SunoopDogg/airo-tips/index.md

---
title: index
type: overview
tags: [meta]
created: 2026-09-04
updated: 2026-10-07
status: developing
sources: []
---

# index

이 위키의 전 페이지 목록이다. 질의는 여기서 시작한다. 형식과 규약은 저장소 루트의 스키마 문서를 따른다.

### Overview

ESS(리튬 배터리 에너지저장장치) 열폭주 조기감지 개발 프로젝트의 지식 베이스. 원문이 `raw/`로 들어오면 인제스트를 거쳐 위키가 그 위에 인물·조직·제품·현상·지표·시험조건을 정리한다. **위키에는 인제스트된 원문에서 나온 내용만 담는다.**

프로젝트는 [[이스트오토]]가 발주하고 [[에어로랩]]이 수행하는 개발 용역이다. 개발 완료 검수 기준은 [[정량적 성과지표]] 다섯 항목을 모두 달성하는 것이고, 이 다섯이 사실상 프로젝트의 목표다.

### Topics

- [[에어로랩]] — 이 프로젝트의 개발 수행사. 계약상 "을".
- [[이스트오토]] — 발주사. 계약상 "갑"이며 하드웨어와 인증 경비를 부담한다.
- [[한국산업기술시험원]] — 지표 3 국내 성능수준의 출처이자 근거 문헌의 공동 연구기관.
- [[SEN55]] — 센시리온 환경센서 노드. 모의장치의 환경 센서로 확정, 3대 구매.
- [[ESP32-S3-WROOM-1]] — 에스프레시프 MCU 모듈(N16R8). SEN55 3대를 PCA9548A 경유로 읽어 USB로 PC에 중계하는 컨트롤러.
- [[PCA9548A]] — TI의 8채널 I2C 멀티플렉서. SEN55 3대의 주소 충돌을 채널 분리로 해결.
- [[P82B715]] — TI의 I2C 버스 익스텐더. PCA9548A~SEN55 배선 10 cm 초과 문제를 풀려고 채널마다 한 쌍씩 쓴다.
- [[정량적 성과지표]] — 검수 기준이 되는 다섯 개 목표치(비중 합 90%, 나머지는 제거된 항목). 이 프로젝트의 목표.
- [[불꽃검출 알고리즘]] — SIFT·스케일 기반 불꽃/연기 검출 AI. 지표 1·2를 담당한다.
- [[배터리 화재감지 5단계]] — 정상·비배터리화재·벤팅·열폭주·ESS화재 다섯 단계 분류 알고리즘. 지표 3.
- [[ESS-BMS 연동 데이터]] — BMS에서 수집해야 하는 7종 데이터. 지표 4.
- [[열폭주]] — 이 프로젝트가 막으려는 현상. 벤팅 이후 약 2분 만에 도달한다.
- [[벤팅 가스]] — 열폭주 직전의 마지막 뚜렷한 신호. 조기감지의 축이 되는 오프가스.
- [[모의장치]] — 지표 3 검수를 시연하는 밀폐 챔버 장치. SEN55 3대 + ESP32-S3 + 별도 카메라.
- [[EnerX-0.5P]] — CATL 상용 액체냉각 컨테이너 ESS. H2·CO·열·연기 조합 판정과 BMS 데이터의 참고 사례.
- [[VOC Index]] — 적응형 기준선 위의 1–500 상대 지표. 조건마다 상태를 복원하고 임계값으로 벤팅을 판정한다.

### Sources

- [[개발용역 계약서]] — 이스트오토·에어로랩 개발 용역 계약서. 용역범위와 검수 기준의 원천.
- [[정량적 성과지표 항목표]] — 다섯 지표의 근거·벤치마크·평가 방법 상세본.
- [[ESS 화재감지 알고리즘 (2023 추계학술발표논문집)]] — 최형석 외 2023. 지표 3 다섯 단계의 근거 문헌.
- [[Sensirion SEN5x Datasheet]] — SEN5x 제품군 데이터시트 V2-D1(2022-03). SEN55 사양의 출처.
- [[ESP32-S3-WROOM-1 & WROOM-1U Datasheet]] — 에스프레시프 모듈 데이터시트 v1.4(2024-11). 컨트롤러 사양의 출처.
- [[PCA9548A Datasheet]] — TI PCA9548A 데이터시트 SCPS143G(2021-03 개정). 멀티플렉서 사양의 출처.
- [[P82B715 Datasheet]] — TI P82B715 데이터시트 SCPS145B(2016-02 개정). 버스 익스텐더 사양과 풀업 설계 절차의 출처.
- [[EnerX-0.5P Battery Container Operating Instruction and Maintenance Manual]] — CATL EnerX-0.5P O&M 매뉴얼 Rev 1.0 초안(2024-08). 상용 ESS의 FSS·BMS 동작의 출처.
