SunoopDogg/airo-tips/log.md

---
title: log
type: overview
tags: [meta]
created: 2026-09-04
updated: 2026-10-07
status: developing
sources: []
---

# log

작업 이력. 새 항목은 맨 아래에 덧붙인다. 과거 항목은 고치지 않는다. 형식: `## [YYYY-MM-DD] ingest|query|lint | 대상`

## [2026-09-04] ingest | 개발용역 계약서 · 정량적 성과지표 항목표
계약서와 정량적항목 xlsx를 함께 읽어 [[개발용역 계약서]], [[정량적 성과지표 항목표]] source 페이지를 만들고 [[이스트오토]], [[에어로랩]], [[정량적 성과지표]], [[불꽃검출 알고리즘]], [[배터리 화재감지 5단계]], [[ESS-BMS 연동 데이터]]를 생성했다. 계약서 원문이 미서명 초안(계약기간·지급일·갑 서명란 공란)임을 기록하고, 지표 비중 합계가 90%에 그치는 문제를 [[정량적 성과지표]]에 남겼다. 다섯 항목이 알고리즘 출력 단계인지 시험 조건인지 두 원문이 어긋나는 점을 [[배터리 화재감지 5단계]] Contradictions에 기록.

## [2026-09-04] ingest | ESS 화재감지 알고리즘 (2023 추계학술발표논문집)
[[정량적 성과지표]] 지표 3의 근거 문헌인 최형석 외 2023 논문을 인제스트. [[ESS 화재감지 알고리즘 (2023 추계학술발표논문집)]] source 페이지와 [[열폭주]], [[벤팅 가스]], [[모의장치]], [[한국산업기술시험원]]을 생성했다. [[배터리 화재감지 5단계]]의 Contradictions를 해소 — 다섯 단계를 정상·비배터리화재·벤팅·열폭주·ESS화재로 확정하고, 계약서의 다습·먼지·고온은 오탐 내성을 보는 시험 조건임을 논문 근거로 판정했다. 먼지 신호가 오탐 조건이면서 동시에 열폭주 시그니처라는 설계 난점, 벤팅→열폭주 2분 24초 실측, 벤팅 시점에 산소·먼지·압력·LEL이 침묵한다는 점을 같은 페이지에 기록. [[ESS-BMS 연동 데이터]]에 전압 신호의 셀 형태 의존을, [[불꽃검출 알고리즘]]에 연기 채널이 단계 판정에서 맡는 자리를, [[정량적 성과지표]]와 [[정량적 성과지표 항목표]]에 지표 3 확정 사실과 인용 판본 차이를 추가했다. [[개발용역 계약서]]와 [[에어로랩]]의 용역범위 2항에도 이 다섯이 시험 조건이라는 주석을 달았다.

## [2026-09-07] ingest | Sensirion SEN5x Datasheet
SEN5x 데이터시트를 인제스트하고 [[Sensirion SEN5x Datasheet]], [[SEN55]], [[VOC Index]]를 생성. [[모의장치]]의 센서부를 SEN55 3대 확정으로 다시 쓰고(항목표의 센서 4종이 한 모듈로 접힘), 시험 조건(가습기·열풍기)과 센서 동작 조건(권장 10–40 °C / 20–80 %RH, 결로 금지)이 만나는 지점을 Contradictions로 기록. 센서 운용 미결 항목(벤팅 검출 규칙, 조건 사이 VOC 알고리즘 상태, 팬 자동 청소, 3대 배선, 온도 보정·가속 모드)을 같은 페이지에 추가. [[벤팅 가스]]의 "무엇으로 검출하는가" 절을 VOC Index 검출로 다시 쓰고, [[배터리 화재감지 5단계]]의 구현 차이 표를 SEN55 채널 매핑으로 갱신하면서 논문 진리표의 ○/✕를 만들 규칙이 없다는 점과 차동식 열감지기↔온도값의 차이를 기록. [[정량적 성과지표]] 지표 3에 센서 확정 사실을 추가.

## [2026-09-07] ingest | 사용자 확인 · 모의장치 센서 운용 결정
사용자 구두 확인으로 미결 항목을 정리. [[모의장치]]의 미결 목록을 "정해진 것/남은 것"으로 다시 씀 — SEN55 3대를 ESP 1대에 연결, 조건마다 VOC 알고리즘 상태 복원으로 같은 출발점, 벤팅 판정은 임계값 방식(값은 미정), RH/T 가속 모드 중, 조건당 45초, 팬 청소 무관, 챔버 밀폐 시험. Contradictions에 밀폐의 영향과 도달값 실측 방침을 추가. [[SEN55]], [[VOC Index]]에 같은 결정을 반영. [[배터리 화재감지 5단계]] Contradictions의 계약 문언 미결을 해소(계약서의 5단계 = 논문의 5단계). [[정량적 성과지표]], [[개발용역 계약서]], [[정량적 성과지표 항목표]]의 비중 10%를 제거된 여섯 번째 항목의 잔재로 확정. [[index]] 요약 세 줄 갱신.

## [2026-09-07] lint | 일반지식 확장 세 곳 정리
[[한국산업기술시험원]]의 "KTL·공공 시험·인증기관", [[에어로랩]]의 "Airo Lab", [[벤팅 가스]]의 "DEC(디에틸카보네이트)". [[정량적 성과지표]] 표의 "UL"을 항목표 원문 표기 Underwriters Laboratories로, "인제스트해 확정했다"를 주제 서술로 고침. [[벤팅 가스]]·[[열폭주]] 첫 문단 정의를 논문 표현으로 교체. 논문 source 페이지의 [[UL9540A]] 링크를 평문으로 풀고 `updated` 갱신.
## [2026-09-07] ingest | ESP32-S3-WROOM-1 & WROOM-1U Datasheet · 사용자 확인 · 컨트롤러 연결 결정
ESP32-S3 모듈 데이터시트 v1.4를 인제스트하고 [[ESP32-S3-WROOM-1 & WROOM-1U Datasheet]], [[ESP32-S3-WROOM-1]]을 생성. 사용자 확인으로 컨트롤러 결정 7건을 정리 — 변형 N16R8, 3대 연결은 HW I2C 2버스 + 소프트웨어 I2C 1버스, 모듈은 챔버 안 센서 옆, PC 연결은 USB Serial/JTAG CDC-ACM, SEN55 5 V는 USB VBUS 분기, VOC 상태 저장·복원은 PC가 명령하고 ESP는 중계, 카메라는 별도 장비. [[모의장치]]의 "정해진 것"을 이 결정으로 다시 쓰고 Contradictions에 모듈 65 °C 상한과 기판 결로를 추가. [[SEN55]] I2C 단락에 3.3 V 논리 레벨 호환과 배선 결정을, [[Sensirion SEN5x Datasheet]] 인터페이스 절에 Table 8 입력 레벨을, [[VOC Index]]에 상태 복원 주체를 추가. [[index]] 세 줄 갱신.

## [2026-09-07] ingest | 2023 논문 그림 4 온도 수치 보강
논문 PDF의 그림 4를 렌더링해 온도 눈금을 읽음. [[ESS 화재감지 알고리즘 (2023 추계학술발표논문집)]] 시험 A 결과와 [[열폭주]] 신호 거동에 벤팅 약 170–180℃, 열폭주 피크 약 550℃를 추가.

## [2026-09-07] ingest | PCA9548A Datasheet · 사용자 확인 · 멀티플렉서 연결 결정
PCA9548A 데이터시트 SCPS143G를 인제스트하고 [[PCA9548A Datasheet]], [[PCA9548A]]를 생성. 기존의 "HW I2C 2버스 + 소프트웨어 I2C 1버스" 연결 방식을 대체 — ESP32-S3 I2C 1버스를 PCA9548A에 물리고 채널 0~2에 SEN55 3대를 잇는다. 사용자 확인으로 주소는 A0=A1=A2=GND(0x70), RESET 핀은 VCC 풀업만, 배치는 챔버 안 ESP32·SEN55 옆으로 정함. [[ESP32-S3-WROOM-1]]의 "SEN55 3대 연결" 절과 배선 길이 서술을 다시 쓰고, [[SEN55]] I2C 단락과 [[모의장치]]의 "정해진 것"·Contradictions·관련 페이지를 갱신. [[index]] 두 줄 추가.

## [2026-09-07] ingest | 사용자 확인 · 전장 배치 변경(챔버 외부)
ESP32-S3-WROOM-1과 PCA9548A를 챔버 상단 외부로, SEN55 3대만 챔버 내부에 두는 것으로 배치를 바꿈. [[ESP32-S3-WROOM-1]]의 동작온도·배선 길이 서술과 [[PCA9548A]]의 배치 서술을 갱신. [[모의장치]]의 "정해진 것" 배치 항목을 다시 쓰고, 컨트롤러 결로 관련 Contradictions 항목을 PCA9548A~SEN55 배선이 챔버 벽을 가로지르며 10 cm 권고와 부딪히는 항목으로 교체, "남은 것"에 배선 길이·차폐 방식을 추가.

## [2026-09-07] ingest | P82B715 Datasheet · 사용자 확인 · 배선 연장 고려사항
TI P82B715 I2C 버스 익스텐더 데이터시트를 인제스트. [[P82B715 Datasheet]], [[P82B715]] 생성. PCA9548A~SEN55 배선 10 cm 초과 문제의 후보 해법으로 P82B715(채널당 한 쌍, VCC 5 V)와 차폐 케이블을 고려 중이며 둘 다 미확정임을 [[모의장치]]의 "남은 것"과 Contradictions, [[ESP32-S3-WROOM-1]]·[[PCA9548A]]·[[SEN55]]의 배선 서술에 반영.

## [2026-09-07] lint | 위키 2-type 이행 — topic + source
entity·concept·note를 topic 하나로 합치고 wiki/topics/로 옮김. 15개 페이지의 type과 위치가 바뀌었고 본문·제목·위키링크는 그대로다. CLAUDE.md의 type↔폴더 표를 3행으로 줄이고 "경계가 애매한 것들의 판정" 절을 삭제. index.md의 Entities·Concepts·Notes 세 절을 Topics 하나로 합침. check.py의 FOLDER·SECTION, wiki-lint·wiki-ingest·wiki-query의 폴더 참조를 맞춤.

## [2026-09-07] lint | source 페이지 정리 — 원문 밖 서술 제거
source 페이지 5건에서 원문 밖의 서술을 걷어냈다. [[ESS 화재감지 알고리즘 (2023 추계학술발표논문집)]]의 "이 위키에서의 위치"·"이 위키 관점에서의 한계"·인용 지침, [[정량적 성과지표 항목표]]와 [[개발용역 계약서]]의 교차 판정과 `(사용자 확인)`, [[Sensirion SEN5x Datasheet]]·[[ESP32-S3-WROOM-1 & WROOM-1U Datasheet]]의 프로젝트 서술이 대상이다. 삭제분은 전부 topic 페이지에 이미 인용과 함께 있고, 유일한 예외였던 표6 마지막 구간의 인위적 열자극 단서는 [[열폭주]]로 옮겼다. CLAUDE.md에 "source 페이지는 그 원문만 서술한다" 절을 추가.

## [2026-09-07] lint | 소프트랩 적용 — 저장소 전체 .md
CLAUDE.md와 wiki-ingest·wiki-lint·wiki-query 스킬 문서의 하드랩을 풀어 한 문단을 한 줄로 만들었다. 위키 페이지와 index.md는 이미 규칙을 지키고 있었고, 직전 로그 항목만 하드랩이라 함께 폈다. "한 문단은 한 줄" 규칙의 적용 범위를 위키 본문에서 저장소의 모든 .md로 넓혀 CLAUDE.md에 명시.

## [2026-09-08] ingest | EnerX-0.5P Battery Container Operating Instruction and Maintenance Manual
CATL EnerX-0.5P 컨테이너 O&M 매뉴얼(Rev 1.0 초안, 2024-08)을 인제스트. [[EnerX-0.5P Battery Container Operating Instruction and Maintenance Manual]], [[EnerX-0.5P]] 생성. 상용 ESS가 H2·CO·열·연기 검출기의 조합으로 등급을 나누고 가스를 최우선 트리거로 둔다는 점을 [[배터리 화재감지 5단계]]·[[벤팅 가스]]·[[열폭주]]에, 상용 BMS의 데이터·인터페이스·고장등급을 [[ESS-BMS 연동 데이터]]에, 참고 한 줄을 [[모의장치]]에 반영. 원문 내부의 수치 불일치(셀 구성·랙당 모듈 수·IMM 수·등급 수)는 source 페이지에 기록.

## [2026-10-06] ingest | 사용자 확인 · 모의장치 챔버 구성과 P82B715 채택
사용자가 확인한 챔버 형상 결정(더미 팩, 3030 프로파일과 알루미늄 복합판, 오른쪽 경첩의 앞면 여닫이 아크릴 도어와 토글 클램프, 양 옆면에서 마주 보는 주입·배기 포트, 캐스터 4개)을 [[모의장치]]의 새 "챔버 구성" 절에 반영. SEN55 3대의 천장 120° 대칭 배치를 [[모의장치]]·[[SEN55]]에, 전장 기판이 자체 PCB라는 것을 [[모의장치]]·[[PCA9548A]]에 추가. 고려 중이던 [[P82B715]] 채택을 [[P82B715]]·[[모의장치]]·[[PCA9548A]]·[[ESP32-S3-WROOM-1]]·[[SEN55]]와 index 요약에 반영하고, 차폐 케이블 사용 여부는 미정으로 남김.

## [2026-10-06] ingest | 사용자 확인 · 모의장치 더미 팩과 챔버 세부
[[모의장치]]의 "챔버 구성" 절에 더미가 본뜨는 ESS 모듈(32 kWh, 134.4 V, 22 A, LiFePO4, 1130 × 810 × 260 mm, 눕혀 놓음)과 패널 3 mm·아크릴 도어 8 mm, 경첩 3개·토글 클램프 2개·손잡이, 포트 높이, 브레이크 캐스터, SEN55 중심 거리를 천장 크기에 맞춘다는 결정을 추가.

## [2026-10-06] ingest | 사용자 확인 · 모의장치 팩 받침과 SEN55 케이블 경로
[[모의장치]]의 "챔버 구성" 절에 더미 팩을 3030 프로파일 세로 다리 레일 받침으로 100 mm 띄운다는 것, SEN55 한 대를 앞쪽에 두는 기준 방향, SEN55 케이블이 전장함 바로 아래에서 천장을 관통한다는 결정을 추가.

## [2026-10-06] ingest | 사용자 확인 · 모의장치 내부 치수와 포트 높이
[[모의장치]]의 "챔버 구성" 절에 팩 둘레 여유(앞 80, 뒤 80, 왼쪽 100, 오른쪽 150, 위 300 mm)와 그에 따른 내부 치수 1380 × 970 × 660 mm를 추가. 포트 높이를 옆면 가운데에서 팩 윗면과 천장의 가운데(510 mm)로 바꿈.

## [2026-10-07] ingest | Sensirion SEN5x Datasheet · 외형 치수
이미 인제스트한 데이터시트의 7.1절 외형도(Figure 7)를 다시 읽어 [[Sensirion SEN5x Datasheet]]에 "외형 치수" 절을 추가하고, [[SEN55]]에 "외형" 절(52.3 × 43.3 mm, 두께 최대 22.3 mm·본체 13.2 mm, 무게 36.4 g)을 추가. 외형도는 그림이라 텍스트 추출이 되지 않아 페이지를 렌더링해 읽었다.

## [2026-10-07] ingest | 사용자 확인 · 모의장치 패널 체결, 도어 개구, SEN55 배치, 받침 레일
[[모의장치]]의 "챔버 구성" 절에 패널을 골조 바깥면에 스프링 너트와 볼트로 덧대는 것, 도어 개구 1230 × 460 mm, SEN55 반지름(천장 짧은 변의 1/4)과 천장 이격 20 mm, 받침 레일 구성(깊이 방향 2줄, 팩 끝에서 100 mm 안쪽)을 추가. [[SEN55]]에 브래킷 이격 한 문장을 추가.

## [2026-10-07] ingest | 사용자 확인 · 모의장치 골조 이음, 바닥, 도어 철물, 포트 구경, 전장부
모의장치 부품 형상에 남아 있던 결정을 받았다. [[모의장치]]의 챔버 구성에 3030 단면과 골조 이음, 바닥 패널과 보강재, 도어 겹침·밀폐재·경첩·손잡이, 토글 래치로 바꾼 잠금, 포트 구경, 캐스터 크기를 넣었다.
같은 절에 SEN55 브래킷의 부착면·자세·고정 방식, 전장함 위치, 케이블 글랜드, 전장 기판 외곽을 추가하고 [[P82B715]] 센서측 기판 위치를 연결했다.

## [2026-10-07] ingest | 사용자 확인 · 모의장치 도어 잠금 철물
도어 잠금을 당기는 토글 래치에서 누름형 토글 클램프로 되돌렸다. 래치를 도어 앞면과 같은 평면에 달면 도어를 옆으로만 당기고 밀폐재 쪽으로 누르지 못하기 때문이다. [[모의장치]]의 챔버 구성 절을 고쳤다.
