SunoopDogg/airo-tips/cad/chamber.md

# 챔버 파라미터 대장

챔버 치수 하나하나에 대해 값과 상태와 근거를 적는다. 아래 표의 변수명은 `src/params.py`의 상수명과 같게 쓴다. 상태 어휘는 셋이다.

- `fixed` — 근거와 함께 확정된 값. `src/params.py`에 상수로 들어간다.
- `dependent` — 아직 값은 없지만 무엇이 정해지면 따라 정해지는지가 분명한 값. `src/params.py`에는 다른 상수로 계산하는 식으로 들어가고, 수치를 지어내지 않는다.
- `unknown` — 근거도 종속 조건도 아직 없는 값. 결정을 기다리며 `src/params.py`에 넣지 않는다.

값을 채울 때는 근거를 함께 적는다. 근거는 위키에 이미 서술된 사실이거나 사용자가 직접 결정한 값이어야 하고, 후자는 `사용자 결정 2026-09-10`처럼 결정한 날을 적는다.

## 위키가 확정한 형상 제약

수치는 아니지만 형상을 구속하는 사실들이다. 출처는 전부 `wiki/topics/모의장치.md`다.

| 제약 | 상태 |
|---|---|
| 도어를 통해 열고 닫을 수 있다 | fixed (사용자 확인 2026-09-04) |
| 시험은 밀폐 상태로 진행한다 | fixed (사용자 확인 2026-09-07) |
| SEN55 3대를 챔버 내부에 직접 노출되도록 둔다 | fixed (사용자 확인 2026-09-07) |
| ESP32-S3-WROOM-1과 PCA9548A는 챔버 상단 외부에 둔다 | fixed (사용자 확인 2026-09-07) |
| 전원과 통신은 USB 하나로 통합한다 | fixed (사용자 확인 2026-09-07) |
| 다섯 조건을 가습기 · 청소기 · 송풍기 · DEC 분사 · 열풍기로 조성한다 | fixed (정량적 성과지표 항목표) |
| 조건 사이에 이전 조건을 빼내는 환기 절차가 필요하다 | fixed (사용자 확인 2026-09-07) |
| 카메라는 이 장치와 별개의 장비다 | fixed (사용자 확인 2026-09-04) |

두 제약이 서로 당긴다. 전장이 챔버 상단 외부이고 SEN55는 챔버 내부이므로 I2C 배선이 챔버 벽을 가로지르며, SEN5x 데이터시트의 10 cm 미만 권고를 넘기기 쉽다. 케이블 관통 위치와 센서 위치를 정할 때 이 거리가 함께 결정된다.

## 사용자가 결정한 형상

근거는 전부 사용자 결정(2026-10-06, 2026-10-07)이고, 같은 결정이 `wiki/topics/모의장치.md`의 "챔버 구성" 절에도 들어가 있다.

| 결정 | 상태 |
|---|---|
| 시료 팩은 실제 배터리가 아니라 ESS 배터리 모듈 하나의 외형만 본뜬 더미이고, 높이가 가장 작은 변이 되도록 눕혀 놓는다 | fixed |
| 외함은 알루미늄 프로파일 3030 골조 바깥면에 알루미늄 복합판 패널을 스프링 너트와 볼트로 덧댄다 (2026-10-07) | fixed |
| 받침 프레임 없이 바닥 프로파일에 캐스터 4개를 직접 단다 | fixed |
| 도어는 앞면 여닫이이고, 경첩 3개를 앞에서 보아 오른쪽 변의 위·가운데·아래에 단다 | fixed |
| 도어는 왼쪽 변 위·아래의 토글 클램프 2개로 밀폐재에 눌러 잠그고, 손잡이를 따로 왼쪽 변 가운데에 단다 | fixed |
| 캐스터 4개는 모두 브레이크가 달린 것이다 | fixed |
| 주입·배기 포트는 둘 다 팩 윗면과 천장의 가운데 높이에 낸다. 처음 정한 "옆면 높이의 가운데"를 바꾼 것이다 | fixed |
| 팩 둘레 여유는 앞 80, 뒤 80, 왼쪽(배기) 100, 오른쪽(주입) 150, 위 300 mm다 | fixed |
| SEN55의 천장 중심 거리는 천장 짧은 변의 1/4이고, 천장에서 20 mm 띄운다 (2026-10-07) | fixed |
| SEN55 세 대 중 한 대는 앞쪽(도어 쪽), 두 대는 뒤쪽 좌·우에 놓는다 | fixed |
| 더미 팩은 3030 프로파일 레일 받침 위에 올린다. 레일은 깊이 방향 2줄, 중심이 팩 좌우 끝에서 100 mm 안쪽이고, 줄마다 세로 다리 2개를 단다 (2026-10-07) | fixed |
| 도어 개구는 앞면 전체가 아니라 바닥부터 시작해 팩 좌우로 50 mm, 팩 윗면 위로 100 mm를 둔 크기다 (2026-10-07) | fixed |
| SEN55 케이블은 전장함 바로 아래에서 천장을 관통한다 | fixed |
| 도어 판 전체를 아크릴로 하고 관찰창을 따로 두지 않는다. 카메라와 그 고정부는 만들지 않는다 | fixed |
| SEN55 3대는 천장에 두고, 천장 중심에서 같은 거리에 120° 간격으로 대칭 배치한다 | fixed |
| 공용 주입 포트는 앞에서 보아 오른쪽 옆면, 배기 포트는 왼쪽 옆면에 마주 보게 둔다 | fixed |
| 전장 기판은 자체 PCB다 | fixed |
| P82B715 버스 익스텐더를 쓴다 | fixed |
| 3030 프로파일은 B형 슬롯 8 단면이다. step.parts `profile_3030_b_slot8`의 단면을 부재 길이만큼 늘인다 (2026-10-07) | fixed |
| 골조는 세로재 4개를 통짜로 두고 폭·깊이 방향 수평재를 그 사이에 넣는다. 이음은 step.parts `corner_bracket_3030_single_simple`(L자, 날개 45 × 45, 폭 30)을 수평재 끝마다 1개, 챔버 안쪽 모서리에 둔다. 처음 정한 `extrusion_3030_slot8_inside_corner_bracket_standard`는 L자가 아닌 50 × 30 × 3 평판이라 바꿨다. 레일과 다리의 이음 브래킷은 그리지 않는다 (2026-10-07) | fixed |
| 도어 개구 둘레에는 골조 부재를 따로 두지 않는다 (2026-10-07) | fixed |
| 바닥에도 패널을 대고, 레일 밑에 깊이 방향 3030 보강재 2개를 넣어 받침 다리를 그 위에 세운다. 다리는 레일 양 끝에 단다 (2026-10-07) | fixed |
| 패널은 여섯 면 모두 골조 바깥면 크기 그대로이고, 골조 볼트·도어 개구·포트·글랜드 구멍만 뚫는다. 철물을 다는 볼트 구멍은 각 철물 모델에서만 보인다 (2026-10-07) | fixed |
| 도어 판은 개구 둘레에 30 mm씩 겹친다. 밀폐재는 앞면 패널 바깥면의 개구 둘레, 겹침 폭의 가운데에 붙이는 EPDM 스펀지 사각 단면이며 모서리는 각지게 둔다. 도어는 밀폐재에 닿은 압착 전 상태로 그린다 (2026-10-07) | fixed |
| 경첩은 50 × 50 맞대기 경첩 3개다. step.parts `butt_hinge_50x50`은 날개 폭이 0.05 mm인 결함 모델이라, 펼친 전체 50 × 50(날개 하나 25 × 50)의 대표 형상을 직접 그리고 날개 두께·너클 지름은 작업 가정으로 둔다(루프 중 추천안 자동 선택 2026-10-07, 사용자 확인 대기). 위·아래 경첩 중심은 도어 판 끝에서 50 mm, 가운데 경첩은 판 높이의 중앙이다. 프레임 쪽 날개는 도어 판 앞면과 같은 평면이 되도록 앞면 패널 위의 받침 블록에 단다 (2026-10-07) | fixed |
| 잠금은 누름형 토글 클램프 2개다. 도어 왼쪽의 앞면 패널에 달고, 스핀들이 도어 판 앞면을 +y로 눌러 밀폐재를 압착한다. 위·아래 중심은 도어 판 끝에서 50 mm다. step.parts에 없어 대표 형상을 직접 모델링하고, 그 치수는 작업 가정으로 두었다가 확인받는다. 같은 평면에 단 토글 래치는 도어를 옆으로만 당겨 밀폐재를 누르지 못해 처음 정한 클램프로 되돌렸다 (2026-10-07) | fixed |
| 손잡이는 장착 구멍 간격 128 mm 당김 손잡이를 세로로 단다. step.parts `pull_handle_mount_spacing128`은 손잡이 봉이 기둥에서 2 mm 떠 있는 결함 모델이라 대표 형상을 직접 그리고 기둥·봉 치수는 작업 가정으로 둔다(루프 중 추천안 자동 선택, 사용자 확인 대기). 중심은 도어 판 왼쪽 끝에서 40 mm 안쪽, 판 높이의 중앙이다 (2026-10-07) | fixed |
| 캐스터는 바퀴 지름 100 mm, 브레이크 달린 회전 캐스터 4개다. step.parts `locking_swivel_caster_wheel_d100`은 바퀴가 장착판을 뚫고 올라오는 결함 모델이라 대표 형상을 직접 그리고 장착판·포크·높이·브레이크 치수는 작업 가정으로 둔다(루프 중 추천안 자동 선택, 사용자 확인 대기). 바닥 패널 아래 네 모서리에 달고, 장착판 바깥 모서리를 외형 모서리에 맞춘다 (2026-10-07) | fixed |
| 주입·배기 포트는 내경 50 mm 알루미늄 관을 옆면 깊이 가운데에 플랜지로 달고 끼움형 마개로 닫는다. 관 안쪽 끝은 옆면 패널 안쪽 면과 같은 면이다 (2026-10-07) | fixed |
| SEN55 브래킷은 천장 패널 안쪽 면에 M4 볼트 2개로 달고, 20 mm 이격도 이 면에서 잰다. PETG 3D 프린트다 (2026-10-07) | fixed |
| SEN55는 큰 면을 천장과 평행하게, 평평한 면을 위로 두고 커넥터가 천장 중심을 향하게 단다. 브래킷이 모듈의 긴 변 두 가장자리를 클립으로 감싸고, 커넥터 쪽과 아래는 열어 둔다 (2026-10-07) | fixed |
| P82B715 센서측 기판은 SEN55 브래킷 옆면에 M3 나사 2개로 단다. 판과 구멍만 그리고 소자는 그리지 않는다 (2026-10-07) | fixed |
| 전장함은 천장 중심에 둔다. 케이블마다 M20 케이블 글랜드를 하나씩, 천장 중심 기준 x 방향 한 줄로 낸다. 글랜드 몸체는 챔버 안쪽, 잠금 너트는 전장함 바닥 위에 두어 천장 패널과 전장함 바닥을 함께 조인다 (2026-10-07) | fixed |
| 전장 기판은 USB-C로 PC와 잇는다. ESP32 모듈은 벤더 STEP을 앞쪽 변에, USB-C는 외곽 블록으로 뒤쪽 변 가운데에 놓고 나머지 소자는 그리지 않는다 (2026-10-07) | fixed |
| 전장함은 PETG 3D 프린트 몸체와 뚜껑이다. 기판을 바닥 스탠드오프 위에 올리고, 뒤쪽 벽에 USB 구멍을, 바닥에 글랜드 구멍을 낸다 (2026-10-07) | fixed |

## 치수 대장

2026-10-07에 남아 있던 형상 결정을 모두 받아, 모델링에 필요한 치수가 전부 `fixed`이거나 `fixed` 값에서 계산되는 `dependent`다. 아래에서 `unknown`으로 남은 밀폐 등급과 케이블 외경은 형상을 바꾸지 않는다. 경첩·토글 클램프·손잡이·캐스터·글랜드는 step.parts 범용 모델이 결함이거나 없어서 대표 형상을 직접 그렸고 형상 치수는 작업 가정이다. 실제 구매품이 정해지면 그 STEP으로 바꾼다.

| 변수 | 뜻 | 상태 | 근거 · 정해지려면 |
|---|---|---|---|
| `pack_W` `pack_D` `pack_H` | 더미 팩 외형 (폭 × 깊이 × 높이) | fixed — 1130 × 810 × 260 mm | 사용자 결정 2026-10-06. 본뜨는 모듈의 사양서가 없어 사용자가 제시한 값이다 (`wiki/topics/모의장치.md`). 눕혀 놓으므로 260이 높이다. 다른 모든 치수의 출발점이다 |
| `pack_N` | 더미 팩 수량 | fixed — 1 | 사용자 결정 2026-10-06 |
| `rail_H` | 바닥에서 더미 팩 밑면까지의 받침 높이 | fixed — 100 mm | 사용자 결정 2026-10-06. 3030 프로파일 세로 다리로 맞춘다 |
| 받침 레일 | 깊이 방향 3030 레일 2줄 | dependent — 중심 x 200·1130 mm, y 80–890, z 70–100 mm | 레일 중심은 팩 좌우 끝에서 100 mm 안쪽, 길이는 `pack_D`, 윗면은 `rail_H` (사용자 결정 2026-10-07) |
| 받침 다리 | 레일마다 세로 다리 2개 | dependent — 높이 70 mm, y 80–110 · 860–890 mm, z 0–70 mm | 높이는 `rail_H` − `prof_W`. 레일 양 끝에 단다 (사용자 결정 2026-10-07) |
| 바닥 보강재 | 레일 밑 깊이 방향 3030 2개 | dependent — 중심 x 200·1130 mm, y 0–970, z −30–0 mm | 레일 중심과 같은 x, 바닥 앞뒤 수평재 사이 (사용자 결정 2026-10-07) |
| `clr_bottom` | 팩 아래 여유 | dependent | `rail_H`와 같다 |
| `clr_front` `clr_back` | 팩 앞·뒤 여유 | fixed — 80 mm, 80 mm | 사용자 결정 2026-10-06. 앞은 레일 위로 팩을 밀어 넣을 손 여유와 도어 밀폐재와의 간격, 뒤는 기류 통로 |
| `clr_left` `clr_right` | 팩 왼쪽(배기)·오른쪽(주입) 여유 | fixed — 100 mm, 150 mm | 사용자 결정 2026-10-06. 주입 쪽은 분무·열풍이 팩에 닿기 전에 퍼질 거리 |
| `clr_top` | 팩 위 여유 | fixed — 300 mm | 사용자 결정 2026-10-06. 천장 SEN55 아래 기류층. 밀폐 챔버 부피를 작게 하려고 450 mm 안 대신 골랐다 |
| `W_in` `D_in` `H_in` | 내부 유효 치수 | dependent — 1380 × 970 × 660 mm | `W_in` = `clr_left` + `pack_W` + `clr_right`, `D_in` = `clr_front` + `pack_D` + `clr_back`, `H_in` = `rail_H` + `pack_H` + `clr_top` |
| 팩 위치 | 원점 기준 팩 외곽 | dependent — x 100–1230, y 80–890, z 100–360 mm | 여유와 받침 높이에서 나온다 |
| `prof_W` | 골조 프로파일 단면 한 변 | fixed — 30 mm | 사용자 결정 2026-10-06 (3030 규격) |
| 골조 부재 | 3030 부재 배치 | dependent — 세로재 4개 720 mm (z −30–690), 폭 방향 4개 1380 mm (x 0–1380), 깊이 방향 4개 970 mm (y 0–970) | 세로재 통짜, 수평재는 그 사이 (사용자 결정 2026-10-07). 골조 바깥 외곽은 x −30–1410, y −30–1000, z −30–690 mm |
| `t_panel` | 알루미늄 복합판 패널 두께 | fixed — 3 mm | 사용자 결정 2026-10-06 |
| 패널 볼트 | 패널을 골조에 잡는 볼트와 구멍 | fixed — M6, 구멍 Ø6.5, 간격 200 mm 이하 | 패널 뒤 부재(보강재 포함)의 중심선 위에, 패널 모서리에서 30 mm 띄우고 그 사이를 고르게 나눈다 (사용자 결정 2026-10-07). 앞면 패널 아래 변은 밀폐재가 지나므로 밀폐재 밖인 양 끝(x 0, 1380)에만 낸다 (사용자 결정 2026-10-07) |
| `W_out` `D_out` `H_out` | 외형 치수 | dependent — 1446 × 1036 × 726 mm | 내부 유효 치수 + 양쪽 `prof_W` + 양쪽 `t_panel`. 앞면 도어 판과 철물, 캐스터는 제외 |
| 밀폐 등급 | 외함과 도어의 IP 등급 | unknown | DEC 분무와 열풍에 견디는 조건 |
| `door_W` `door_H` | 도어 개구 | fixed — 1230 × 460 mm, x 50–1280, z 0–460 mm | 사용자 결정 2026-10-07. 팩 좌우 50 mm, 팩 윗면(360) 위 100 mm |
| `door_overlap` | 아크릴 도어 판이 개구 둘레에 겹치는 폭 | fixed — 30 mm | 사용자 결정 2026-10-07 |
| 도어 판 | 아크릴 판 외곽 | dependent — 1290 × 520 mm, x 20–1310, z −30–490, y −51–−43 mm | 개구 + 양쪽 `door_overlap`. y는 앞면 패널 바깥면(−33)에서 `gasket_T`와 `t_door`만큼 앞 |
| `t_door` | 아크릴 도어 판 두께 | fixed — 8 mm | 사용자 결정 2026-10-06. 조건 4·5의 실제 도달 온도를 재서 아크릴로 충분한지는 확인해야 한다 |
| `gasket_W` `gasket_T` | 밀폐재 단면 (폭 × 두께) | fixed — 15 × 10 mm | 사용자 결정 2026-10-07. EPDM 스펀지 |
| 밀폐재 위치 | 사각 링의 외곽 | dependent — 바깥 x 27.5–1302.5, z −22.5–482.5, 안쪽 x 42.5–1287.5, z −7.5–467.5, y −43–−33 mm | 개구 가장자리에서 7.5–22.5 mm, 즉 겹침 폭의 가운데 |
| `t_spacer` | 경첩 받침 블록 두께 | dependent — 18 mm | `gasket_T` + `t_door`. 날개가 도어 판 앞면과 같은 평면이 된다 (사용자 결정 2026-10-07). 블록이 패널 볼트 구멍 위에 오면 블록 밑면에 M6 버튼 볼트 머리 자리 Ø11 × 깊이 4 mm를 판다 (사용자 결정 2026-10-07) |
| 경첩 모델 | 오른쪽 경첩 3개의 제품 | fixed — 50 × 50 맞대기 경첩, 대표 형상 직접 모델링(날개 하나 25 × 50) | 크기와 자리는 사용자 결정 2026-10-07. step.parts 모델 결함으로 직접 그린다(추천안 자동 선택, 사용자 확인 대기). 중심 z 440 · 230 · 20 mm (판 끝에서 50 mm, 판 높이 중앙) |
| 토글 클램프 모델 | 왼쪽 클램프 2개 | fixed — 누름형, 대표 형상 직접 모델링 | 사용자 결정 2026-10-07. 중심 z 440 · 20 mm. 형상 치수는 작업 가정이고 구매품이 정해지면 그 STEP으로 바꾼다 |
| 손잡이 모델 | 왼쪽 변 가운데의 손잡이 | fixed — 장착 구멍 간격 128 mm 당김 손잡이, 대표 형상 직접 모델링 | 간격과 자리는 사용자 결정 2026-10-07. step.parts 모델 결함으로 직접 그린다(추천안 자동 선택, 사용자 확인 대기). 세로, 중심 x 60, z 230 mm, 기둥 축 z 166 · 294 |
| 캐스터 모델 · 바퀴 지름 | 브레이크 달린 캐스터 4개 | fixed — 바퀴 지름 100 mm 브레이크 달린 회전 캐스터, 대표 형상 직접 모델링 | 지름과 자리는 사용자 결정 2026-10-07. step.parts 모델 결함으로 직접 그린다(추천안 자동 선택, 사용자 확인 대기). 바닥 패널 아랫면(z −33)에 달고 장착판 바깥 모서리를 외형 모서리에 맞춘다 |
| `port_z` | 주입·배기 포트 중심 높이 | dependent — 510 mm | `rail_H` + `pack_H` + `clr_top` / 2. 팩 윗면과 천장의 가운데 (사용자 결정 2026-10-06) |
| 포트 평면 위치 | 주입·배기 관 중심 | fixed — y 485 mm, z `port_z` | 옆면 깊이 가운데 (사용자 결정 2026-10-07). 주입은 오른쪽 패널(x 1410–1413), 배기는 왼쪽 패널(x −33–−30) |
| `inlet_dia` `exhaust_dia` | 주입 · 배기 관 내경 | fixed — 50 mm, 50 mm | 사용자 결정 2026-10-07 |
| 포트 세부 | 관·플랜지·마개 | fixed — 관 벽 3 mm(외경 56), 패널 바깥 돌출 50 mm, 플랜지 외경 100 × 두께 5 mm, M5 구멍 4개 PCD 80 mm, 마개 벽 3 · 깊이 20 mm | 사용자 결정 2026-10-07. 관 안쪽 끝은 패널 안쪽 면. M5 통과 구멍은 Ø5.5(M6 Ø6.5와 같은 0.5 mm 틈새), 마개 끝판 두께는 마개 벽과 같은 3 mm로 코디네이터가 맞췄다(사용자 확인 대기) |
| 케이블 관통 위치 | 천장 위 관통부의 평면 위치 | fixed — 천장 중심 (690, 485)을 기준으로 x 방향 한 줄 | 전장함 바로 아래 (사용자 결정 2026-10-06), 전장함을 천장 중심에 둔다 (사용자 결정 2026-10-07) |
| 글랜드 | 케이블 관통부 제품과 간격 | fixed — M20 글랜드 3개, 간격 30 mm, 대표 형상 직접 모델링 | 간격과 배치는 사용자 결정 2026-10-07. step.parts `cable_gland_body_m20`은 외경 44 × 높이 28 관 하나로 된 외곽 모델이라 간격 30에도 전장함 안에도 들어가지 않아, 토글 클램프처럼 대표 형상을 직접 그리고 형상 치수는 작업 가정으로 둔다(루프 중 추천안 자동 선택 2026-10-07, 사용자 확인 대기). 너트의 꼭짓점 간 거리는 30 mm 미만, 잠금 너트 높이는 전장함 바닥 윗면(z 695)에서 기판 밑면(z 705)까지 10 mm 미만이어야 한다. 패널·전장함 바닥 구멍은 step.parts `cable_gland_panel_hole_cutter_m20`의 안지름 Ø20 |
| `cable_dia` | 케이블 외경 | unknown | 선정된 케이블의 외경. M20 글랜드의 조임 범위 안에 들어야 한다 |
| `sen_L` `sen_W` `sen_T` | SEN55 모듈 외형 | fixed — 52.3 × 43.3 × 22.3 mm (본체 두께 13.2) | `wiki/topics/SEN55.md` (데이터시트 Figure 7). 공차 ±0.4, 폭은 +0.2/−0.6 |
| SEN55 장착 자세 · 고정 방식 | 어느 면이 아래를 보는지, 브래킷에 어떻게 고정하는지 | fixed — 수평, 평평한 면이 위, 커넥터가 천장 중심 쪽, 긴 변 클립 | 사용자 결정 2026-10-07 |
| SEN55 높이 | 모듈 윗면 | dependent — z 670 mm | 천장 패널 안쪽 면(z 690) − `sen_gap` |
| `brk_wall` | SEN55 브래킷 벽 두께 | fixed — 2.5 mm | 사용자 결정 2026-10-07. PETG 3D 프린트, 천장 패널에 M4 볼트 2개. M4 통과 구멍은 Ø4.5(M6 Ø6.5와 같은 0.5 mm 틈새로 코디네이터가 맞춤, 사용자 확인 대기) |
| `ext_W` `ext_D` | P82B715 센서측 기판 | fixed — 30 × 20 × 1.6 mm | 사용자 결정 2026-10-07. M3 구멍 2개(전장 기판과 같은 Ø3.2), 짧은 변에서 4 mm, 긴 변 중심선 위 |
| `sen_r` | 천장 중심에서 각 SEN55까지의 거리 | dependent — 242.5 mm | `D_in` / 4. 천장 짧은 변의 1/4 (사용자 결정 2026-10-07) |
| SEN55 평면 위치 | 세 대의 중심 | dependent — (690, 242.5), (479.99, 606.25), (900.01, 606.25) mm (x는 소수 둘째 자리 반올림) | 천장 중심 (690, 485)에서 `sen_r`, `sen_phi`와 120° 간격 |
| `sen_phi` | 120° 배치에서 첫 대가 놓이는 방향 | fixed — 앞쪽(−y, 도어 쪽) | 사용자 결정 2026-10-06 |
| `sen_gap` | 천장 부착면에서 모듈을 띄우는 거리 | fixed — 20 mm | 사용자 결정 2026-10-07 |
| `pcb_W` `pcb_D` `pcb_T` | 전장 기판 | fixed — 80 × 60 × 1.6 mm | 사용자 결정 2026-10-07. M3 구멍 Ø3.2 4개, 모서리에서 4 mm. USB-C 외곽 블록 9 × 7.5 × 3.3 mm |
| 전장함 세부 | 벽·여유·높이 | fixed — 벽 2, 기판 둘레 여유 5, 안쪽 높이 25, 뚜껑 2 mm. 스탠드오프 높이 10 · Ø6 (M3). USB 구멍 12 × 7 mm | 사용자 결정 2026-10-07 |
| `elec_W` `elec_D` `elec_H` | 전장함 바깥 | dependent — 94 × 74 × 29 mm, 중심 (690, 485), 천장 패널 윗면(z 693) 위 | 기판 + 양쪽 여유 + 양쪽 벽, 높이는 바닥 + 안쪽 높이 + 뚜껑 |

사슬은 위에서부터 채워졌다. 더미 팩 외형과 둘레 여유가 내부·외형 치수를 정하고, 골조·패널·도어·포트·센서·전장부의 형상이 그 위에 놓인다.
