SunoopDogg/airo-tips/raw/market-survey/2026-10-08-조사-상용-밀폐챔버.md

# 2026-10-08 조사 — 모의장치 챔버와 크기가 비슷한 상용 챔버

2026-10-08에 Claude(Claude Code)가 사용자 요청으로 웹 검색과 제조사·판매처 페이지 열람으로 모은 조사 기록이다. 제조사·판매처 페이지에 적힌 것을 옮긴 "제품별 원문 기록"과 조사자(Claude)의 판단인 "조사자 판단"을 나눠 적는다. 열람한 페이지와 데이터시트는 이 폴더에 함께 보관했다.

## 조사 질문과 기준

질문은 "모의장치 챔버와 크기가 비슷하거나 조금 큰 챔버가 실제 상용품으로 팔리는가"이다.

비교 기준은 `wiki/topics/모의장치.md`에 적힌 값이다. 챔버 내부는 폭 1380 × 깊이 970 × 높이 660 mm(약 883 L)이고, 더미 팩은 1130 × 810 × 260 mm로 높이가 260 mm가 되게 눕혀 놓는다.

- 팩이 들어간다는 것은 내부 바닥에 1130 × 810이 어느 방향으로든 놓이고 높이가 260 mm 이상이라는 뜻으로 본다. 문 통과는 문 크기가 공개된 제품만 따졌다.
- 수치는 열람한 페이지에 적힌 것만 옮겼다. 검색 엔진 요약에만 나온 수치는 쓰지 않았다.
- 전수 조사가 아니다. 가격은 대부분 공개되지 않았다. 기밀 등급과 먼지·분무 내성은 어느 페이지에도 없었다.

## 제품별 원문 기록

백틱 안의 문구는 페이지에 적힌 그대로다. 확인일은 모두 2026-10-08이고, 보관 파일은 그날 받은 그대로다.

### 원테크놀로지(Won Tech) WTH 시리즈 — 대형 항온항습 챔버 (국산)

- 출처: http://www.tech-w.co.kr/sub/sub02_01.php?mode=view&idx=51&cat_no=2&offset=
- 보관 파일: `tech-w.co.kr-WTH-대형항온항습챔버.html`
- 규격표의 `Dimensions w*d*h/mm (In)` 행: WTH-1200 `1000 * 1200 * 1000`, WTH-1540 `1100 * 1475 * 950`, WTH-1700 `1000 * 1000 * 1700`, WTH-6000 `2400 * 1400 * 1800`.
- 온습도 범위: `-20 ℃ ∼ 150 ℃ / 30% ∼ 95%RH (Option : -40 ℃ ∼ 150 ℃ / -70 ℃ ∼ 180 ℃ )`.
- 적용분야에 `이차전지(모듈/팩)`이 들어 있다.
- 페이지에 없는 것: 치수가 내부인지 외부인지, 문 크기, 관찰창, 포트, 가격.

### CSZ Z-Plus — 항온항습 챔버 (미국)

- 출처: https://www.cszindustrial.com/Products/Temperature-Humidity-Chambers/Z-Plus.aspx
- 보관 파일: `cszindustrial.com-Z-Plus.html`
- 크기: `8, 16, 32, 44, 64, 80 or 96 cu. ft. (230L, 450L, 900L, 1250L, 1810L, 2265L, 2718L)`.
- `Interior Workspace Dimensions (WxDxH)` 표:

| 모델 | 내부 (W × D × H) | 외부 (W × D × H) |
|---|---|---|
| ZP (H) -8 | 24" x 24" x 24" (61cm x 61cm x 61cm) | 36.5" x 56.5" x 76" (93cm x 143.5cm x 193cm) |
| ZP (H) -16 | 30" x 30" x 30" (76cm x 76cm x 76cm) | 42.5" x 62.5" x 82" (108cm x 159cm x 208cm) |
| ZP (H) -32 | 38" x 38" x 38" (97cm x 97cm x 97cm) | 50.5" x 70.5" x 91.5" (128cm x 179cm x 232cm) |
| ZP (H) -44 | 44"W x 38"D x 46"H (112cm x 97cm x 117cm) | 56.5"W x 80.5"D x 99.5"H (144cm x 204cm x 253cm) |
| ZP (H) -64 | 48"W x 48"D x 48"H (122cm x 122cm x 122cm) | 60.5"W x 80.5"D x 101.5"H (154cm x 204cm x 258cm) |
| ZP (H) -80 | 48"W x 60"D x 48"H (122cm x 152cm x 122cm) | 60.5"W x 92.5"D x 101.5"H (154cm x 235cm x 258cm) |
| ZP (H) -96 | 48"W x 72"D x 48"H (122cm x 183cm x 122cm) | 60.5"W x 104.5"D x 101.5"H (154cm x 265cm x 258cm) |

- 기본 사양: `Single-handed, lockable door latch`, `Two, 4" (10 cm) circular ports`, `Large, fog-free viewing window & interior light`.
- 포트 위치: `Two, 4" (10 cm) ports are centered on the left and right side of the chamber for ease of cable routing.`
- 페이지에 없는 것: 문 크기, 가격.

### Memmert HPP1060eco — 펠티어 항온항습 챔버 (독일)

- 출처: https://www.memmert.com/en/products/climate-chambers/constant-climate-chamber/hpp1060eco-2
- 보관 파일: `memmert.com-HPP1060eco.html`
- 내부: `w (A) x h (B) x d (C) : 1040 x 1200 x 850 mm (d less 32 mm for fan - Peltier)`, 용적 `1060 l`.
- 외부: `w (D) x h (E) x d (F) : 1224 x 1720 x 1005 mm (d +56mm door handle & +111mm Peltier element)`.
- 문: `fully insulated stainless steel doors with 2-point locking (compression door lock)`.
- 포트: `Entry port (silicone), 18 mm clear diameter, moisture tight, can be closed by silicone stopper, in the side panel, centre left`.
- 적재: `Max. loading of chamber 200 kg`.
- 페이지에 없는 것: 가격.

### Binder KBF 1020 — 항온항습 챔버 (독일)

- 출처: https://www.binder-world.com/fileadmin/shop/1.d/files/9/9/99705eb1_Data-Sheet-Model-KBF-1020-us.pdf (데이터시트 `As of: 27.04.2022`, 미국판)
- 보관 파일: `99705eb1_Data-Sheet-Model-KBF-1020-us.pdf`
- 내부: `Width [in] 38.34`, `Height [in] 49.3`, `Depth [in] 32.94`, `Interior volume [cu.ft.] 36`. 이 판은 인치만 적는다.
- 외부: `Width net [in] 49.3`, `Height net [in] 75.8`, `Depth net [in] 45.1`.
- 문: `Tight-sealing inner door made of safety glass (ESG)`, `Inner doors 2`, `Unit doors 2`.
- 포트: `Access port with silicone plug, 30 mm, left`.
- 범위: `Temperature range: 0 °C to +70 °C`, `Humidity range: 10 % to 80 % RH`.
- 페이지에 없는 것: 가격.

### Olfasense EK1000 — 1 m³ VOC 방출 시험 챔버 (독일)

- 출처: https://www.olfasense.com/odour-measurement-equipment/instruments/voc-test-chamber-ek1000/
- 보관 파일: `olfasense.com-VOC-test-chamber-EK1000.html`
- 내부: `Test space (width x depth x height) 745 x 1735 x 745 mm`, `Emission test space volume (usable) 1000 l (960 l)`.
- 외부: `External dimensions (max.) (width x depth x height) 1413 x 2800 x 2006 mm`.
- 기밀: `Leak tightness tested`.
- 페이지는 차량 실내 공기 질과 내장 부품의 VOC 방출을 다루는 글로 시작한다.
- 페이지에 없는 것: 문 형식, 가격.

### Sanwood SM-1000-CC-FB-HL7/CO2/WC — 배터리 방폭 온도 챔버 (중국, HTDS 배포 사양서)

- 출처: https://www.htds.fr/wp-content/uploads/2026/07/Eucar-7-Specs-of-SM-1000-CC-Battery-explosion-proof-temperature-chamber-Sanwood-20250404-HTDS.pdf
- 보관 파일: `Eucar-7-Specs-of-SM-1000-CC-Battery-explosion-proof-temperature-chamber-Sanwood-20250404-HTDS.pdf`
- 크기: `Internal chamber size 1000x1000x1000mm (W*H*D)`, `External chamber size (W1200*H2313*D2594mm)-Not include protruding parts`, `Volume 1000L`.
- 성능: `Temperature range -40℃~150℃`, `Load 100KG battery`.
- 구조: `Internal material Adopts 3.0mm thickness stainless steel (SUS304)`, 문 가장자리 `Double-layer high-tension silicone rubber seal`, 관찰창은 강화유리에 방폭 필름을 붙였다.
- 케이블 포트: `Each 3pcs cable hole on left and right side, total 6pcs (Φ150mm)`.
- 압력 방출구: `the maximum pressure which activates pressure relief port is 0.104MPa`.
- 화재 감지: `Temperature sensor for abnormal rapid temperature rising`, `Smoke detector`.
- 가스 감지: `Configure flammable gas concentration monitoring (CO, H2).`, `The H2 range is 0 to 10% with an accuracy of 1%; The CO range is 0 to 1000 PPM with an accuracy of 1 PPM.`
- 급배기: `The test chamber is equipped with 1 set of intake and exhaust device.` 유해 가스를 배기 덕트로 실험실 밖으로 내보낸다고 적는다.
- 질소: `Nitrogen connector DN25mm connector reserved at left side of chamber`.
- 위험 등급: `Refer to EUCAR level 7`.
- 페이지에 없는 것: 가격.

### Changsha Samy GS 시리즈 — 아크릴 글러브박스 (중국)

- 출처: https://kr.made-in-china.com/co_samycs/product_Acrylic-Transparent-Glove-Box-with-Chamber-Size-600-400-500mm_ysoueuiggg.html (판매처 페이지의 한국어 기계 번역판)
- 보관 파일: `made-in-china.com-Samy-Acrylic-Glove-Box.html`
- 사양 표 (열: 모델 / 챔버 크기(mm) / 챔버 두께 / 문 옆 크기(mm) / 플랜지 포트 / 전환 상자(mm) / 전환 상자 두께):

| 모델 | 챔버 크기(mm) | 챔버 두께 | 문 옆 크기(mm) | 플랜지 포트 | 전환 상자(mm) | 전환 상자 두께 |
|---|---|---|---|---|---|---|
| GS-002-B | W700 * D450 * H550 | 6mm | W300 * H350 | 165mm | 240 * 240 * 240 | 10mm |
| GS-003-B | W800 * D550 * H600 | 6mm | W300 * H400 | 165mm | 240 * 240 * 240 | 10mm |
| GS-004-B | W900 * D500 * H500 | 6mm | W300 * H300 | 165mm | 240 * 240 * 240 | 10mm |
| GS-005-B | W900 * D600 * H700 | 10mm | W400 * H400 | 200mm | 240 * 240 * 240 | 10mm |
| GS-006-B | W 1000 * D750 * H700 | 10mm | W400 * H400 | 200mm | 240 * 240 * 240 | 10mm |
| GS-008-B | W 1200 * D800 * H700 | 10mm | W400 * H400 | 200mm | 240 * 240 * 240 | 10mm |

- 가격: 이 페이지의 대표 제품(모델 번호 `GS-006-B glove box`)이 `US$2,055.00`, `1 상품 (MOQ)`. GS-008-B의 가격은 없다.
- 특징: 장갑 포트는 이중 O-링으로 고정하고, 입·출구 볼 밸브는 304 스테인리스라고 적는다.

### 고려기연 KK-011AD — 2인용 글로브박스 (국산)

- 출처: https://www.glovebox.co.kr/2021/kr/glovebox/glovebox_04.html
- 보관 파일: `glovebox.co.kr-KK-011AD-2인용.html`
- 사양: `Basic Composition Size 1,200(L) x 900(H) x 1200(D) mm`, `Stand Size 1,200(L) x 936(H) x 1200(D) mm`, `Material SUS304`, `Windows Poly-Carbonate PC or Safety Glass`, `Service Port KF(NW40): 2ea`, `Leak Test 0.05 vol%/hr According to ISO 10648-2`, `Antechamber Size 390 x 600 mm`, `Mini-Antechamber Size 150 x 290mm`.
- 용도: `글로브박스내 산소 및 수분 함유량 1 ppm 미만 유지`.
- 페이지에 없는 것: 내부 치수, 가격.

### 한양아크릴 사각형 아크릴 챔버(밀폐형 테스트 박스) (국산)

- 출처: https://hyac9580.com/bbs/board.php?bo_table=product&wr_id=6
- 보관 파일: `hyac9580.com-사각형-아크릴-챔버.html`
- 설명: `밀폐형 아크릴 챔버로, 내부 공기 순환을 위한 팬과 다양한 포트를 장착해 기체 주입, 배출 및 환경 제어가 가능합니다`.
- 제작 사양: `소재: 고투명 아크릴`, `구조: 밀폐형 박스 + 공기 순환 팬 + 연결 포트`, `가공: CNC 절삭, 실링 처리`, `활용처: 실험실 연구, 반도체/화학 테스트, 환경 제어 테스트`.
- 사이트 메뉴에 `주문제작문의`가 있다.
- 페이지에 없는 것: 치수, 판 두께, 문 형식, 가격.

### 열지 못한 것

- Terra Universal Extra-Large Plastic Glovebox Isolators (https://www.terrauniversal.com/extra-large-plastic-gloveboxes.html): HTTP 403으로 열리지 않아 수치를 기록하지 않았다.

## 조사자 판단 (Claude)

이 절은 위 기록을 바탕으로 조사자가 계산하고 판단한 것이다. 제조사가 말한 것이 아니다.

### 팩 수용과 용적

mm 값은 페이지의 mm 표기를 쓰고, 인치만 적힌 Binder는 25.4로 환산했다. 용적 비는 모의장치 내부 약 883 L(1380 × 970 × 660 mm)에 대한 비다.

| 제품 | 내부 W × D × H (mm) | 용적 | 비 | 눕힌 팩 |
|---|---|---|---|---|
| 원테크놀로지 WTH-1200 | 1000 × 1200 × 1000 | 1200 L | 1.36 | 들어감 (1130 변을 깊이 방향에 둠) |
| 원테크놀로지 WTH-1540 | 1100 × 1475 × 950 | 1541 L | 1.74 | 들어감 (1130 변을 깊이 방향에 둠) |
| 원테크놀로지 WTH-1700 | 1000 × 1000 × 1700 | 1700 L | 1.92 | 안 들어감 (세우면 들어감) |
| 원테크놀로지 WTH-6000 | 2400 × 1400 × 1800 | 6048 L | 6.85 | 들어감 |
| CSZ ZP-44 | 1120 × 970 × 1170 | 1250 L | 1.41 | 안 들어감, 폭이 10 mm 모자람 (세우면 들어감) |
| CSZ ZP-64 | 1220 × 1220 × 1220 | 1810 L | 2.05 | 들어감 |
| CSZ ZP-80 | 1220 × 1520 × 1220 | 2265 L | 2.56 | 들어감 |
| CSZ ZP-96 | 1220 × 1830 × 1220 | 2718 L | 3.08 | 들어감 |
| Memmert HPP1060eco | 1040 × 850 × 1200 (팬을 빼면 깊이 818) | 1060 L | 1.20 | 안 들어감 (세우면 들어감) |
| Binder KBF 1020 | 974 × 837 × 1252 | 약 1019 L | 1.15 | 안 들어감 (세우면 들어감) |
| Olfasense EK1000 | 745 × 1735 × 745 | 1000 L | 1.13 | 안 들어감, 폭 745 < 810 |
| Sanwood SM-1000 | 1000 × 1000 × 1000 | 1000 L | 1.13 | 안 들어감 |
| Samy GS-008-B | 1200 × 800 × 700 | 672 L | 0.76 | 안 들어감, 깊이가 10 mm 모자람 |
| 고려기연 KK-011AD | 내부 미기재 | — | — | 판단 못 함 |

- 원테크놀로지 표의 치수는 내부 치수로 봤다. 세 치수를 곱한 값이 모델 번호의 리터 값과 맞기 때문이다(1000 × 1200 × 1000 = 1200 L, 1100 × 1475 × 950 ≈ 1541 L, 1000 × 1000 × 1700 = 1700 L). 제조사에 확인한 것은 아니다.
- "세우면 들어감"은 팩의 1130 변을 수직으로 세운 경우다. 모의장치는 팩을 눕혀 놓으므로 이 경우는 수용으로 치지 않았다.
- Samy GS-008-B는 문 옆 크기가 400 × 400이고, 고려기연 KK-011AD는 전실이 390 × 600이다. 어느 쪽으로도 팩을 들일 수 없다고 봤다.

### 정리

- 눕힌 팩이 들어가면서 용적이 모의장치의 약 2배 이하인 기성품은 원테크놀로지 WTH-1200·WTH-1540과 CSZ ZP-64 셋이고, 모두 항온항습 챔버다.
- 1000 L 안팎의 흔한 1 m 정육면체급 제품(Sanwood SM-1000, Olfasense EK1000, Memmert, Binder, CSZ ZP-44)은 모두 팩의 1130 변을 바닥에 눕힐 수 없다.
- 항온항습 챔버는 스스로 온습도를 만들고, 강철 문에 관찰창이나 유리 내부 문을 단다. 모의장치는 바깥 장비(가습기·청소기·송풍기·DEC 분사·열풍기)가 포트로 밀폐 상자에 조건을 불어 넣는다(`wiki/topics/모의장치.md`). 항온항습 챔버가 기밀인지, 먼지와 DEC 분무를 견디는지는 어느 페이지에도 없어 제조사에 물어야 한다.
- 배터리 방폭 챔버(Sanwood)는 실제 배터리의 폭발·화재를 전제로 압력 방출구, CO·H2 감지, 급배기, 질소 주입구를 갖춘다. 가스 감지와 급배기는 모의장치가 하려는 일과 겹치지만, 더미 팩 시험에는 방폭 구조가 남는 사양이고 1 m 정육면체라 팩도 들어가지 않는다.
- 표준 아크릴 밀폐 박스는 가장 큰 Samy GS-008-B(1200 × 800 × 700)도 팩이 들어가지 않고 문이 작다. 한양아크릴처럼 밀폐형 아크릴 챔버를 주문제작하는 곳은 있으나 크기와 가격을 공개하지 않는다.
- 모의장치 크기(약 883 L, 폭 1380)는 기성 규격 사이에 있다. 흔한 1 m 정육면체는 팩보다 좁고, 팩이 들어가는 기성품은 가장 작은 것도 용적이 1.36배(WTH-1200)인 항온항습 챔버다.

## 보관 파일 sha256

| 파일 | sha256 |
|---|---|
| `tech-w.co.kr-WTH-대형항온항습챔버.html` | `923426d8e9d91191a11836d1b4db4c9ae94fb2a02b91650272165ca587437eed` |
| `cszindustrial.com-Z-Plus.html` | `c7e73878c03b92533ed386f9f88b4459bd00f88c546a4b1e5cbeaeede57e4d7b` |
| `memmert.com-HPP1060eco.html` | `203d79c4bbef0f2e926a80cd1eceeb50973f62ae79deee7e4330935fe56b3694` |
| `99705eb1_Data-Sheet-Model-KBF-1020-us.pdf` | `0416badf40a42455c5da222e4e13165eaa4529ca059f559bb0e804e6b85fc257` |
| `olfasense.com-VOC-test-chamber-EK1000.html` | `885bfbbbb9ec7726e9af7f72d968821aea58f28f40f366d865f47ca45ee741bb` |
| `Eucar-7-Specs-of-SM-1000-CC-Battery-explosion-proof-temperature-chamber-Sanwood-20250404-HTDS.pdf` | `4d55b44d616b188b3633473e7a82e973ba58b91ecd1dff0250ceab9d00d76f88` |
| `made-in-china.com-Samy-Acrylic-Glove-Box.html` | `201793bbd6619ebbaea422d5f0c4dfb9273ec40127a87bdb7abf1c0f0c3e35f2` |
| `glovebox.co.kr-KK-011AD-2인용.html` | `c6b6d3bec506c80afafb0e334921d4979e7b989f5f156575262d4037bbbd929b` |
| `hyac9580.com-사각형-아크릴-챔버.html` | `ac2d5ab37597647a68e51fe72653836898bd73dd11c781aa047242912f8154f0` |
