SunoopDogg/airo-tips/wiki/topics/모의장치.md

---
title: 모의장치
type: topic
tags: [시험장치, 검수, 센서]
created: 2026-09-04
updated: 2026-10-07
status: developing
sources: ["[[EnerX-0.5P Battery Container Operating Instruction and Maintenance Manual]]", "[[정량적 성과지표 항목표]]", "[[ESS 화재감지 알고리즘 (2023 추계학술발표논문집)]]", "[[Sensirion SEN5x Datasheet]]", "[[ESP32-S3-WROOM-1 & WROOM-1U Datasheet]]", "[[PCA9548A Datasheet]]", "[[P82B715 Datasheet]]"]
---

[[정량적 성과지표]] 지표 3을 공인인증기관 앞에서 시연하기 위해 만드는 시험용 ESS 운용환경 모사 장치. 실제 배터리를 열폭주시키지 않고 다섯 가지 환경을 인위적으로 만들어 알고리즘의 반응을 보는 것이 목적이다.

## 항목표가 요구하는 구성

시험용 ESS 운용환경 모의장치에 **온도·습도·먼지·오프가스 센서**를 설치하고 화재 위험 진단 알고리즘을 적용한 뒤, 다섯 조건을 차례로 만들어 평가한다 ([[정량적 성과지표 항목표]]).

| # | 조건 | 만드는 방법 |
|---|---|---|
| 1 | 다습환경 | 가습기 분무 |
| 2 | 먼지환경 | 청소기 먼지 배출구 |
| 3 | 정상상태 | 송풍기 바람 |
| 4 | 벤팅 모의 | DEC 전해질 시료 분사 |
| 5 | 고온환경 | 열풍기 바람 |

불꽃·연기는 이 센서 4종이 아니라 [[불꽃검출 알고리즘]]의 영상 AI가 추론·검출한다 (사용자 확인 2026-09-04). 즉 모의장치는 **센서부 + 카메라**로 구성되며, 논문이 쓴 공기흡입형 연기감지기·차동식 열감지기 자리를 영상 AI가 대신한다.

## 센서부 — SEN55 3대

환경 센서는 [[SEN55]]로 확정했고 3대를 이미 구매했다 (사용자 확인 2026-09-07). 항목표가 네 종류로 나열한 센서 4종이 **한 모듈로 접힌다** — SEN55가 먼지(PM1.0/2.5/4.0/10)·상대습도·온도를 직접 출력하고, 오프가스는 VOC Index로 검출한다 (사용자 확인 2026-09-07). SEN55에만 있는 NOx Index도 함께 나오지만 ([[Sensirion SEN5x Datasheet]]), 이 채널의 역할은 아직 정해지지 않았다.

3대는 챔버 내부에 직접 노출되도록 놓인다 (사용자 확인 2026-09-07). 즉 가습기 분무와 열풍기 바람이 센서에 그대로 닿는다. 아래 Contradictions 참조. 자리는 천장이고, 천장 중심에서 같은 거리에 120° 간격으로 대칭 배치한다 (사용자 확인 2026-10-06). 아래 "챔버 구성" 참조.

네 채널이 같은 모듈·같은 팬·같은 기류를 공유한다는 점이 단일화의 대가다. 팬 자동 청소가 도는 동안 네 채널이 함께 멈추고, 소자가 손상되면 네 채널이 함께 사라진다 ([[Sensirion SEN5x Datasheet]]).

## 센서 운용 — 정해진 것과 남은 것

정해진 것 (사용자 확인 2026-09-07):

- **컨트롤러는 [[ESP32-S3-WROOM-1]] N16R8 1대, 멀티플렉서는 [[PCA9548A]] 1개.** SEN55는 I2C 주소가 0x69로 고정이고 명령 목록에 주소 변경 명령이 없으므로 ([[Sensirion SEN5x Datasheet]]) 3대를 한 버스에 그대로 붙일 수 없다. 모듈의 I2C 1버스를 PCA9548A에 물리고, 그 채널 0~2에 SEN55를 한 대씩 잇는다. PCA9548A 주소는 A0=A1=A2=GND로 0x70 고정이고 RESET 핀은 VCC로 풀업만 한다.
- **센서만 챔버 내부, 나머지 전장은 챔버 상단 외부.** SEN55 3대는 챔버 내부에 두고, [[ESP32-S3-WROOM-1]]과 [[PCA9548A]]는 챔버 상단 외부에 둔다 (사용자 확인 2026-09-07). 둘을 싣는 전장 기판은 자체 PCB로 만든다 (사용자 확인 2026-10-06). 아래 Contradictions 참조.
- **배선 연장에는 [[P82B715]]를 쓴다.** PCA9548A~SEN55 배선이 챔버 벽을 넘는 문제의 해법으로 고려하던 버스 익스텐더를 채택했다 (사용자 확인 2026-10-06). 아래 Contradictions 참조.
- **전원은 USB 하나.** SEN55 3대의 5 V는 USB VBUS에서 분기하고, 측정값은 모듈의 USB Serial/JTAG(CDC-ACM)로 PC에 보낸다.
- **PC가 명령하고 모듈은 중계한다.** VOC 알고리즘 상태 저장·복원, 조건별 출발점 맞추기, 벤팅 임계값 판정은 PC 몫이고 모듈은 I2C 브리지다.
- **카메라는 별도 장비.** 이 모듈과 무관하게 [[불꽃검출 알고리즘]]의 영상이 PC로 들어간다.
- **조건마다 같은 출발점에서 시작한다.** VOC 알고리즘 상태를 저장해 두고 조건마다 복원해, 다섯 조건 모두 같은 기준선에서 출발시킨다. 기준선이 같아야 정해 둔 임계값을 조건에 상관없이 그대로 쓸 수 있기 때문이다. [[VOC Index]] 참조.
- **벤팅 판정은 임계값 방식이다.** 임계값 자체는 아직 정하지 않았고 나중에 설정한다.
- **RH/T 가속 모드는 중(2)이다.** 데이터시트의 두 권고(고정 설치 → 저, 온도 변화 큼 → 중·고)가 이 장치에서 갈리는 것을 중으로 정리했다.
- **조건당 유지시간은 45초.** VOC 채널의 90% 응답 <30초, 온도 채널의 63% 응답 <60초를 감안한 값이며 ([[Sensirion SEN5x Datasheet]]), 시험을 해 보고 바꿀 예정이다.
- **팬 자동 청소는 지장이 없다.** 기본 주기가 168시간이고 전원을 끄면 카운터가 0으로 돌아가므로 ([[Sensirion SEN5x Datasheet]]), 168시간을 넘기지 않는 시연에서는 청소가 끼어들지 않는다.
- **챔버는 밀폐 상태로 시험한다.** 아래 "챔버 개방/밀폐" 참조.

남은 것:

- **벤팅 임계값.** VOC Index 몇 이상을 벤팅으로 볼지. 이 값이 지표 3의 3·4·5단계 판정을 지탱한다.
- **온도 보정 재튜닝.** 모듈을 장치에 내장하면 열적 결합이 달라져 온도 보정(0x60B2)을 다시 잡아야 할 수 있다 ([[Sensirion SEN5x Datasheet]]). 설치 후 기준 온도계와 비교해 정한다.
- **조건 사이 환기 시간.** 45초 유지 뒤 이전 조건이 빠지는 데 걸리는 시간은 아직 없다.
- **NOx Index의 역할.**
- **다습·고온 조건의 실제 도달값.** 아래 Contradictions 참조.
- **PCA9548A~SEN55 배선의 길이와 차폐 케이블 사용 여부.** [[P82B715]]는 쓰기로 했지만 (사용자 확인 2026-10-06), 차폐 케이블을 함께 쓸지와 실제 배선 길이는 정해지지 않았다.

## 챔버 구성

챔버의 형상에 관한 결정이다 (사용자 확인 2026-10-06).

- **시료는 ESS 배터리 모듈 하나를 본뜬 더미다.** 실제 배터리 대신 외형만 본뜬 더미를 넣는다. 본뜨는 모듈은 32 kWh, 134.4 V, 22 A의 LiFePO4(LFP) 모듈이고, 외형은 1130 × 810 × 260 mm다. 모델명과 사양서는 없고, 외형 치수는 사용자가 기억으로 제시한 값을 그대로 쓰기로 했다. 챔버 안에는 높이가 260 mm가 되도록 눕혀 놓는다. 바닥에 바로 놓지 않고, 3030 프로파일을 세로 다리로 잘라 만든 레일 받침 위에 올려 바닥에서 100 mm 띄운다 (사용자 확인 2026-10-06). 레일은 깊이 방향으로 2줄이고 줄마다 다리 2개를 달며, 레일 중심은 팩 좌우 끝에서 100 mm 안쪽이다. 다리는 레일 양 끝에 달고, 레일 밑 바닥에 깊이 방향 3030 보강재 2개를 넣어 그 위에 세운다 (사용자 확인 2026-10-07).
- **외함은 알루미늄 프로파일 골조 바깥면에 패널을 덧댄다.** 프로파일은 3030 규격이고 패널은 3 mm 알루미늄 복합판이며, 스프링 너트와 볼트로 체결한다 (사용자 확인 2026-10-07). 내부 치수는 골조 안쪽 면 기준이다. 프로파일은 B형 슬롯 8 단면이고, 세로재를 통짜로 두고 수평재를 그 사이에 넣어 안쪽 코너 브래킷으로 잇는다. 패널은 바닥을 포함한 여섯 면에 모두 대고, M6 볼트를 200 mm 이하 간격으로 쓴다 (사용자 확인 2026-10-07).
- **도어는 앞면 여닫이다.** 경첩 3개를 앞에서 보아 오른쪽 변에 위·가운데·아래로 달고, 왼쪽 변 위·아래의 누름형 토글 클램프 2개로 도어 판 앞면을 밀폐재 쪽으로 눌러 잠근다. 손잡이는 따로 왼쪽 변 가운데에 단다. 도어 개구는 앞면 전체가 아니라 1230 × 460 mm로, 바닥에서 시작해 팩 좌우로 50 mm씩, 팩 윗면 위로 100 mm를 둔다 (사용자 확인 2026-10-07). 도어 판 전체를 8 mm 아크릴로 하므로 관찰창을 따로 두지 않는다. 개구 둘레에는 골조 부재를 따로 두지 않는다. 도어 판은 개구 둘레에 30 mm씩 겹쳐 1290 × 520 mm이고, 앞면 패널의 개구 둘레에 붙인 EPDM 스펀지 밀폐재(폭 15 × 두께 10 mm)를 누른다. 경첩은 50 × 50 mm 맞대기 경첩, 손잡이는 구멍 간격 128 mm 당김 손잡이다 (사용자 확인 2026-10-07).
- **주입과 배기는 양 옆면에서 마주 본다.** 다섯 조건의 자극을 넣는 공용 주입 포트는 앞에서 보아 오른쪽 옆면, 환기용 배기 포트는 왼쪽 옆면에 두고, 둘 다 팩 윗면과 천장의 가운데 높이에 낸다. 기류가 팩 옆면에 부딪히지 않고 팩 위와 천장 센서 아래를 지나게 하려는 것이다. 두 포트 모두 내경 50 mm 알루미늄 관을 옆면 깊이 가운데에 플랜지로 달고, 마개로 닫는다 (사용자 확인 2026-10-07).
- **받침 프레임 없이 캐스터 4개를 단다.** 바닥 프로파일에 직접 붙이고, 넷 다 브레이크가 달린 것을 쓴다. 바퀴 지름은 100 mm이고, 바닥 패널을 사이에 두고 네 모서리에 단다 (사용자 확인 2026-10-07).
- **SEN55의 천장 중심 거리는 천장 크기에 맞춰 정한다.** 120° 대칭 배치(위 "센서부" 참조)의 반지름이 챔버 내부 치수를 따라간다. 세 대 중 한 대는 앞쪽(도어 쪽)에, 나머지 두 대는 뒤쪽 좌·우에 놓인다. 반지름은 천장 짧은 변의 1/4이고, 천장에서 20 mm 띄운 브래킷에 단다 (사용자 확인 2026-10-07). 브래킷은 천장 패널 안쪽 면에 볼트로 달고 이 면에서 20 mm를 잰다. 모듈은 큰 면을 천장과 평행하게, 평평한 면을 위로 두고 커넥터가 천장 중심을 향하게 단다. 모듈의 긴 변 두 가장자리를 감싸는 클립으로 고정하고, [[P82B715]] 센서측 기판(30 × 20 mm)도 브래킷에 함께 단다 (사용자 확인 2026-10-07).
- **SEN55 케이블은 천장으로 나간다.** 전장함 바로 아래에서 천장을 관통한다. 전장함은 천장 중심에 두고, 케이블마다 M20 케이블 글랜드를 하나씩 쓴다. 전장 기판은 80 × 60 mm 자체 PCB이고 USB-C로 PC와 잇는다. 전장함은 3D 프린트 상자다 (사용자 확인 2026-10-07).

**팩 둘레 여유와 내부 치수.** 팩 둘레에 앞 80, 뒤 80, 왼쪽(배기) 100, 오른쪽(주입) 150, 위 300 mm를 둔다. 주입 쪽을 넓힌 것은 분무와 열풍이 팩에 닿기 전에 퍼질 거리를 두려는 것이고, 전체를 작게 잡은 것은 밀폐 챔버의 부피가 클수록 조건 조성과 환기가 느려지기 때문이다. 받침 100 mm를 더하면 내부는 폭 1380 × 깊이 970 × 높이 660 mm이고, 포트 중심은 바닥에서 510 mm다.

## 논문의 시험장치와 비교

[[ESS 화재감지 알고리즘 (2023 추계학술발표논문집)]]은 화재발생장치부(배터리 가열장치 + 비배터리 화재용 케이블)와 감지장치부(오프가스 검출센서, 공기흡입형 연기감지기, 차동식 열감지기)를 PLC로 묶고, 화재발생장치부 상단에 감지장치부를 설치했다.

상용 컨테이너 [[EnerX-0.5P]]는 배터리실에 H2·CO·열·연기 검출기를 두고 조합으로 판정하며 ([[EnerX-0.5P Battery Container Operating Instruction and Maintenance Manual]]), 이 장치가 모사하려는 실제 운용환경의 참고가 된다.

두 장치의 성격이 다르다. 논문 장치는 **실제로 배터리를 가열해 벤팅과 열폭주를 일으키는** 장치이고, 이 프로젝트의 모의장치는 **환경만 모사하는** 장치다. 논문의 데이터는 이 위키의 참조 실측값으로는 쓸 수 있어도, 검수 시연 방식으로는 그대로 옮겨지지 않는다.

## 챔버 개방/밀폐 — 압력·LEL 채널이 여기 걸려 있다

논문 시험에서 **압력과 LEL은 열폭주 이후까지 값 변화가 없었고**, 논문은 그 이유를 시험용 챔버가 **개방형 구조**이기 때문으로 추측한다 ([[ESS 화재감지 알고리즘 (2023 추계학술발표논문집)]]).

이 프로젝트의 시험 챔버는 도어를 통해 열고 닫을 수 있고 (사용자 확인 2026-09-04), **시험은 밀폐 상태에서 진행한다** (사용자 확인 2026-09-07). 밀폐 상태에서는 압력·LEL이 논문과 달리 유의미한 신호가 될 가능성이 있다. 가습기·청소기·송풍기·열풍기로 만드는 다섯 조건이 밀폐 공간에 쌓이므로 농도와 온습도가 개방형보다 빨리 오르고, 조건 사이에 이전 조건을 빼내는 환기 절차가 따로 필요하다.

## Contradictions

**시험 조건과 센서 동작 조건이 같은 공간에서 만난다.** [[정량적 성과지표 항목표]]는 가습기 분무로 다습환경을, 열풍기 바람으로 고온환경을 조성하라고 한다. [[Sensirion SEN5x Datasheet]]는 SEN55의 동작 조건을 권장 10–40 °C / 20–80 %RH, 절대 최대·최소 −10–50 °C / 0–90 %RH(비결로)로 정하고, 가스 사양은 권장 조건에서 동작·보관했을 때만 보증되며 **어떤 경우에도 결로 조건에 노출되어서는 안 된다**고 못 박는다. 권장 범위를 벗어나면 정확도가 일시적으로 떨어지고, 절대 범위를 벗어나면 가스 감도가 영구히 드리프트하거나 소자가 영구 손상된다.

센서 3대는 챔버 내부에 직접 노출되고, 시험은 밀폐 상태로 진행한다 (사용자 확인 2026-09-07). 밀폐 공간에서는 분무와 열풍이 빠져나가지 않아 습도·온도가 더 빨리 오른다.

**두 조건이 실제로 어느 온도·습도에 도달하는지는 두 원문 어디에도 없다.** 따라서 지금 판정할 수 있는 것은 충돌이 일어났다는 사실이 아니라, 다습·고온 조건의 도달값을 재기 전에는 검수 시험이 센서를 권장 범위 밖으로 — 최악의 경우 결로나 절대 범위 밖으로 — 몰지 알 수 없다는 것이다. 가습기 분무가 닿는 표면의 결로는 특히 데이터시트가 예외 없이 금지한 조건이다.

같은 이유로, 시험 중 SEN55가 권장 범위를 벗어났다면 **그때 나온 가스 채널 값은 데이터시트가 보증하지 않는 값**이다. 지표 3 시연 데이터의 유효성이 여기 걸린다.

이 제약은 시험 설계에 감안하기로 했다 (사용자 확인 2026-09-07). 다습·고온 조건을 조성한 뒤 챔버 안 온습도를 실측하는 것이 첫 순서이고, 권장 범위를 넘으면 가습기·열풍기 세기나 센서 위치를 조정한다.

**전장이 챔버 밖으로 나가면서 SEN55의 배선 길이 권고와 부딪힌다.** SEN55만 챔버 내부에 두고 [[ESP32-S3-WROOM-1]]과 [[PCA9548A]]는 챔버 상단 외부에 두기로 했다 (사용자 확인 2026-09-07). [[Sensirion SEN5x Datasheet]]는 전자기 간섭과 크로스토크를 피하려면 I2C 배선을 10 cm 미만으로 하거나 차폐 케이블을 쓰라고 하는데, PCA9548A~SEN55 배선이 챔버 벽을 가로질러야 하므로 10 cm를 넘기기 쉽다. 이를 풀기 위해 두 가지를 고려했다 (사용자 확인 2026-09-07). 하나는 [[P82B715]] 버스 익스텐더로, 케이블 양 끝에 한 개씩 쌍으로 두어 싱크 전류를 10배 증폭하고 버스 정전용량 한계를 400 pF에서 3000 pF로 늘리는 IC다 ([[P82B715 Datasheet]]). PCA9548A 채널마다 한 쌍(총 6개), VCC 5 V를 USB VBUS에서 분기하는 구성을 상정한다 (사용자 확인 2026-09-07). 다른 하나는 차폐 케이블이다. 이 중 P82B715를 쓰기로 했고 (사용자 확인 2026-10-06), 차폐 케이블을 함께 쓸지와 실제 배선 길이는 아직 정해지지 않았다.

## 관련 페이지

[[배터리 화재감지 5단계]]가 이 장치에서 평가되고, 벤팅 모의는 [[벤팅 가스]], 재현 대상 현상은 [[열폭주]]에서 다룬다. 센서 자체는 [[SEN55]], 오프가스 검출 채널의 성격은 [[VOC Index]], 센서를 읽는 컨트롤러는 [[ESP32-S3-WROOM-1]], I2C 주소 충돌을 푸는 멀티플렉서는 [[PCA9548A]], 배선을 늘리는 버스 익스텐더는 [[P82B715]]에서 다룬다.
