SunoopDogg/airo-tips/wiki/topics/SEN55.md

---
title: SEN55
type: topic
tags: [sensor-spec, 환경센서, 모의장치]
created: 2026-09-07
updated: 2026-10-07
status: developing
sources: ["[[Sensirion SEN5x Datasheet]]", "[[ESP32-S3-WROOM-1 & WROOM-1U Datasheet]]", "[[PCA9548A Datasheet]]", "[[P82B715 Datasheet]]"]
---

센시리온(Sensirion) SEN5x 제품군 중 출력 신호가 가장 많은 모델. 먼지·상대습도·온도·VOC Index·NOx Index를 한 패키지에서 측정하는 환경센서 노드다. [[모의장치]]의 환경 센서로 확정되었고 3대를 이미 구매했다 (사용자 확인 2026-09-07).

## 항목표의 센서 4종이 한 모듈로 접힌다

[[정량적 성과지표 항목표]]는 모의장치에 **온도·습도·먼지·오프가스** 센서를 설치하라고 요구한다. SEN55 하나가 온도·습도·먼지를 직접 출력하고, 오프가스는 VOC Index로 검출한다 (사용자 확인 2026-09-07). 즉 항목표가 네 종류로 나열한 센서부가 단일 모듈 + 단일 드라이버로 구성된다.

주의할 것은 네 채널이 **같은 소자·같은 기류·같은 팬**을 공유한다는 점이다. 팬 자동 청소가 도는 동안에는 네 채널이 전부 함께 멈추고, 소자가 손상되면 네 채널이 함께 사라진다 ([[Sensirion SEN5x Datasheet]]).

## 출력

정품명 SEN55-SDN-T, 품번 3.000.593. Read Measured Values(0x03C4) 한 번에 여덟 개 값이 나온다 — PM1.0 · PM2.5 · PM4.0 · PM10 질량농도, 보정 상대습도, 보정 주위온도, VOC Index, NOx Index ([[Sensirion SEN5x Datasheet]]). 새 값은 매초 갱신된다.

NOx Index는 SEN5x 제품군 중 SEN55에만 있는 신호다 (같은 문헌). 이 프로젝트에서 NOx Index에 어떤 역할을 줄지는 아직 정해지지 않았다.

## 외형

SEN5x 제품군은 외형이 모두 같다. 외형은 길이 52.3 ± 0.4 mm, 폭 43.3 +0.2/−0.6 mm이고, 두께는 팬이 있는 쪽이 최대 22.3 ± 0.4 mm, 본체가 13.2 ± 0.4 mm다. 무게는 36.4 g ± 10%다. 커넥터는 두께 쪽 측면에 있고, 장착은 별도 문서인 "SEN5x Mechanical Assembly and Design-in Guidelines"를 따르라고 한다 ([[Sensirion SEN5x Datasheet]]). [[모의장치]]에서는 천장에서 20 mm 띄운 브래킷에 단다 (사용자 확인 2026-10-07).

## 이 프로젝트에서 걸리는 지점

**VOC Index는 절대 농도가 아니다.** 1–500 범위의 상대 지표이고 알고리즘이 최근 이력으로 기준선을 스스로 학습한다 ([[Sensirion SEN5x Datasheet]]). [[벤팅 가스]] 검출 규칙이 여기에 걸린다. 자세한 것은 [[VOC Index]].

**측정 시작마다 VOC 알고리즘 상태가 리셋된다.** 잠깐 멈췄다 다시 시작해도 초기값으로 돌아가고, 출력이 다시 안정되기까지 오래 걸린다. Read/Write VOC Algorithm State(0x6181)로 상태를 백업·복원해야 초기 학습 단계를 건너뛴다 (같은 문헌). 켠 뒤 이벤트를 신뢰성 있게 검출하기까지 <60초, 가스 사양표를 만족하기까지 VOC는 <1시간, NOx는 <6시간이 걸린다 (같은 문헌).

**팬 자동 청소 중에는 측정값이 갱신되지 않는다.** 기본 주기 168시간, 1회 10초다. 간격 설정은 휘발성이라 기기 리셋 시 기본값으로 돌아가고, 전원을 끄면 카운터가 0으로 돌아간다 (같은 문헌). 시연이 168시간을 넘기지 않으므로 지장이 없다 (사용자 확인 2026-09-07).

**온도 보정을 다시 맞춰야 한다.** 출력 온도·습도는 모듈 자체발열을 보정한 값인데, 다른 기기에 내장하면 열적 결합이 달라져 보정을 다시 잡아야 할 수 있다 (같은 문헌). RH/T 가속 모드는 중(2)으로 정했다 (사용자 확인 2026-09-07).

**동작 범위가 시험 조건과 만난다.** 권장 10–40 °C / 20–80 %RH, 절대 −10–50 °C / 0–90 %RH, 결로 노출 금지다 (같은 문헌). 3대는 챔버 내부에 직접 노출되도록 놓인다 (사용자 확인 2026-09-07). 자리는 챔버 천장이고, 천장 중심에서 같은 거리에 120° 간격으로 둔다 (사용자 확인 2026-10-06). [[모의장치]]의 Contradictions 참조.

**I2C 주소가 0x69로 고정되어 있다.** 명령 목록(Table 12)에 주소를 바꾸는 명령이 없다 ([[Sensirion SEN5x Datasheet]]). 3대는 [[ESP32-S3-WROOM-1]] N16R8 1대의 I2C 1버스에서 뻗은 [[PCA9548A]] 멀티플렉서 채널 0~2에 한 대씩 연결한다 (사용자 확인 2026-09-07). SDA/SCL은 LVTTL 3.3 V 호환(VIH 최소 2.31 V)이고 ([[Sensirion SEN5x Datasheet]]) 모듈 IO가 3.3 V 도메인이므로 레벨 시프터는 없다. 5 V 전원은 USB VBUS에서 분기한다 (사용자 확인 2026-09-07). 배선 10 cm 미만 또는 차폐 케이블 권고 ([[Sensirion SEN5x Datasheet]])는 센서만 챔버 안에 두는 배치와 부딪히며, [[P82B715]] 버스 익스텐더와 차폐 케이블을 고려했고 (사용자 확인 2026-09-07), P82B715를 쓰기로 했다 (사용자 확인 2026-10-06).

**소자간 편차가 있다.** VOC Index는 <±15 points 또는 <±15 % m.v.(큰 쪽), NOx Index는 <±50 points 또는 <±50 %(큰 쪽)다 (같은 문헌). 3대의 값을 그대로 비교하려면 이 폭을 감안해야 한다.

## 상정된 용도

데이터시트의 부제는 "Environmental Sensor Node for HVAC and Air Quality Applications"이고, 가스 사양표의 모든 농도는 시험가스인 에탄올 기준으로 명시되어 있으며, 기준 조건인 zero air는 "실내 공기질 응용에서 청정 공기로 간주되는" 것으로 정의된다 ([[Sensirion SEN5x Datasheet]]). 즉 제조사가 상정한 용도는 실내공기질·HVAC이지 배터리 오프가스 검출이 아니다. 데이터시트에는 배터리·전해질· [[열폭주]] 관련 서술이 없다.
