SunoopDogg/airo-tips/wiki/sources/Sensirion SEN5x Datasheet.md

---
title: Sensirion SEN5x Datasheet
type: source
tags: [sensor-spec, 데이터시트, 환경센서]
created: 2026-09-07
updated: 2026-10-07
status: stable
sources: []
source_path: raw/sensor-spec/Sensirion_SEN5x_Datasheet_V2-D1_2203.pdf
ingested: 2026-09-07
---

센시리온(Sensirion)의 환경센서 노드 SEN5x 제품군 데이터시트. 판본은 Version 2 – D1, 2022년 3월, 30쪽이다. 부제는 "Environmental Sensor Node for HVAC and Air Quality Applications"로, 상정된 용도는 HVAC와 실내공기질이다.

## 제품군

SEN5x는 치수·하드웨어·펌웨어 인터페이스가 동일하고 출력 신호 수만 다른 세 모델로 구성된다.

| 모델 | 출력 신호 | 품번 |
|---|---|---|
| SEN50-SDN-T | Particulate Matter | 3.000.667 |
| SEN54-SDN-T | PM, Relative Humidity, Temperature, VOC Index | 3.000.535 |
| SEN55-SDN-T | PM, Relative Humidity, Temperature, VOC Index, NOx Index | 3.000.593 |

RH·T와 VOC 센서는 SEN54와 [[SEN55]]에만 들어 있고, NOx 신호는 SEN55에만 있다. 사양과 명령은 해당 출력이 그 제품에 포함된 경우에만 적용된다.

## 판독 — 8개 데이터 신호

Read Measured Values(0x03C4)가 한 번에 돌려주는 값은 여덟 개다.

| 값 | 자료형 | 스케일 |
|---|---|---|
| PM1.0 / PM2.5 / PM4.0 / PM10 질량농도 [µg/m³] | big-endian uint16 | ÷10 |
| 보정 상대습도 [%RH] | big-endian int16 | ÷100 |
| 보정 주위온도 [°C] | big-endian int16 | ÷200 |
| VOC Index | big-endian int16 | ÷10 |
| NOx Index | big-endian int16 | ÷10 |

2바이트마다 CRC-8(다항식 0x31, 초기값 0xFF) 체크섬이 붙는다. 알 수 없는 값은 0xFFFF로 돌아온다. Measurement 모드에서 새 측정값은 **매초** 갱신되고, 샘플링 간격은 1 ± 0.03초다.

## 가스 채널 — VOC Index와 NOx Index

출력은 **1–500 범위의 Index 포인트**이며, 데이터시트의 가스 사양표(Table 5)는 모든 농도를 시험가스인 에탄올 기준으로 명시한다. 이 지표의 성격은 [[VOC Index]]에서 다룬다.

| 항목 | VOC Index | NOx Index |
|---|---|---|
| 소자간 편차 | <±15 points 또는 <±15 % m.v. (큰 쪽) | <±50 points 또는 <±50 % (큰 쪽) |
| 반복도 | <±5 points 또는 <±5 % | <±10 points 또는 <±10 % |
| 켠 뒤 이벤트를 신뢰성 있게 검출하기까지 | <60초 | <60초 |
| 켠 뒤 위 사양을 만족하기까지 | <1시간 | <6시간 |

응답시간은 두 채널 공통으로, **에탄올 농도를 5 ppm에서 10 ppm으로 바꿀 때 1초 샘플링 기준** 63% 도달 <10초, 90% 도달 <30초다.

## 먼지 채널

질량농도 규정 범위는 0–1'000 µg/m³이고, 입자 크기 구간은 PM1.0이 0.3–1.0 µm, PM2.5가 0.3–2.5 µm, PM4가 0.3–4.0 µm, PM10이 0.3–10.0 µm다. PM4와 PM10 출력값은 측정된 전체 입자의 분포 프로파일로부터 **계산된** 값이다. PM2.5 질량농도는 TSI DustTrak DRX 8533 Ambient Mode에 맞춰 교정되어 있고, PM2.5 검증 에어로졸은 3% KCl 분무액이다. 레이저는 파장 660 nm, DIN EN 60825-1 Class 1이다.

기동 후 안정된 측정을 얻기까지의 전형적 시간은 입자 수농도에 따라 다르다 — 200–3000 #/cm³에서 8초, 100–200 #/cm³에서 16초, 50–100 #/cm³에서 30초.

## 온도·습도 채널

출력은 자체발열이 보정된 온도와 상대습도다.

| 항목 | 값 |
|---|---|
| 온도 정확도 (15–30 °C, 50 %RH) | 전형 0.45 °C / 최대 ±0.7 °C |
| 습도 정확도 (25 °C, 30–70 %RH) | 전형 4.5 %RH / 최대 ±6 %RH |
| 온도 응답시간 (63%, 15→25 °C 계단) | <60초 |
| 습도 응답시간 (63%, 75→25 %RH 계단) | <20초 |

모듈을 다른 기기에 내장하면 열적 결합과 다른 부품의 자체발열이 달라지므로 **온도 보정을 다시 맞춰야 할 수 있다**. Read/Write Temperature Compensation Parameters(0x60B2)가 오프셋·기울기·시정수를 받고, 보정식은 `T_Ambient_Compensated = T_Ambient + (slope*T_Ambient) + offset`이다.

주위온도 변화에 대한 응답을 2~3배 가속하는 STAR(Sensirion Temperature Acceleration Routine) 엔진이 들어 있고, RH/T 가속 거동은 Read/Write RH/T Acceleration Mode(0x60F7)로 세 모드 중에서 고른다 — 0 저가속, 1 고가속, 2 중가속. 큰 온도 변화를 겪는 공기질 모니터에는 중·고가속이, 온도 변화가 크지 않은 고정 설치 기기에는 저가속이 권장된다.

## 동작·보관 조건 (SEN54/SEN55)

| 조건 | 항목 | 권장 | 절대 최대/최소 |
|---|---|---|---|
| 동작 | 온도 | 10 ~ 40 °C | −10 ~ 50 °C |
| 동작 | 상대습도 | 20 ~ 80 %RH | 0 ~ 90 %RH (비결로) |
| 보관 | 온도 | 10 ~ 30 °C | −40 ~ 70 °C |
| 보관 | 상대습도 | 20 ~ 60 %RH | 0 ~ 80 %RH (비결로) |

**가스 사양은 권장 조건에서 동작·보관했을 때만 보증된다.** 권장 범위를 벗어나면 성능이 일시적으로 떨어지고(가역적 RH 드리프트, RH·T·가스·PM 정확도 저하), 절대 최대/최소를 벗어나면 성능이 영구히 떨어지거나(가스 감도 드리프트) 소자가 영구 손상될 수 있다. 그리고 **어떤 경우에도 결로 조건에 노출되어서는 안 된다.**

## 팬 자동 청소

Measurement 모드에서 주기적으로 팬을 10초간 최대 속도로 돌려 팬 내부에 쌓인 먼지를 불어낸다.

- **청소가 도는 동안 측정값이 갱신되지 않는다.**
- 기본 주기는 604'800초(168시간 = 1주), 오차 3%. Set Automatic Cleaning Interval(0x8004)로 바꾸고, 0으로 두면 자동 청소가 꺼진다.
- **이 설정은 휘발성이라 기기 리셋 시 기본값으로 돌아간다.** 전원을 끄면 시간 카운터도 0으로 리셋되므로, 주기적으로 껐다 켜는 운용에서는 적어도 주 1회 청소를 수동으로 돌려 줘야 한다.
- Start Fan Cleaning(0x5607)으로 수동 실행할 수 있으며, Measurement 모드에서만 먹는다.

## 동작 모드

- **Idle** — 전원 인가·리셋 후의 상태. 팬과 레이저가 꺼져 있고 명령만 받는다.
- **Measurement** — 전체 동작. 매초 새 값.
- **RHT/Gas-Only Measurement** — 팬과 레이저를 꺼 소비전력을 낮춘 모드. 습도·온도·VOC·NOx만 나오고 **PM 출력은 0xFFFF**다. Measurement 모드와의 직접 전환은 펌웨어 v2 이상에서만 된다.

## 인터페이스

I2C 주소는 **0x69**, 최대 속도는 standard mode 100 kbit/s, 클럭 스트레칭은 쓰지 않는다. SDA/SCL 핀은 "LVTTL 3.3V compatible"로 표기되어 있고, 전기 사양표(Table 8)의 입력 레벨은 VIH 2.31~5.5 V, VIL 0~0.99 V, 출력 VOL은 싱크 6 mA 미만에서 최대 0.4 V다. I/O 핀 절대 최대 정격은 −0.3~5.5 V, 핀당 전류 ±16 mA다. 인터페이스 선택 핀 SEL을 **전원 인가 이전 또는 동시에 GND로 당겨야** I2C로 잡힌다. SCL·SDA는 오픈드레인이라 외부 풀업(예: 10 kΩ)이 필요하고, 전자기 간섭과 크로스토크를 피하려면 배선을 10 cm 미만으로 짧게 하거나 차폐 케이블을 쓰라고 되어 있다. 명령 목록(Table 12)에 **I2C 주소를 바꾸는 명령은 없다.**

커넥터는 센서 쪽이 ACES 51451-0060N-001, 케이블 쪽이 ACES 51452-006H0H0-001(JST GHR-06V-S 호환)이며 6핀 중 1 VDD, 2 GND, 3 SDA, 4 SCL, 5 SEL, 6 NC다. GND 핀과 금속 차폐 사이에 내부 전기적 연결이 있으므로 차폐를 전기적으로 띄워 두어야 한다. 이 연결을 통해 흐르는 전류는 제품을 손상시키고 과열로 인한 안전 위험이 된다.

## 상태 레지스터

32비트 Device Status Register(0xD206)가 내부 상태를 담는다. 의미 있는 비트는 여섯이다 — bit 21 SPEED(팬 속도 범위 이탈), bit 19 FAN(팬 청소 진행 중), bit 7 GAS SENSOR(VOC·NOx 가스센서 오류), bit 6 RHT(RHT 내부통신 오류), bit 5 LASER(레이저 전류 이상), bit 4 FAN(팬 고장, 0 RPM). LASER와 FAN 비트는 조건이 정상으로 돌아와도 **자동으로 지워지지 않는다**. 나머지 비트는 예약이므로 0이든 1이든 무시해야 한다.

## 튜닝과 알고리즘 상태

VOC와 NOx 알고리즘은 각각 6개 파라미터로 튜닝하며 **Idle 모드에서만** 먹는다. 파라미터가 하나라도 지정 범위를 벗어나면 명령 전체가 무효가 된다.

| 파라미터 | VOC 기본값 | NOx 기본값 |
|---|---|---|
| Index Offset (평상 조건을 나타내는 인덱스, 1..250) | 100 | 1 |
| Learning Time Offset Hours (1..1000) | 12시간 | 12시간 |
| Learning Time Gain Hours (1..1000) | 12시간 | 12시간 고정 (NOx에는 영향 없음) |
| Gating Max Duration Minutes (0..3000, 0이면 비활성) | 180분 | 720분 |
| Std Initial (10..5000) | 50 | 50 고정 (NOx에는 영향 없음) |
| Gain Factor (1..1000) | 230 | 230 |

Read/Write VOC Algorithm State(0x6181)는 VOC 알고리즘 상태를 백업·복원해 짧은 중단 뒤 초기 학습 단계를 건너뛰게 해 준다. **기본 동작에서는 측정을 시작할 때마다 알고리즘 상태가 초기값으로 리셋되고**, 잠깐만 멈췄던 경우에도 그렇다. 그래서 VOC Index 출력이 다시 안정되기까지 오래 걸리며, 이를 피하려면 측정 모드에 들어가기 전에 기억해 둔 상태를 복원해야 한다.

Warm Start Parameter(0x60C6)는 온도 보정 알고리즘이 기본적으로 냉시동을 가정하는 것을 보완한다. 이미 예열된 기기에서 측정을 시작할 때 초기 온도 정확도를 올려 주며, 다음 Start Measurement 때 적용되므로 그 전에 써 두어야 한다. **모든 명령은 휘발성이다.**

## 전기·기구 사양

공급전압 4.5 / 5.0 / 5.5 V(최소·전형·최대), 전원 인가 후 I2C 통신 시작까지 최대 50 ms. 평균 소비전류는 SEN55 기준 Idle 최초 10초 3.8 mA, 이후 2.6 mA, RHT/Gas-only 6.8 mA, Measurement 최초 60초 70 mA, 이후 63 mA다. 피크 전류는 측정 모드에서 100 mA(펄스폭 16 µs). 무게는 36.4 g ± 10%, 수명은 24시간 연속 동작 기준 MTTF 10년 초과, 소음은 0.2 m에서 24 dB(A)이며 연간 +0.5 dB(A)씩 드리프트한다.

ESD 내성은 IEC 61000-4-2 기준 접촉 ±4 kV, 기중 ±8 kV다.

## 외형 치수

7.1절 Figure 7이 제품군 공통 외형도를 mm 단위로 준다. 공차가 붙은 주요 치수는 길이 52.3 ± 0.4, 폭 43.3 +0.2/−0.6, 두께는 팬이 있는 쪽 최대 22.3 ± 0.4, 본체 13.2 ± 0.4다. 괄호로 표시된 참고 치수로는 팬 개구 지름 19, 팬 쪽 블록 폭 27.24, 커넥터 쪽 높이 16.7·13.2 등이 있다. 커넥터는 두께 쪽 측면에 있다.

외형도 본문은 그림이라 텍스트로 추출되지 않는다. 장착에 관해서는 별도 문서인 "SEN5x Mechanical Assembly and Design-in Guidelines"를 따르라고 한다 (2.5절).
