SunoopDogg/airo-tips/wiki/topics/P82B715.md

---
title: P82B715
type: topic
tags: [sensor-spec, 버스익스텐더, 모의장치]
created: 2026-09-07
updated: 2026-10-06
status: developing
sources: ["[[P82B715 Datasheet]]", "[[Sensirion SEN5x Datasheet]]"]
---

Texas Instruments의 I2C 버스 익스텐더 IC. 모의장치에서 챔버 밖 멀티플렉서와 챔버 안 환경센서 사이의 I2C 배선을 늘리는 데 쓴다.

## 이 프로젝트에서 쓰는 이유

[[Sensirion SEN5x Datasheet]]는 전자기 간섭과 크로스토크를 피하려면 [[SEN55]]의 I2C 배선을 10 cm 미만으로 하거나 차폐 케이블을 쓰라고 한다. 그런데 [[모의장치]]는 SEN55 3대만 챔버 내부에 두고 [[PCA9548A]]와 [[ESP32-S3-WROOM-1]]은 챔버 상단 외부에 두기로 했으므로 (사용자 확인 2026-09-07), PCA9548A~SEN55 배선이 챔버 벽을 가로질러 10 cm를 넘기기 쉽다. 이 문제를 풀기 위해 P82B715 삽입과 차폐 케이블 사용을 고려했고 (사용자 확인 2026-09-07), **P82B715를 쓰기로 했다** (사용자 확인 2026-10-06). 차폐 케이블을 함께 쓸지는 정해지지 않았다.

P82B715가 하는 일은 Sx/Sy(I2C 쪽)에서 Lx/Ly(버퍼드 버스 쪽)로 싱크 전류를 10배 증폭해, 버스 정전용량 한계를 400 pF에서 3000 pF로 늘리고 "10배 낮은 임피던스의 배선"으로 노이즈 내성을 높이는 것이다 ([[P82B715 Datasheet]]). 전압 이득은 1이라 3.3 V 로직 레벨이 그대로 지나가고, 오픈드레인·멀티마스터 특성도 보존된다 (같은 문헌).

## 상정한 구성

**PCA9548A 채널마다 한 쌍.** 데이터시트의 기본 사용법이 긴 케이블 양 끝에 한 개씩 두고 Lx–Lx, Ly–Ly로 잇는 것이므로 ([[P82B715 Datasheet]]), PCA9548A 채널 0~2 출력에 각 1개, 챔버 안 SEN55 3대 옆에 각 1개로 총 6개를 상정한다 (사용자 확인 2026-09-07). 이 구성은 "전장은 챔버 외부" 결정을 그대로 두되, 센서 쪽 P82B715 3개는 챔버 내부에 들어간다.

**VCC는 5 V, USB VBUS 분기.** 데이터시트가 온도 전 범위 성능을 4.5 V 이상에서만 보증하고 3.3 V에서는 디레이팅을 적용하므로 ([[P82B715 Datasheet]]), SEN55와 같은 5 V 라인을 상정한다 (사용자 확인 2026-09-07). 논리 레벨은 VCC와 무관하므로 ESP32-S3·SEN55의 3.3 V 신호는 그대로 통과한다 (같은 문헌).

## 이 구성에서 걸리는 지점

- **풀업을 다시 계산해야 한다.** 구간마다 따로 풀업을 두고 `R = 1 µs / C`로 맞추는 것이 데이터시트의 절차다 ([[P82B715 Datasheet]]). 케이블 50~100 pF/m 가정을 쓰면 챔버 벽을 넘는 짧은 케이블은 3000 pF 설계 예(330 Ω)보다 훨씬 작은 정전용량이라, Lx 쪽 풀업은 예시값이 아니라 실제 길이로 정해야 한다. Sx 쪽에는 SEN55 데이터시트의 예시 10 kΩ 풀업이 이미 있다 ([[Sensirion SEN5x Datasheet]]).
- **USB 전류 예산이 늘어난다.** 대기 전류가 개당 14 mA(5 V)이므로 ([[P82B715 Datasheet]]) 6개면 최대 약 84 mA가 SEN55 3대(평균 약 190 mA)와 모듈 소비에 더해진다. 다만 데이터시트의 기능 모드 절은 idle 버스에서 "거의 또는 전혀 전류가 흐르지 않는다"고도 하므로 실제 소비는 재 봐야 한다.
- **챔버 안 3개는 시험 조건에 노출된다.** 동작온도는 −40~85 °C이고 습도 사양은 없다 ([[P82B715 Datasheet]]). 다습 조건의 결로가 SEN55와 함께 이 IC에도 닿는다.
- **속도에는 여유가 있다.** 버퍼 지연 최대 250 ns는 ([[P82B715 Datasheet]]) SEN55의 100 kbit/s 표준 모드 ([[Sensirion SEN5x Datasheet]]) 비트 주기 10 µs에 비해 작다.
- **차폐 케이블과의 관계.** P82B715는 정전용량과 노이즈 내성을 다루고, 차폐 케이블은 외부 간섭을 다룬다. P82B715는 쓰기로 했지만 (사용자 확인 2026-10-06) 차폐 케이블을 함께 쓸지는 정해지지 않았다. 차폐를 쓸 경우 SEN55 커넥터의 금속 차폐는 GND 핀과 내부적으로 연결되어 있으므로 전기적으로 띄워 두어야 한다 ([[Sensirion SEN5x Datasheet]]).
