SunoopDogg/airo-tips/wiki/topics/PCA9548A.md

---
title: PCA9548A
type: topic
tags: [sensor-spec, 멀티플렉서, 모의장치]
created: 2026-09-07
updated: 2026-10-06
status: developing
sources: ["[[PCA9548A Datasheet]]", "[[P82B715 Datasheet]]"]
---

Texas Instruments의 8채널 I2C 멀티플렉서 IC. [[모의장치]]에서 [[ESP32-S3-WROOM-1]]의 I2C 1버스를 [[SEN55]] 3대로 나누는 데 쓴다.

## 이 프로젝트에서의 역할

SEN55는 I2C 주소가 0x69로 고정이라 ([[Sensirion SEN5x Datasheet]]) 3대를 한 버스에 그대로 붙일 수 없다. PCA9548A는 업스트림 SCL/SDA 한 쌍을 여덟 개의 다운스트림 채널로 나누고, 8비트 제어 레지스터로 채널을 선택하는 방식으로 이 주소 충돌을 해결한다 ([[PCA9548A Datasheet]]). ESP32-S3의 I2C 1버스를 PCA9548A에 물리고, 채널 0~2에 SEN55를 한 대씩 연결하기로 했다 (사용자 확인 2026-09-07).

## 연결 결정

**주소는 0x70 고정.** A0=A1=A2=GND로 접지한다 (사용자 확인 2026-09-07). PCA9548A 자신의 슬레이브 주소는 A0~A2 하드웨어 핀으로 0x70~0x77 중 정하는데 ([[PCA9548A Datasheet]]), 이 구성에서는 SEN55가 채널로 분리되므로 멀티플렉서 자체 주소는 하나만 있으면 된다.

**RESET 핀은 쓰지 않는다.** VCC로 풀업 저항만 연결한다 (사용자 확인 2026-09-07). PCA9548A 데이터시트는 미사용 시 이렇게 배선하라고 명시한다 ([[PCA9548A Datasheet]]).

**배치는 챔버 상단 외부, [[ESP32-S3-WROOM-1]]과 함께.** 챔버 내부에는 SEN55만 두고 나머지 전장은 챔버 상단 외부에 둔다 (사용자 확인 2026-09-07). 둘을 싣는 기판은 자체 PCB다 (사용자 확인 2026-10-06). SEN55의 I2C 배선 10 cm 미만 권고([[Sensirion SEN5x Datasheet]])가 PCA9548A~SEN55 구간에 걸리는 문제는 [[모의장치]]의 Contradictions 참조. 해법으로 채널 0~2 출력마다 [[P82B715]] 버스 익스텐더 한 쌍을 두는 구성을 상정했고 (사용자 확인 2026-09-07), P82B715를 쓰기로 했다 (사용자 확인 2026-10-06). 이 경우 각 채널의 다운스트림 풀업은 P82B715 설계 절차에 따라 구간별로 다시 정한다 ([[P82B715 Datasheet]]).

전원전압 2.3~5.5 V, 클럭 0~400 kHz를 지원하므로 ([[PCA9548A Datasheet]]) ESP32-S3와 SEN55가 공유하는 3.3 V 도메인·100 kbit/s 이하 속도에 그대로 들어간다.
