SunoopDogg/airo-tips/wiki/topics/EnerX-0.5P.md

---
title: EnerX-0.5P
type: topic
tags: [상용ESS, 제품, 화재감지, bms]
created: 2026-09-08
updated: 2026-09-08
status: developing
sources: ["[[EnerX-0.5P Battery Container Operating Instruction and Maintenance Manual]]"]
---

CATL의 액체냉각 컨테이너형 상용 ESS 제품. 이 프로젝트가 만드는 것이 아니라, 실제 상용 ESS가 화재를 어떻게 검출·판정·대응하는지 보기 위한 참고 사례다.

## 무엇인가

20ft 컨테이너에 LFP 셀 3328개(8랙 × 4모듈 × 104S, 530 Ah/3.2 V)를 담은 5644 kWh, 1040~1500 VDC 시스템으로, 배터리·BMS·소화시스템(FSS)·열관리시스템(TMS)·보조배전으로 구성된다 ([[EnerX-0.5P Battery Container Operating Instruction and Maintenance Manual]]). 컨테이너 규격으로 NFPA855·UL9540A·UL9540 등을 충족한다고 밝힌다 (같은 문헌). 위키가 근거로 삼은 매뉴얼은 2024-08-01자 Rev 1.0 초안이며 셀 구성·랙당 모듈 수 같은 수치가 절마다 어긋나는 곳이 있다 (같은 문헌).

## 화재를 어떻게 감지하는가

배터리실에 **H2 검출기 1, CO 검출기 1, 열감지기 2, 연기감지기 2**, 전기실에 연기감지기 1을 두고, 모든 검출 신호를 화재수신기(ARC-100)가 받아 처리한다 ([[EnerX-0.5P Battery Container Operating Instruction and Maintenance Manual]]). 즉 상용 ESS의 검출 채널은 **가스·열·연기 셋**이고, 이는 [[배터리 화재감지 5단계]]의 근거 논문이 쓴 오프가스·열·연기 세 축과 같다.

판정은 단일 센서가 아니라 조합으로 등급을 나눈다 (같은 문헌).

| 판정 | 조건 | 결과 |
|---|---|---|
| 배기환기 기동 | H2 **또는** CO 검출기 경보 | 루버 + 방폭팬 가동, 자동 정지 없음 |
| Fire system fault level 1 | 센서 **하나라도** 경보 | EMS가 PCS 전원 차단 |
| Fire system fault level 2 | 배터리실 열 1 **+** 연기 1, 또는 열 2 | EMS가 PCS 전원 차단 |

**가스가 가장 이른 트리거다.** 가스 검출기 경보만으로 환기가 시작되고 PCS가 끊기며, 열+연기 AND 조합이 그 다음 등급을 연다. [[벤팅 가스]]를 조기감지의 축으로 삼는 이 프로젝트의 전제와 같은 구조이고, 논문 알고리즘이 오프가스 ○ 단독을 3단계(벤팅), 오프가스+연기를 4단계로 두는 것과 순서가 맞는다. 다만 상용 제품이 검출하는 가스 종은 H2와 CO로 명시되어 있고, 이 프로젝트는 [[SEN55]]의 [[VOC Index]]로 오프가스를 잡는다 — 검출 대상 물질이 다르다.

유지보수 점검에도 "연기+가스 동시 트리거", "온도+연기 동시 트리거" 시 경보 동작 확인이 들어 있어, 조합 판정이 설계상 검증 대상임을 보여 준다 (같은 문헌).

## 감지 뒤 무엇을 하는가

FSS 제어 전략은 4단계다 ([[EnerX-0.5P Battery Container Operating Instruction and Maintenance Manual]]): ① 경보 → ② 배기환기로 폭연 방지(NFPA 69) → ③ 에어로졸 방출로 초기 화재 진압(옵션) → ④ 살수로 확산 억제(옵션). 이는 [[열폭주]] 페이지가 논문에서 끌어온 단계별 대응 — 벤팅 단계에서 전력 차단, 열폭주 단계에서 냉각·소화, ESS 화재 단계에서 가연성 가스 폭발 방지 — 를 상용 제품이 어떻게 구현하는지 보여 준다. 특히 2단계 배기환기가 가스 경보에 곧바로 묶여 있다는 점이, 벤팅 가스 농축에 의한 폭발을 열폭주보다 먼저 막으려는 설계다.

## BMS가 내는 데이터

BMS는 MBMU–SBMU–CSC 3계층으로 셀 전압·모듈 온도(모듈당 11점)·전류·총전압을 감시하고, SOC·SOH·SOP를 정밀도 5 %로 산출해 EMS에 올린다. 외부 통신은 ETH 모듈의 Modbus TCP/IP와 CAN(ACAN 250 k, 그 외 500 k)·RS485다 (같은 문헌). 상세는 [[ESS-BMS 연동 데이터]]에서 이 프로젝트의 7종과 대조한다.

고장은 CAT 1~7로 나뉘어 CAT 4부터 고장 랙을, CAT 6부터 전 랙을 차단하며, 건접점은 CAT 6부터 열린다 (같은 문헌). 셀 과온·저온, 셀 온도차·전압차 같은 열폭주 관련 이상은 시스템 상태 워드의 비트로 EMS가 읽을 수 있다 (같은 문헌).

## 이 프로젝트와의 관계

[[모의장치]]는 실제 컨테이너가 아니라 밀폐 챔버에 환경만 모사하는 장치이므로, 이 제품은 비교 대상이지 재현 대상이 아니다. 상용 제품이 가스·열·연기 3채널의 조합으로 판정하고 가스를 최우선 트리거로 둔다는 사실은 [[정량적 성과지표]] 지표 3 알고리즘의 설계 방향이 상용 관행과 일치한다는 참고가 된다.
