SunoopDogg/airo-tips/wiki/topics/ESS-BMS 연동 데이터.md

---
title: ESS-BMS 연동 데이터
type: topic
tags: [bms, 데이터수집, kpi]
created: 2026-09-04
updated: 2026-09-08
status: developing
sources: ["[[EnerX-0.5P Battery Container Operating Instruction and Maintenance Manual]]", "[[개발용역 계약서]]", "[[정량적 성과지표 항목표]]", "[[ESS 화재감지 알고리즘 (2023 추계학술발표논문집)]]"]
---

ESS의 BMS에서 끌어와야 하는 데이터 항목들. 계약과 검수 모두 "7종"이라는 개수로 걸려 있다.

## 일곱 종

계약서 용역범위 3항과 항목표가 같은 목록을 든다 ([[개발용역 계약서]], [[정량적 성과지표 항목표]]).

| 데이터 | 성격 |
|---|---|
| SOC | 배터리 상태 |
| SOH | 배터리 상태 |
| 전압 | SOC·SOH 산출 입력 |
| 전류 | SOC·SOH 산출 입력 |
| 충·방전 시간 | SOC·SOH 산출 입력 |
| 온도 | 안전 |
| 순간 방전전류 | 안전 |

항목표의 근거란은 이 구성을 "SOC, SOH 외 이를 산출할 수 있는 데이터(전압, 전류, 충/방전 시간)와 배터리 안전을 위한 데이터(온도, 순간 방전전류)"로 설명한다 ([[정량적 성과지표 항목표]]). 즉 7종은 임의의 묶음이 아니라 상태 2 + 산출 입력 3 + 안전 2의 구조다. 이 항목에는 "내부적 요인"이라는 구분이 붙어 있어, "외부적 영향"으로 분류된 [[배터리 화재감지 5단계]]와 짝을 이룬다.

## 목표치가 기존 수준보다 낮다

목표는 7개, 비중 20%다. 그런데 항목표가 제시한 세계 최고 수준은 10개 이상(미국 / Tesla), 국내 수준은 8개 이상(대한민국 / LG)이다 ([[정량적 성과지표 항목표]]).

[[정량적 성과지표]] 다섯 항목 중 **유일하게 목표가 기존 국내 수준에 못 미치는 지표**다. 불꽃 관련 두 지표가 세계 최고를 넘겨 잡은 것과 대조된다. 항목표에는 이 격차에 대한 설명이 없다.

## 평가 방법

공인인증기관이 각 항목별 데이터 신호 7개를 반복 발생시켜 전송 로그를 기록하고, 일곱 데이터가 정상 수신되는지 확인한다 ([[정량적 성과지표 항목표]]). 즉 검수는 데이터의 정확도가 아니라 **수신 여부**만 본다.

반복 횟수는 원문 셀에 "10회"로 적혀 있고 같은 행 오른쪽에 "--> 20회"라는 수정 메모가 따로 달려 있다. 항목표만으로는 어느 쪽이 확정본인지 알 수 없다.

## 전압 신호는 셀 형태에 의존한다

일곱 종 중 전압은 [[열폭주]]의 직접 이상징후이기도 하다. 다만 그 거동이 셀 형태에 따라 다르다. 원통형과 각형은 열폭주가 진행되며 전압이 강하하지만, **파우치형은 규칙적인 전압 변동이 없다** ([[ESS 화재감지 알고리즘 (2023 추계학술발표논문집)]]).

**따라서 전압 채널의 유효성은 대상 셀의 형태에 달려 있다.** 파우치형이라면 이 채널은 열폭주 감지에 쓸 수 없다.

논문 실측(원통형 셀)에서는 벤팅 이전에 전압이 순간 감소했는데, 이는 원통형 배터리 내부 보호회로가 고열로 동작한 것으로 논문이 추측하는 현상이라 각형에 그대로 옮겨지지 않는다. 벤팅 시기의 2차 감소는 확인되었다 (같은 문헌).

BMS 폴링 주기가 이 전압 변화를 잡아낼 만큼 촘촘한지는 아직 어느 원문에도 없다.

## 전송 속도와의 관계

수집한 데이터를 관제 시스템으로 실어 나르는 지연시간은 별도 지표(0.3초 이하)로 관리된다. [[정량적 성과지표]]의 지표 5 항목을 참조.

## 상용 BMS가 실제로 내는 것

CATL [[EnerX-0.5P]]의 BMS는 셀 전압·모듈 온도(모듈당 11점)·배터리 전류·총전압을 감시하고, SOC·SOH·SOP를 정밀도 5 %로 산출해 운전 상태와 함께 EMS에 올리며, 데이터 기록과 고장 기록도 EMS에 제공한다 ([[EnerX-0.5P Battery Container Operating Instruction and Maintenance Manual]]). SOE도 저장 신호로 다룬다 (같은 문헌).

| 이 프로젝트 7종 | EnerX-0.5P BMS |
|---|---|
| SOC, SOH | 산출·업로드 (정밀도 5 %). SOP·SOE 추가 |
| 전압 | 셀 전압, 총전압 |
| 전류 | 배터리 전류 |
| 충·방전 시간 | 명시 없음 |
| 온도 | 모듈 온도 11점, MBMU 환경온도 2점(±3 ℃) |
| 순간 방전전류 | 명시 없음. 최대 방전전류 2714 A/1분 사양과 방전 과전류 경고 비트가 있음 |

외부 인터페이스는 ETH 모듈의 Modbus TCP/IP(고정 IP 또는 DHCP), ACAN(250 k)·RS485다 (같은 문헌). 상태는 레지스터의 시스템 상태 워드로 읽고, 셀 과·저전압, 과·저온, 온도차·전압차, 충·방전 과전류 같은 경고가 비트로 나온다 (같은 문헌). 고장은 CAT 1~7 등급으로 EMS에 보고되고 CAT 6부터 건접점이 열린다 (같은 문헌). 폴링 주기는 이 매뉴얼에도 없다.

## 아직 정해지지 않은 것

BMS 통신 프로토콜, 폴링 주기, 대상 배터리 모델이 계약서와 항목표 어디에도 없다. 개발물의 상세 규격은 별도 협의 문서에서 정하기로 되어 있다 ([[개발용역 계약서]]).
