SunoopDogg/airo-tips/wiki/topics/정량적 성과지표.md

---
title: 정량적 성과지표
type: topic
tags: [kpi, 검수기준, 프로젝트목표]
created: 2026-09-04
updated: 2026-09-07
status: developing
sources: ["[[정량적 성과지표 항목표]]", "[[개발용역 계약서]]", "[[ESS 화재감지 알고리즘 (2023 추계학술발표논문집)]]", "[[Sensirion SEN5x Datasheet]]"]
---

이 프로젝트의 개발 완료 검수 기준이자 사실상의 프로젝트 목표다. 다섯 개 항목을 **모두** 달성해야 검수가 끝난다.

계약서 별첨이 이 다섯 지표를 검수 기준으로 못 박았고 ([[개발용역 계약서]]), 목표 설정 근거와 평가 방법까지 담은 상세본이 [[정량적 성과지표 항목표]]다. [[에어로랩]]이 달성 주체이고, 평가는 다섯 항목 전부 **공인인증기관**이 수행한다 ([[정량적 성과지표 항목표]]).

## 다섯 지표

| # | 평가항목 | 단위 | 비중 | 목표치 | 세계 최고 | 국내 |
|---|---|---|---|---|---|---|
| 1 | 불꽃 구분 소요시간 (인식속도) | SEC | 10% | 0.8 이하 | 1sec (미국 / Torch Sensors) | 2sec (한화테크윈) |
| 2 | 불꽃 구분 정확도 (인식성능) | % | 20% | 99% 이상 | 98% (미국 / Torch Sensors) | 95% (한화테크윈) |
| 3 | 배터리 화재감지 단계 분류 | 단계 | 20% | 5단계 | 5단계 (미국 / Underwriters Laboratories) | 5단계 (한국산업기술시험원) |
| 4 | ESS-BMS 연동 기반 데이터 종류 | 개 | 20% | 7개 | 10개 이상 (미국 / Tesla) | 8개 이상 (LG) |
| 5 | ESS 이상 징후 데이터 전송 지속시간 | SEC | 20% | 0.3 이하 | 0.20 sec (미국 / Tesla) | 0.65 sec (한국전력공사) |

출처는 [[정량적 성과지표 항목표]]이며, 항목·단위·비중·목표치는 [[개발용역 계약서]] 별첨과 일치한다.

1·2번은 [[불꽃검출 알고리즘]], 3번은 [[배터리 화재감지 5단계]], 4번은 [[ESS-BMS 연동 데이터]]에서 자세히 다룬다. 5번은 아래 참조.

지표 3의 "5단계"가 어느 다섯인지는 근거 문헌 [[ESS 화재감지 알고리즘 (2023 추계학술발표논문집)]]이 정의한다 — 정상 · 비배터리 화재 · 벤팅 · 열폭주 · ESS 화재이며, 계약서에 적힌 다습·먼지·고온은 단계가 아니라 오탐 내성을 보는 시험 조건이다. [[배터리 화재감지 5단계]] 참조.

지표 3을 시연하는 [[모의장치]]의 환경 센서는 [[SEN55]]로 확정했다 (사용자 확인 2026-09-07). 항목표가 요구하는 센서 4종(온도·습도·먼지·오프가스)이 이 한 모듈로 접히고, 오프가스는 [[VOC Index]]로 검출한다 (같은 확인).

## 지표 5 — 이상징후 데이터 전송 지속시간

ESS 이상 징후(온도 상승, 과전류, 과전압, 충·방전 이상 등) 발생 시 센서와 BMS에서 수집한 전압·전류· 온도·SOC·SOH 등 주요 상태 데이터와 촬영 이미지를 실시간 전송하는 것이 목적이다 ([[정량적 성과지표 항목표]]). 계약서 용역범위의 "실시간 이상징후 데이터 전송 시스템 개발(0.3초 이하)"이 이 지표에 대응한다 ([[개발용역 계약서]]).

평가는 열폭주 모의·과전류 발생·고온 환경 세 가지 이상 상황을 각각 10회 인위적으로 발생시키고, BMS 센서가 이상 신호를 검출한 시점부터 관제 시스템이 데이터를 수신한 시점까지의 지연시간을 반복 측정해 평균을 내는 방식이다 ([[정량적 성과지표 항목표]]). 열폭주 모의 조건은 [[열폭주]]와 [[모의장치]] 쪽 문제로 이어진다.

목표 0.3초는 국내 수준(한전 0.65초)보다 빠르고 세계 최고(Tesla 0.20초)에는 못 미치는 중간값이다.

## 벤치마크에서 읽히는 것

- 불꽃 인식속도(0.8초)와 정확도(99%)는 **세계 최고 수준으로 제시된 값(1초 / 98%)을 넘겨 잡은** 목표다. 항목표는 "시스템 개발 예산의 크기와 요구사항에 따라 기능의 편차가 발생하여 일률적인 성능지표를 적용하기 어렵다"는 단서를 두 항목 모두에 달아 두었다 ([[정량적 성과지표 항목표]]).
- 반대로 BMS 데이터 종류 7개는 **국내 수준으로 제시된 8개 이상보다 낮다**. 유일하게 기존 수준에 못 미치는 목표다. 자세한 것은 [[ESS-BMS 연동 데이터]].
- 화재감지 5단계는 국내외 모두 5단계로, 목표가 기존 수준과 동일하다. 국내 수준의 출처인 [[한국산업기술시험원]]은 근거 문헌의 공동 연구기관이기도 하다 ([[ESS 화재감지 알고리즘 (2023 추계학술발표논문집)]]).

## 비중 합계 90% — 나머지 10%는 제거된 항목

계약서 별첨에 적힌 다섯 항목의 비중은 10 + 20 + 20 + 20 + 20 = **90%**다 ([[개발용역 계약서]]). [[정량적 성과지표 항목표]]에는 6행에 순번 6과 비중 0.1만 남아 있고 평가항목·단위·목표치·평가방법이 모두 비어 있다.

이 10%는 여섯 번째 항목의 잔재다. 그 항목은 이 프로젝트의 과업이 아니어서 제거되었고, 비중 자리만 남았다 (사용자 확인 2026-09-07). 따라서 검수 기준은 다섯 항목 90%로 완결이며 미배정 비중은 없다.

## 항목표에만 있고 계약서 별첨에는 없는 것

목표 설정 근거, 세계·국내 성능수준 벤치마크, 항목별 평가 방법과 평가 환경, 그리고 3·4번 항목에 붙은 "외부적 영향" / "내부적 요인" 구분은 [[정량적 성과지표 항목표]]에만 있다. 계약서 별첨은 항목·단위·비중·목표치 네 열로 축약된 판본이다.
