SunoopDogg/airo-tips/wiki/sources/P82B715 Datasheet.md

---
title: P82B715 Datasheet
type: source
tags: [sensor-spec, 버스익스텐더]
created: 2026-09-07
updated: 2026-09-07
status: developing
sources: []
source_path: raw/sensor-spec/p82b715.pdf
ingested: 2026-09-07
---

Texas Instruments의 P82B715 I2C 버스 익스텐더 데이터시트(SCPS145B, 2007년 12월 초판, 2016년 2월 개정 B). I2C의 SDA·SCL을 전류 증폭으로 버퍼링해 긴 케이블과 큰 버스 정전용량을 감당하게 하는 IC의 사양과 설계 절차를 담는다.

## 무엇인가

본문 14쪽에 패키지 옵션 부록(2025-11-10자)과 포장 자료(2026-08-10자), SOIC 패키지 도면이 붙어 있다. 개정 B는 개정 A(2008년 2월)에 ESD 표, 기능 설명, 응용·구현, 전원·레이아웃 절을 추가한 판이다. 응용 절(9장)은 TI 부품 사양의 일부가 아니며 정확성을 보증하지 않는다는 주석이 달려 있다.

주문 가능 품번은 SOIC-8(P82B715DR 계열, 활성)과 PDIP-8(P82B715P 계열, 활성)이며, P82B715D는 단종(Obsolete)이다. 동작온도는 모두 −40~85 °C.

## 동작 원리

I2C 표준의 400 pF 버스 정전용량 한계가 통신 거리를 몇 미터로 묶는다. P82B715는 I2C 쪽 핀(Sx/Sy)에서 버퍼드 버스 쪽 핀(Lx/Ly)으로 **단방향 아날로그 전류 증폭**을 한다 — Sx로 흘러나오는 싱크 전류의 10배를 Lx로 싱크한다. 반대 방향(Lx→Sx)은 내부 30 Ω 저항을 지나는 수동 경로라 지연이 거의 없다. 전압 이득은 1이고, 논리 레벨은 VCC와 무관하게 연결된 장치가 낸 레벨 그대로 지나가되 VCC + 0.7 V에서 클램프된다. 이 구조가 멀티마스터·오픈드레인 특성을 그대로 보존한다.

이렇게 버퍼드 버스 쪽의 정전용량 한계를 3000 pF(약 3 nF)로 늘리고, "10배 낮은 임피던스의 배선"으로 노이즈 내성을 높이며, 저가 트위스티드 페어로 50 m 이상 I2C를 보낸다는 것이 특징란의 주장이다. 응용 예로 HDMI DDC, 장거리 I2C, 산업용 통신을 든다.

**기본 사용법은 긴 케이블 양 끝에 한 개씩 쌍으로 두는 것이다.** 한쪽 P82B715의 Lx를 다른 쪽의 Lx에, Ly를 Ly에 연결한다. 여러 개를 Lx/Ly 포트로 스타·멀티드롭으로 묶는 것도 총 정전용량이 약 3000 pF 이하(어느 Sx/Sy 기준으로도 400 pF 이하)이면 제한 없이 허용된다. 버퍼드 버스 양 끝의 전원전압은 같아야 하고, 크게 다르면 노이즈 마진을 잃는다.

## 핀

8핀. 1 NC, 2 Lx(버퍼드 데이터, LDA), 3 Sx(SDA — 풀업으로 I2C 마스터 VCC에), 4 GND, 5 NC, 6 Sy(SCL — 풀업으로 I2C 마스터 VCC에), 7 Ly(버퍼드 클럭, LCL), 8 VCC. Sx와 Sy는 회로가 동일해 SDA/SCL 어느 쪽으로도 쓸 수 있다.

## 전기 사양

| 항목 | 값 |
|---|---|
| VCC 절대최대 | −0.3~12 V |
| VCC 권장 | 4.5~12 V |
| VCC 절대 최소 | 3 V (성능 저하 동반) |
| 동작 자유공기 온도 | −40~85 °C |
| Sx/Sy·Lx/Ly 버스 전압 | 0~VCC |
| 연속 출력전류 (핀당) | 60 mA |
| 대기 전류 ICC (Sx=Sy=VCC, 5 V) | 14 mA (12 V: 15 mA) |
| ICC, 양쪽 입력 로우·버퍼 출력 30 mA 싱크 | 22 mA |
| Lx/Ly 정적 싱크 | 30 mA (VLx = 0.4 V) |
| Lx/Ly 누설 | 200 µA |
| 입출력 임피던스 (버퍼 활성) | 8~13 Ω (typ 10) |
| 버퍼 지연 (Sx 입력→Lx VCC/2 통과) | 최대 250 ns |
| Lx→Sx 지연 | 0 ns (수동 경로) |

VCC가 4.5 V 미만이면 정적 싱크 성능은 유지되지만 VCC/2를 지날 때의 동적 싱크 전류가 줄어 하강 시간이 늘어난다. **온도 전 범위 성능 보증은 4.5 V부터**이고 그 아래는 디레이팅이 적용된다. 아주 낮은 로직 전압을 쓰는 경우에도 VCC는 최소 3.3 V, 가급적 더 높게 두라고 한다.

기능 모드 절은 버스가 idle·high일 때 "거의 또는 전혀 전류가 흐르지 않고 Lx/Ly 버퍼가 켜지지 않는다"고 하는데, 전기 사양표의 대기 전류는 Sx=Sy=VCC 조건에서 14 mA다. 두 서술이 같은 문서 안에 있다.

ESD: HBM ±2500 V, CDM ±1000 V, MM ±400 V. 래치업 100 mA 이상(JESD 78 Class II).

## 풀업 설계 절차 (9.2.2)

풀업은 버스 **구간마다 따로** 두는 것이 최선이다(버퍼드 버스에 하나만 두는 구성도 가능하나 성능이 떨어진다). 100 kHz 시스템에서 각 노드의 시간상수(저항 × 정전용량)를 1 µs 이하로 맞추면 상승시간 요구가 충족된다:

`R = 1 µs / (C_device + C_wiring)`

정전용량을 못 재면 장치당 10 pF + 트레이스 10 pF, 케이블은 **미터당 50~100 pF**로 가정한다. 설계 예(Table 1): VCC 3.3 V, Lx 정전용량 3000 pF, Sx 풀업 4.7 kΩ, Lx 풀업 330 Ω. 그림 6 예: 로컬 I2C 50 pF → 20 kΩ, 버퍼드 버스 3000 pF → 330 Ω, 원격 I2C 30 pF → 33 kΩ.

버퍼드 버스 풀업이 단독일 때의 등가 정전용량은 버퍼드 버스 정전용량 + 연결된 모든 I2C 노드 정전용량 합의 10배이며, 4 nF를 넘지 않아야 한다.

전류 한계: Lx 핀이 구동하는 모든 풀업의 병렬 합성 Rp에 대해 `(VCC(max) − 0.4) / Rp < 30 mA`. 5 V ± 10% 시스템의 최소 풀업은 170 Ω. Sx 쪽 장치가 실제로 싱크해야 하는 전류는 Lx 전류의 1/10이므로, 로컬 풀업에 다른 구간 풀업의 10배 값을 병렬한 것이 유효 부하가 된다.

## 레이아웃·전원

VCC에 1 µF(전원 글리치 대비)과 0.1 µF(고주파 리플) 디커플링. 접지핀은 넓은 폴리곤과 다수 비아로 그라운드 플레인에 저임피던스로 잇는다. TCA9517 같은 전압 오프셋형 버스 버퍼와도 호환된다(오프셋 전압을 그대로 복제·전달).

## 인용할 만한 문구

"Drives 10× Lower-Impedance Bus Wiring for Improved Noise Immunity" — 노이즈 내성 개선 주장의 근거.

"This is achieved by using one P82B715 device at each end of a long cable." — 쌍으로 쓰는 기본 구성.

"Note that full performance over temperature is ensured only from 4.5 V. Specification deratings apply when its supply voltage is reduced below 4.5 V." — 3.3 V 구동 시의 제약.

"cables range from 50 pF to 100 pF per meter" — 케이블 정전용량 추정치.
