SunoopDogg/airo-tips/wiki/topics/배터리 화재감지 5단계.md

---
title: 배터리 화재감지 5단계
type: topic
tags: [알고리즘, 화재감지, kpi]
created: 2026-09-04
updated: 2026-09-08
status: developing
sources: ["[[EnerX-0.5P Battery Container Operating Instruction and Maintenance Manual]]", "[[ESS 화재감지 알고리즘 (2023 추계학술발표논문집)]]", "[[개발용역 계약서]]", "[[정량적 성과지표 항목표]]", "[[Sensirion SEN5x Datasheet]]"]
---

배터리 화재를 하나의 사건이 아니라 진행 단계로 나누어 감지하는 알고리즘. 단계별로 예방·진압·차단 대응을 달리 하기 위한 구분이며, [[정량적 성과지표]] 지표 3(비중 20%)이 이것의 단계 수를 5로 못 박고 있다.

## 다섯 단계 — 확정

근거 문헌 [[ESS 화재감지 알고리즘 (2023 추계학술발표논문집)]]이 정의한 화재 발생 메커니즘 다섯 단계를 이 프로젝트 알고리즘의 출력 단계로 삼는다 (사용자 확인 2026-09-04).

| 단계 | 이름 | 상태 |
|---|---|---|
| 1 | 정상 | 배터리를 포함한 ESS 구성장치가 고장 없이 동작 |
| 2 | 비배터리 화재 발생 | 배터리 개입 없는 화재. 과부하로 인한 케이블·부스바 화재, 장치 결함·과열 |
| 3 | 배터리 벤팅 발생 | 단배터리가 지속 스트레스로 벤팅. [[벤팅 가스]] 배출 |
| 4 | 배터리 열폭주 발생 | 벤팅 이후 [[열폭주]] 발생. 인접 배터리로 열적 스트레스 전파 |
| 5 | ESS 화재 발생 | 단배터리 화재가 모듈·랙 단위로 확산 |

각 단계의 대응이 다르다. 2단계는 조기 진압하지 않으면 배터리에 열적 스트레스를 가하고, 3단계는 시스템 긴급정지나 메인 전력 차단을 해야 하며, 4단계는 냉각·소화를 시도해야 하고, 5단계는 일반적인 소화 방식이 듣지 않으므로 가연성 가스 농축에 의한 폭발을 막는 것이 최우선이 된다 ([[ESS 화재감지 알고리즘 (2023 추계학술발표논문집)]]).

**감지 가치는 3단계에 몰려 있다.** 3→4 전이가 논문 실측으로 2분 24초이므로(같은 문헌), 3단계를 놓치면 대응 시간이 사실상 남지 않는다.

## 계약서의 다섯은 단계가 아니라 시험 조건이다

계약서 용역범위 2항은 "다습환경 → 먼지환경 → 정상상태 → 벤팅(오프가스) → 고온환경"을 나열한다 ([[개발용역 계약서]]). 이 다섯은 **알고리즘의 출력 단계가 아니라 검수 시험에서 인위적으로 만들어 주는 입력 조건**이다. [[정량적 성과지표 항목표]]가 이를 "① 가습기 분무를 통한 다습환경 구성 … ⑤ 열풍기 바람을 통한 고온환경 구성의 5단계 조건에서 알고리즘의 반응을 평가함"으로 서술한다.

즉 두 개의 서로 다른 다섯이 있다.

| | 출력 단계 (알고리즘이 판정) | 입력 조건 (시험자가 조성) |
|---|---|---|
| 출처 | [[ESS 화재감지 알고리즘 (2023 추계학술발표논문집)]] | [[정량적 성과지표 항목표]] 평가환경 |
| 내용 | 정상 · 비배터리 화재 · 벤팅 · 열폭주 · ESS 화재 | 다습 · 먼지 · 정상 · 벤팅(DEC 분사) · 고온 |
| 겹치는 것 | 정상, 벤팅 | 정상, 벤팅 |

**다습·먼지·고온은 근거 문헌에 화재 단계로 존재하지 않는다.** 이 셋은 오탐(false positive)을 유발하는 환경 조건이고, 검수가 요구하는 것은 알고리즘이 이 조건들을 화재로 오인하지 않고 1단계 정상으로 판정하는 것이다. 다시 말해 지표 3의 시험은 **5단계 분류 능력과 오탐 내성을 한 번에 보는 시험**이다.

## 논문의 판정 논리

논문 알고리즘은 임계값 튜닝이 아니라 센서 알람 조합의 불린 진리표다 ([[ESS 화재감지 알고리즘 (2023 추계학술발표논문집)]]).

| 단계 | 오프가스 | 연기 | 열 |
|---|---|---|---|
| 1 정상 | ✕ | ✕ | ✕ |
| 2 비배터리 화재 | ✕ | ○ | ✕ |
| 3 배터리 벤팅 | ○ | ✕ | ✕ |
| 4 배터리 열폭주 | ○ | ○ | ✕ |
| 5 ESS 화재 | ○ | ○ | ○ |

논문은 이 셋을 오프가스 검출센서, 공기흡입형 연기감지기, 차동식 열감지기(급격한 온도 *상승률*에 반응, 정온식과 다름)로 구현하고 PLC에 물려 1.0~5.0 Vdc로 단계를 출력했다.

## 이 프로젝트의 구현 차이

| 채널 | 논문 | 이 프로젝트 |
|---|---|---|
| 오프가스 | 오프가스 검출센서 | [[SEN55]]의 **[[VOC Index]]** |
| 연기 · 불꽃 | 공기흡입형 연기감지기 | **영상 AI 추론·검출** ([[불꽃검출 알고리즘]]) |
| 열 | 차동식 열감지기 | SEN55의 보정 온도 출력 |
| — | 없음 | SEN55의 상대습도와 PM1.0/2.5/4.0/10 (오탐 조건 판별용) |

연기·불꽃은 센서가 아니라 카메라와 영상 AI가 맡고 (사용자 확인 2026-09-04), 나머지 네 채널은 [[SEN55]] 한 모듈에서 나온다 (사용자 확인 2026-09-07). 항목표가 요구하는 센서 4종은 온도·습도·먼지·오프가스다 ([[정량적 성과지표 항목표]]). 습도·먼지 채널이 논문에는 없는데, 이는 논문이 다루지 않은 오탐 조건(다습·먼지환경)을 판별해야 하기 때문이다.

**진리표의 오프가스 칸에 넣을 규칙이 아직 없다.** 논문의 오프가스 칸은 ○/✕, 즉 트리거형 알람을 전제한다. [[VOC Index]]는 알고리즘이 최근 12시간 이력에서 학습한 기준선 위의 1–500 상대 숫자이고, 높은 값이 지속되면 게이팅이 최대 180분간 추정기를 얼린다 ([[Sensirion SEN5x Datasheet]]). 연속값을 ○/✕로 바꾸는 규칙이 3·4·5단계 판정 전부를 지탱하므로, 이 알고리즘 설계에서 가장 먼저 정해져야 하는 항목이다. [[모의장치]] 참조.

온도 칸도 그대로 옮겨지지 않는다. 논문이 쓴 차동식 열감지기는 온도 *상승률*에 반응하는 알람 소자이고, SEN55가 내는 것은 매초 갱신되는 보정 온도값이다 ([[Sensirion SEN5x Datasheet]]). 상승률 판정은 알고리즘 쪽에서 만들어야 한다.

## 상용 ESS의 판정 논리와 비교

CATL의 상용 컨테이너 [[EnerX-0.5P]]도 배터리실에 가스(H2·CO)·열·연기 세 종의 검출기를 두고 조합으로 등급을 나눈다 ([[EnerX-0.5P Battery Container Operating Instruction and Maintenance Manual]]). 가스 검출기 경보만으로 배기환기가 기동하고 PCS가 차단되며, "열 1 + 연기 1" 또는 "열 2"의 AND 조합이 다음 등급(Fire system fault level 2)을 연다 (같은 문헌). 논문 진리표에서 오프가스 ○ 단독이 3단계이고 연기·열이 더해질수록 단계가 오르는 구조와 같은 방향이다. 다만 상용 제품의 출력은 화재 단계가 아니라 건접점 등급이고, 제어 전략도 경보→환기→에어로졸→살수의 4단계여서 논문의 다섯 단계와 일대일로 대응하지는 않는다 (같은 문헌).

## 설계상의 어려운 지점 — 먼지가 양날이다

논문 실측에서 먼지 센서는 **벤팅 시에는 유의미한 변화가 없고 열폭주 시 포화 상태까지 상승**했다 ([[ESS 화재감지 알고리즘 (2023 추계학술발표논문집)]]). 벤팅·열폭주 시 먼지와 유사한 입자 크기의 부산물이 발생하기 때문이다 (같은 문헌).

그런데 검수 시험은 청소기 먼지 배출구로 인위적 먼지환경을 만들고 알고리즘이 그것을 화재가 아닌 것으로 판정하길 요구한다 ([[정량적 성과지표 항목표]]). 같은 먼지 상승 신호가 한쪽에서는 정상으로, 다른 쪽에서는 4단계 열폭주로 읽혀야 한다. **먼지 단독으로는 판정이 불가능하고 오프가스 채널과 함께 봐야 갈린다** — 오프가스 없는 먼지 상승은 먼지환경, 오프가스와 함께 오는 먼지 포화는 열폭주다. 지표 3 알고리즘 설계의 실제 난점이 여기다.

같은 구조가 고온환경(열풍기)과 4·5단계 사이에도 있고, 다습환경은 오프가스·VOC 센서의 습도 간섭 문제로 이어진다.

## 벤팅 단계에서 쓸 수 있는 채널은 셋뿐

논문 실측상 벤팅 시점에 변화를 보인 것은 온도(순간 하락 후 재상승), 전압(2차 감소), 오프가스/VOC 뿐이었고 **산소·먼지·압력·LEL은 전부 침묵했다** ([[ESS 화재감지 알고리즘 (2023 추계학술발표논문집)]]). 3단계를 간접 징후로 잡겠다는 설계는 근거가 없다. 다만 압력·LEL의 무변화는 논문 챔버가 개방형인 탓일 수 있어, 밀폐 가능한 [[모의장치]]에서는 다시 확인할 여지가 있다.

## 목표치와 평가

목표는 5단계, 비중 20%. 세계 최고 5단계(미국 / Underwriters Laboratories), 국내 5단계(대한민국 / [[한국산업기술시험원]])로, 다섯 지표 중 목표가 기존 수준과 같은 유일한 항목이다 ([[정량적 성과지표 항목표]]). 항목표는 이 지표를 "외부적 영향"으로 분류해 [[ESS-BMS 연동 데이터]]("내부적 요인")와 짝지운다.

평가는 공인인증기관이 [[모의장치]]에서 위 다섯 조건을 조성해 알고리즘의 반응을 보는 방식이다 (같은 문헌).

## Contradictions

**어느 다섯인지는 판정되었다.** 계약서의 다섯(다습·먼지·정상·벤팅·고온)이 알고리즘의 출력 단계인지 시험 조건인지가 [[개발용역 계약서]]와 [[정량적 성과지표 항목표]] 사이에서 어긋나 있었다. 근거 문헌인 [[ESS 화재감지 알고리즘 (2023 추계학술발표논문집)]]을 읽어 판정한다.

- 논문의 다섯 단계는 정상 · 비배터리 화재 · 벤팅 · 열폭주 · ESS 화재이며, **다습·먼지·고온은 어느 단계로도 등장하지 않는다.** 따라서 계약서의 목록은 출력 단계일 수 없다.
- 항목표의 "조건에서 알고리즘의 반응을 평가함"이라는 문장이 맞았다. 계약서 용역범위 2항은 항목표의 평가환경 목록을 한 줄로 축약하면서 조건과 출력의 구분을 지운 표기다.

**계약 문언과의 어긋남은 해소되었다.** [[개발용역 계약서]] 용역범위 2항은 다섯 환경을 "배터리 화재감지 5단계 알고리즘"으로 적지만, 계약서의 "5단계"는 논문의 다섯 단계(정상·비배터리 화재·벤팅· 열폭주·ESS 화재)를 뜻하는 것으로 인정되었다 (사용자 확인 2026-09-07). 다습·먼지·고온은 출력 단계가 아니라 시험 조건이라는 위 판정이 계약 해석으로도 확정이다.

**서지 판본:** [[정량적 성과지표 항목표]]가 인용하는 근거 문헌은 한국산학기술학회 논문지 25(2), 538-547(2024) 6인 저자본이고, 위키가 근거로 삼은 것은 2023년 추계학술발표논문집 5인 저자본이다. 같은 연구의 발표본·게재본 관계이며 지표 3의 근거로 삼는 데 이견은 없다 (사용자 확인 2026-09-04).
