SunoopDogg/airo-tips/wiki/topics/벤팅 가스.md

---
title: 벤팅 가스
type: topic
tags: [현상, 오프가스, 조기감지]
created: 2026-09-04
updated: 2026-09-08
status: developing
sources: ["[[EnerX-0.5P Battery Container Operating Instruction and Maintenance Manual]]", "[[ESS 화재감지 알고리즘 (2023 추계학술발표논문집)]]", "[[정량적 성과지표 항목표]]", "[[Sensirion SEN5x Datasheet]]"]
---

단배터리가 열적·전기적·물리적 요인으로 지속 스트레스를 받아 벤팅이 발생하는 현상, 그리고 그때 배출되는 가스. 영문·업계 표기로는 오프가스(off-gas)이며 이 위키는 두 말을 같은 것으로 쓴다.

## 왜 이 프로젝트의 중심인가

[[열폭주]] 이전에 나타나는 마지막 뚜렷한 신호다. 논문은 오프가스를 "리튬이온배터리의 가장 명확하고 직접적인 이상징후"로 규정하고, 열폭주 발생 이전 벤팅 단계에서 발생한다는 점을 그 근거로 든다 ([[ESS 화재감지 알고리즘 (2023 추계학술발표논문집)]]).

[[배터리 화재감지 5단계]]에서 3단계(배터리 벤팅)를 여는 유일한 트리거이며, 논문 알고리즘에서 오프가스 검출기는 3·4·5단계 모두에 관여하는 축이다. 오프가스가 잡히지 않으면 나머지 조합 논리가 전부 무너진다.

## 벤팅 시점에 무엇이 보이는가

논문 실측에서 벤팅 시점에 변화를 보인 신호는 셋뿐이다 ([[ESS 화재감지 알고리즘 (2023 추계학술발표논문집)]]).

- **온도** — 지속 상승하던 온도가 28분 09초경 순간 소폭 하락 후 재상승. 가스 배출로 인한 현상이다.
- **오프가스 / VOC** — 오프가스 검출센서 트리거, VOC 센서 값 변화.
- **전압** — 벤팅 시기에 2차 감소.

반대로 **산소·먼지·압력·LEL 네 간접 센서는 벤팅 시점에 특별한 값 변화가 없었다** (같은 문헌). 간접 징후로 벤팅을 잡겠다는 설계는 이 실측에 근거가 없다.

## 벤팅 이후 열폭주까지

논문의 화재단계 시험에서 벤팅 알람부터 열폭주 알람까지 **2분 24초**였다 ([[ESS 화재감지 알고리즘 (2023 추계학술발표논문집)]]). 이 시간이 시스템 긴급정지나 메인 전력 차단 같은 대응에 쓸 수 있는 전부다. 벤팅 이후에도 오프가스와 같은 가연성 가스가 열폭주까지 계속 배출된다 (같은 문헌).

## 상용 ESS는 무엇을 검출하는가

CATL [[EnerX-0.5P]]는 배터리실에 **H2 검출기와 CO 검출기**를 각 1대 두고, 둘 중 하나의 경보만으로 화재수신기가 방폭팬과 루버를 켜 배터리실의 가연성 가스를 배출한다 ([[EnerX-0.5P Battery Container Operating Instruction and Maintenance Manual]]). 즉 상용 제품도 가스를 가장 이른 트리거로 삼고, 그 대응은 소화가 아니라 폭연 방지 환기다 (같은 문헌). 이 프로젝트가 [[VOC Index]]로 검출하려는 오프가스와 상용 제품이 검출하는 H2·CO는 물질이 다르므로, 상용 사례는 "가스 우선" 설계의 근거이지 검출 물질의 근거는 아니다.

## 어떻게 모의하는가

[[정량적 성과지표]] 지표 3 평가에서는 실제 벤팅을 일으키지 않고 **DEC 전해질 시료를 분사**해 벤팅을 모의한다 ([[정량적 성과지표 항목표]]). 즉 검수 시험이 요구하는 것은 실제 벤팅 가스가 아니라 전해질 증기에 대한 알고리즘의 반응이다. 실제 벤팅 가스 조성과 DEC 증기의 차이는 두 원문 어디에도 다뤄져 있지 않다. [[모의장치]] 참조.

## 무엇으로 검출하는가

논문은 전용 오프가스 검출센서를 썼고, 별도의 VOC 센서 값 변화도 함께 관측했다 ([[ESS 화재감지 알고리즘 (2023 추계학술발표논문집)]]).

이 프로젝트는 [[모의장치]]에서 [[SEN55]]의 **VOC Index 채널로 오프가스를 검출한다** (사용자 확인 2026-09-07). 항목표가 요구하는 별도의 오프가스 센서를 두지 않고, 온도·습도·먼지와 같은 모듈에서 나오는 지표 하나가 그 자리를 맡는다.

여기에 아직 규칙이 없다. 논문의 판정 논리는 오프가스 알람의 ○/✕를 요구하는데 ([[배터리 화재감지 5단계]]), [[VOC Index]]는 알람이 아니라 알고리즘이 최근 12시간 이력에서 학습한 기준선 위의 1–500 상대 숫자다 ([[Sensirion SEN5x Datasheet]]). 무엇을 벤팅 검출로 볼지 — 절대 임계값인지 기준선 대비 상승률인지 — 가 정해져야 3단계 판정이 성립한다.

시간 여유도 넉넉하지 않다. 벤팅에서 [[열폭주]]까지가 2분 24초인데, VOC 채널의 응답시간은 에탄올 5→10 ppm을 1초 샘플링으로 볼 때 63% 도달 <10초, 90% 도달 <30초다 ([[Sensirion SEN5x Datasheet]]). 데이터시트의 응답시간은 에탄올 기준이고, 전해질 증기나 실제 벤팅 가스에 대한 감도와 응답은 데이터시트에 없다.
