SunoopDogg/airo-tips/wiki/topics/열폭주.md

---
title: 열폭주
type: topic
tags: [현상, 배터리안전, 화재]
created: 2026-09-04
updated: 2026-09-08
status: developing
sources: ["[[EnerX-0.5P Battery Container Operating Instruction and Maintenance Manual]]", "[[ESS 화재감지 알고리즘 (2023 추계학술발표논문집)]]"]
---

리튬이온배터리가 벤팅 이후 온도가 급격히 치솟으며 화재로 이어지고, 인접 배터리로 열적 스트레스를 전파하는 현상. 이 프로젝트 전체가 이것을 **열폭주 이전에** 잡아내는 일이다.

## 왜 조기감지여야 하는가

일반 화재는 적절한 소화장비로 가연물이 전소하기 전에 진압할 수 있지만, 리튬이온배터리 화재는 열폭주로 급속히 확산되고 인접 배터리로 전이되어 여러 대의 ESS에서 연쇄적으로 발생할 수 있다 ([[ESS 화재감지 알고리즘 (2023 추계학술발표논문집)]]). 모듈급으로 번지면 일반적인 소화 방식으로는 진압되지 않고, 그 시점에는 가연성 가스가 농축되어 폭발하지 않도록 대응하는 것 외에 할 수 있는 일이 없다 (같은 문헌).

따라서 감지 가치는 **[[벤팅 가스]] 단계**에 몰려 있다. 벤팅은 열폭주 직전 단계이고, 오프가스는 "가장 명확하고 직접적인 이상징후"로 평가된다 (같은 문헌).

## 확보 가능한 시간

논문의 화재단계 모의시험에서 벤팅 알람(13:54)부터 열폭주 알람(16:18)까지 **2분 24초**였다 ([[ESS 화재감지 알고리즘 (2023 추계학술발표논문집)]]). 같은 논문의 다른 시험(원통형 셀 외부가열)에서는 28분 09초 벤팅 → 약 30분 열폭주로 **약 2분**이었다. 두 시험 모두 벤팅과 열폭주 사이가 2분 안팎이다.

표6의 마지막 구간(16:18 → 18:38, 2분 20초)은 차동식 열감지기에 인위적 열자극을 준 결과이므로 (같은 문헌), 모듈·랙으로 번지는 4→5단계 전이시간으로 인용할 수 없다.

이 2분이 [[배터리 화재감지 5단계]]가 3단계(벤팅)와 4단계(열폭주)를 나누는 실질적 이유이고, [[정량적 성과지표]] 지표 5의 전송 지연 0.3초가 그 안에서 의미를 갖는 이유다.

## 열폭주 시 각 신호의 거동

논문의 실측 ([[ESS 화재감지 알고리즘 (2023 추계학술발표논문집)]], 원통형 셀 / SOC 100% / 분당 5~7℃ 외부가열):

| 신호 | 벤팅 시 | 열폭주 시 |
|---|---|---|
| 온도 | 순간 소폭 하락 후 재상승 | 급격히 치솟음 |
| 전압 | 2차 감소 (벤팅 이전에 보호회로 동작으로 1차 감소) | 강하 (원통형·각형). 파우치형은 규칙적 변동 없음 |
| 오프가스 / VOC | 센서 트리거, VOC 값 변화 | VOC 값 크게 치솟음 |
| 산소 | 변화 없음 | 소폭 하락 후 천천히 회복 (주변 산소 소모) |
| 먼지 | 변화 없음 | 포화 상태까지 상승 |
| 압력 · LEL | 변화 없음 | 변화 없음 (개방형 챔버 탓으로 추측) |

온도 절댓값은 논문 본문이 아니라 그림 4 눈금에서 읽은 것이다: 벤팅 약 170–180℃, 열폭주 피크 약 550℃, 이후 54분경 약 60℃까지 하강 ([[ESS 화재감지 알고리즘 (2023 추계학술발표논문집)]]). 셀 표면 온도인지 내부 온도인지는 논문이 밝히지 않는다.

**벤팅을 잡아내는 채널은 온도·전압·오프가스 셋뿐**이고, 간접 징후 넷은 벤팅 시점에 전부 침묵했다. 조기감지가 오프가스에 걸려 있다는 결론이 여기서 나온다.

## 상용 ESS의 대응 절차

CATL [[EnerX-0.5P]]의 소화시스템은 경보 → 배기환기(폭연 방지) → 에어로졸(초기 화재 진압, 옵션) → 살수(확산 억제, 옵션)의 4단계로 대응하고, 가스(H2·CO) 경보 시 환기와 PCS 차단이, 열+연기 조합 경보 시 다시 PCS 차단이 걸린다 ([[EnerX-0.5P Battery Container Operating Instruction and Maintenance Manual]]). 논문이 말한 벤팅 단계의 전력 차단, 열폭주 단계의 냉각·소화, ESS 화재 단계의 폭발 방지가 상용 제품에서는 이런 순서로 구현된다. BMS 쪽에서는 셀 과온·온도차 같은 이상을 CAT 1~7 등급으로 나눠 CAT 4부터 고장 랙을, CAT 6부터 전 랙을 차단한다 (같은 문헌).

## 이 프로젝트와의 차이

논문 시료는 **원통형 셀**이다 ([[ESS 화재감지 알고리즘 (2023 추계학술발표논문집)]]). 열폭주 시 전압 강하는 원통형·각형이 공유하고 파우치형에는 없으며, 벤팅 이전의 1차 전압 감소는 원통형 셀 내부 보호회로에서 온 것으로 논문이 추측하는 관측이다. **다른 셀 형태로 옮길 때 어디까지 이전되는지는 대상 셀의 형태가 정해져야 판단할 수 있다.**

시험 조건과 재현 방법은 [[모의장치]] 쪽 문제다.
