SunoopDogg/airo-tips/wiki/sources/ESS 화재감지 알고리즘 (2023 추계학술발표논문집).md

---
title: ESS 화재감지 알고리즘 (2023 추계학술발표논문집)
type: source
tags: [paper, 화재감지, 오프가스, kpi]
created: 2026-09-04
updated: 2026-09-07
status: stable
sources: []
source_path: raw/papers/2023-최형석-ESS 화재감지 알고리즘 (지표3 근거문헌, 한국산학기술학회 추계학술발표논문집).pdf
ingested: 2026-09-04
---

최형석 외, 「리튬이온배터리의 화재발생메커니즘을 고려한 ESS 화재감지 알고리즘에 관한 연구」, 2023년 한국산학기술학회 추계학술발표논문집 pp. 67-70. 리튬이온배터리 ESS의 화재를 다섯 단계로 나누어 판정하는 알고리즘을 제안하고, 모의 화재시험장치로 검증한 4쪽 논문이다.

## 원문이 무엇인가

저자는 최형석·황소연·김남현·김현재·노대석, 소속은 한국기술교육대학교·(주)티팩토리· [[한국산업기술시험원]]이다. 산업통상자원부·한국에너지기술평가원(KETEP) 지원 과제 (No.20214910100010, No.20215910100030). 같은 연구가 「한국산학기술학회 논문지 25(2), 538-547, 2024」에 저자 6인(김지명 추가)으로도 실려 있고, 이 페이지가 다루는 것은 그 게재본이 아니라 2023년 추계 학술발표 판본이다.

## 화재 발생 메커니즘 (2장)

리튬이온배터리 ESS의 화재를 다섯 단계로 구분한다.

1. **정상 동작** — 배터리를 포함한 ESS 구성장치가 고장 없이 동작.
2. **비(非)배터리 화재 발생** — 배터리 개입 없이 발생하는 화재. 과부하로 인한 케이블·부스바 화재, 장치 결함이나 과열 등. 이 단계에서 진압하지 못하면 배터리에 열적 스트레스를 가한다.
3. **단(單)배터리 벤팅** — 단배터리가 열적·전기적·물리적 요인으로 지속 스트레스를 받아 벤팅이 발생. 시스템 긴급정지(emergency stop)나 메인 전력 차단 같은 대응을 하지 않으면 다음 단계로 넘어간다. [[벤팅 가스]] 참조.
4. **단배터리 열폭주** — 벤팅 이후 [[열폭주]]가 발생. 인접 배터리로 열적 스트레스를 전파해 연쇄 열폭주를 일으키므로 조기 감지 후 냉각·소화를 시도해야 한다.
5. **ESS 화재 발생** — 단배터리 화재가 인접 배터리에 열충격을 주어 모듈·랙 단위로 확산. 모듈급이 되면 일반적인 소화 방식으로는 진압할 수 없고, 가연성 가스가 농축되어 폭발하지 않도록 대응하는 것이 가장 중요해진다.

## 화재 이상징후 (3.1)

열폭주 이전의 이상징후를 직접·간접으로 나눈다.

**직접 징후 (표1)**

| 항목 | 특성 |
|---|---|
| 온도 | 벤팅 및 열폭주 발생 시 내부 온도가 상승 |
| 전압 | 원통형·각형은 열폭주가 진행되며 전압이 강하. **파우치형은 규칙적인 전압 변동이 없음** |
| 오프가스 | **가장 명확하고 직접적인 이상징후.** 열폭주 이전 벤팅 단계에서 발생 |

**간접 징후 (표2)**

| 항목 | 특성 |
|---|---|
| 산소 | 열폭주 시 산소를 차단해도 내부 발생 산소로 화재가 지속됨 |
| 압력 | 벤팅·열폭주 시 배터리와 주변의 압력 변화. 중요한 간접 요인으로 평가 |
| 먼지 | 벤팅·열폭주 시 먼지와 유사한 입자 크기의 부산물이 발생할 수 있음 |
| 가연성 가스 | 벤팅 이후 오프가스와 같은 가연성 가스가 열폭주까지 배출됨 |

## 단계별 감지 방안과 알고리즘 (3.2-3.3)

센서 3종의 알람 조합만으로 단계를 판정하는 불린 진리표다. 임계값 튜닝이 아니라 조합 논리라는 점이 이 알고리즘의 성격을 결정한다.

| 단계 | ESS 상태 | 동작하는 센서 |
|---|---|---|
| 1 | 정상 | 없음 |
| 2 | 비배터리 화재 발생 | 연기감지 |
| 3 | 배터리 벤팅 발생 | 오프가스 검출 |
| 4 | 배터리 열폭주 발생 | 오프가스 검출 + 연기감지 |
| 5 | ESS 화재 발생 | 오프가스 검출 + 연기감지 + 열감지 |

절차는 Step 1~7로 기술된다. 설치 공간의 적절한 위치에 오프가스 검출기·연기감지기·열감지기를 설치하고 (Step 1), PLC에 연결해 센서 동작 상태를 실시간 감시한 뒤(Step 2), 위 표의 조합으로 단계를 판정한다 (Step 3~7).

## 화재감지장치 구현 (4장)

- **화재발생장치부**: 리튬이온배터리 가열장치 + 비배터리 화재용 케이블.
- **감지장치부**: 오프가스 검출센서, 공기흡입형 연기감지기, **차동식** 열감지기. 화재발생장치부 상단에 설치한다. 차동식은 급격한 온도 *상승률*에 알람이 발생하는 방식으로, 특정 온도에서 알람이 나는 정온식과 다르다고 논문이 명시한다.
- **PLC**: 센서 알람 여부를 실시간 파악하고 현재 화재 단계를 아날로그 전압으로 출력·저장.

단계별 출력 전압은 1.0 / 2.0 / 3.0 / 4.0 / 5.0 Vdc다 (표5).

## 시험 조건과 결과 (5장)

논문은 **두 개의 시험**을 수행한다.

### 시험 A — 이상징후 특성분석 (5.1, 5.2)

UL9540A 시험방법을 참고한 조건 (표4):

| 항목 | 조건 |
|---|---|
| 시료 | **국내 원통형** 리튬이온배터리 셀 |
| 충전율 | SOC 100% |
| 스트레스 요인 | 배터리 표면 외부 가열 |
| 온도 파라미터 | 분당 5~7℃ 상승 |

결과: 온도가 지속 상승하다 **28분 09초경 순간적으로 소폭 하락 후 재상승** — 벤팅 발생 현상이다. 이때 오프가스 검출센서 트리거와 VOC 센서 값 변화로 오프가스를 검출했다. 이후 **약 30분경** 온도가 급격히 치솟으며 열폭주가 발생했고, VOC 센서 값도 크게 치솟았다.

온도 절댓값은 본문에 없고 그림 4(온도·전압·오프가스 시계열, 온도축 0–600℃)에서만 읽을 수 있다. 눈금으로 읽은 값이라 ±10℃ 안팎의 오차가 있다: 시작 약 25℃ → 벤팅 시점(28분 09초) 약 170–180℃ → 열폭주 피크 약 550℃(30분 43초 부근, 두 봉우리) → 이후 완만히 식어 54분경 약 60℃. 오프가스 검출기(LT-Sensor)는 벤팅 직후 트리거되어 시험 끝까지 유지되고, VOC 값은 열폭주 피크 직후 최대가 된다.

전압은 벤팅 이전에 순간 감소했는데, 원통형 배터리 내부 보호회로가 고열로 동작한 것으로 논문은 추측한다. 벤팅 시기에 2차 감소가 있어 벤팅 시점에도 전압 변화를 확인할 수 있었다.

간접 징후:

- **산소** — 열폭주 시 소폭 하락 후 천천히 회복. 열폭주 중 주변 공기의 산소를 소모.
- **먼지** — **벤팅 시에는 유의미한 값 변화가 없었고, 열폭주 시 포화 상태까지 상승.**
- **압력·LEL** — **열폭주 이후까지 값 변화가 일어나지 않았다.** 논문은 시험용 챔버가 **개방형 구조**인 탓으로 추측한다.
- 산소·먼지·압력·LEL 네 센서 모두 **벤팅 시에는 특별한 값 변화가 없었다.**

### 시험 B — 화재발생단계 특성분석 (5.3, 표6)

배터리가 개입하지 않은 화재와 단배터리·ESS 화재를 가정한 모의 시험. PLC에 알고리즘을 적용하고 아날로그 전압으로 단계를 출력했다.

| 시간 (mm:ss) | 전압 | 단계 | 이벤트 |
|---|---|---|---|
| 00:00 | 1.0 | 1 | 정상상태 |
| 00:30 | 1.0 | 1 | 케이블 점화 |
| 00:37 | 2.0 | 2 | 비배터리 화재 발생 단계 알람 |
| 01:27 | 1.0 | 1 | 케이블 제거 · 연기감지기 알람 초기화 · 배터리 가열 시작 |
| 13:54 | 3.0 | 3 | 단배터리 벤팅 단계 알람 |
| 16:18 | 4.0 | 4 | 단배터리 열폭주 단계 알람 |
| 18:38 | 5.0 | 5 | ESS 화재 발생 단계 알람 |

표의 간격은 케이블 점화 → 연기 알람 **7초**, 가열 시작(01:27) → 벤팅 알람(13:54) **12분 27초**, 벤팅 → 열폭주 **2분 24초**다. 열폭주 발생 후 연기감지기 알람까지는 10초 이내였다. 마지막 16:18 → 18:38 구간의 2분 20초는 차동식 열감지기에 **인위적 열자극**을 준 결과다.

## 결론과 한계

알고리즘이 각 단계를 모두 구분함을 확인했고, 향후 다양한 화재 시나리오와 단계별 대응방안 설계로 확장하겠다고 맺는다. 참고문헌은 산업통상자원부 ESS 사고원인 조사결과 보도자료(2019.06), 장홍제 외 표준인증안전학회지(2019.09), Nexceris "Off-gas detection for Lithium-ion Battery System" (NFPA 855 위원회 데이터팩, 2018), UL9540A Third Edition(2018) 넷이다.
