SunoopDogg/airo-tips/wiki/sources/개발용역 계약서.md

---
title: 개발용역 계약서
type: source
tags: [contract, 용역범위, 검수기준]
created: 2026-09-04
updated: 2026-09-07
status: stable
sources: []
source_path: raw/contracts/개발용역 계약서_이스트오토-에어로랩.pdf
ingested: 2026-09-04
---

[[이스트오토]](갑)와 [[에어로랩]](을)이 "AI 영상관제 기반 ESS 전력공급 차량 소프트웨어 개발 시스템" 개발을 두고 맺은 개발 용역 계약서. 본문 11개 조와 정량적 성과지표 별첨으로 이루어진 5쪽 문서다.

## 원문 상태 — 미완성 초안

서명 전 판본이다. 다음이 전부 공란이거나 자리표시자로 남아 있다.

- 계약기간(제2조 2항) — 시작일·종료일 모두 공란
- 1차·2차 대금의 지급 기한과 비율(제3조 2·3항) — 날짜와 퍼센트가 `??`로 남아 있음
- 체결일(제4쪽)
- 갑의 주소·사업자등록번호·대표이사 서명란

을 측 정보만 채워져 있다.

## 무엇을 개발하는가 (제2조 1항)

용역범위는 시스템 개발과 개발 관련 문서(설계서, 소스 설명서 등) 작성, 개발 완료 후 교육 및 인수인계다. 주요 업무 내용 다섯 가지:

1. 불꽃/연기 검출 AI 개발 — SIFT·스케일 알고리즘 기반, 인식속도 0.8초 이내, 정확도 99% 이상. [[불꽃검출 알고리즘]] 참조.
2. 배터리 화재감지 5단계 알고리즘 개발 — 다습환경 → 먼지환경 → 정상상태 → 벤팅(오프가스) → 고온환경. [[배터리 화재감지 5단계]] 참조.
3. ESS-BMS 연동 데이터 수집 시스템 개발 — SOC·SOH·전압·전류·충방전시간·온도·순간방전전류 7종. [[ESS-BMS 연동 데이터]] 참조.
4. 실시간 이상징후 데이터 전송 시스템(0.3초 이하) 및 AI 영상기반 ESS 관제 시스템 개발.
5. 시스템 설치 및 교육.

여기에 두 개의 경계 조항이 붙는다. 필요한 하드웨어(장비·기자재)의 구매·제작은 갑이 진행하고 (6항), 인증 비용은 용역에 포함되지 않으며 을은 기술지원만, 경비는 갑이 일체 제공한다(7항). 개발물의 상세 규격은 이 계약서가 아니라 양측이 협의한 별도 문서에서 정한다.

## 검수 기준 (별첨)

"본 계약의 개발 완료 검수 기준은 다음 성과지표를 모두 달성함을 확인하는 것으로 한다."

| # | 평가항목 | 단위 | 비중 | 목표치 |
|---|---|---|---|---|
| 1 | 불꽃 구분 소요시간 (인식속도) | SEC | 10% | 0.8 이하 |
| 2 | 불꽃 구분 정확도 (인식성능) | % | 20% | 99% 이상 |
| 3 | 배터리 화재감지 단계 분류 | 단계 | 20% | 5단계 |
| 4 | ESS-BMS 연동 기반 데이터 종류 | 개 | 20% | 7개 |
| 5 | ESS 이상징후 데이터 전송 지속시간 | SEC | 20% | 0.3 이하 |

비중 합계가 90%다. 상세 판본은 [[정량적 성과지표 항목표]]이고, 지표별 내용은 [[정량적 성과지표]] 참조.

## 나머지 조항

- **납품(제2조 3항)**: 검수 완료된 최종 버전을 갑이 지정한 장소에 설치해 정상 운용을 확인하고, 소스와 문서를 갑이 정한 소스관리 저장소에 적재했음을 쌍방이 확인한다.
- **대금(제2조 4항, 제3조)**: 계약금액과 2회 분할 지급 방식이 명시되어 있다. 금액과 비율은 여기에 옮기지 않는다 — 원문 참조.
- **위약(제4조)**: 을 사정으로 개발 불가 시 전액 환불, 갑 사정으로 중단 시 진행분 일할 청구, 일방의 무단 파기 시 배상. 배상 비율은 원문 참조.
- **하자보수(제5조)**: 인도일로부터 1년 무상. 갑의 사용상 부주의, 임의 변경, 천재지변은 면책.
- **업무 위임(제7조)**: 갑의 동의 없이 제3자 위임·도급 불가.
- **지식재산권(제8조)**: 하드웨어·소프트웨어 포함 모든 산출물의 저작권이 갑에게 귀속. 협의로 귀속 주체와 지분을 달리 정할 수 있다.
- **분쟁해결(제10조)**: 관할 법원은 민사소송법에 따른다.
