SunoopDogg/airo-tips/wiki/sources/정량적 성과지표 항목표.md

---
title: 정량적 성과지표 항목표
type: source
tags: [kpi, 검수기준, 평가방법]
created: 2026-09-04
updated: 2026-09-07
status: stable
sources: []
source_path: raw/business-plans/이스트오토_정량적항목_최종.xlsx
ingested: 2026-09-04
---

[[정량적 성과지표]] 다섯 항목의 상세 판본. [[개발용역 계약서]] 별첨이 항목·단위·비중·목표치 네 열로 축약한 것을, 목표 설정 근거와 국내외 벤치마크, 항목별 평가 방법과 평가 환경까지 붙여 놓은 스프레드시트다.

## 원문 상태

시트 한 장(`Sheet1`)에 두 개의 표가 좌우로 나란히 놓여 있다. 왼쪽은 순번·평가항목·단위·비중·세계 최고수준·국내 성능수준·목표설정근거·연구개발목표치, 오른쪽은 순번·평가항목·평가방법·평가환경이다.

**6행이 비어 있다.** 순번 6과 비중 0.1만 있고 평가항목·단위·목표치·평가방법이 모두 없다. 1~5행의 비중 합이 0.9이므로 이 10%를 합쳐야 100%가 된다. 이 파일만으로는 미배정인지 삭제 잔재인지 알 수 없다.

4행 "평가환경" 셀 오른쪽에는 `--> 20회`라는 수정 메모가 본문과 분리된 채 붙어 있다. 본문은 10회다.

## 지표별 내용

### 1·2. 불꽃 구분 소요시간 / 정확도

목표 0.8초 이하(비중 10%), 99% 이상(비중 20%). 세계 최고 1sec / 98%(미국, Torch Sensors), 국내 2sec / 95%(대한민국, 한화테크윈). 근거는 "불꽃 발생 시 인식 후 알림할 수 있는 속도/정확도를 통해 화재 사전 진압 가능성 평가"이며, 두 항목 모두 "시스템 개발 예산의 크기와 요구사항에 따라 기능의 편차가 발생하여 일률적인 성능지표를 적용하기 어려움"이라는 단서가 붙어 있다.

평가는 공인인증기관. 시험 이미지 데이터셋(True : False = 50 : 50)과 실제 영상 이미지로 학습해 최적화한 검출 모델을 비교한다. 소요시간은 연속 입력 이미지 100장의 구분 시간 평균, 정확도는 데이터베이스 저장 후 학습된 모델에 시험 데이터를 투입해 인식률을 계산한다. [[불꽃검출 알고리즘]] 참조.

### 3. 배터리 화재감지 단계 분류

목표 5단계(비중 20%). 세계 최고 5단계(미국, Underwriters Laboratories), 국내 5단계(대한민국, 한국산업기술시험원). "외부적 영향"으로 분류되어 있다.

평가는 공인인증기관. 시험용 ESS 운용환경 [[모의장치]]에 온도·습도·먼지·오프가스 센서를 설치하고 화재 위험 진단 알고리즘을 적용한 뒤, ① 가습기 분무로 다습환경, ② 청소기 먼지 배출구로 먼지환경, ③ 송풍기 바람으로 정상상태, ④ DEC 전해질 시료 분사로 벤팅 모의, ⑤ 열풍기 바람으로 고온환경을 구성해 알고리즘의 반응을 평가한다. [[배터리 화재감지 5단계]] 참조.

근거 문헌으로 최형석·황소연·김남현·김현재·김지명·노대석(2024), 「리튬이온배터리의 화재발생메커니즘을 고려한 ESS 화재감지 알고리즘에 관한 연구」, 한국산학기술학회 논문지 25(2), 538-547을 인용한다. [[ESS 화재감지 알고리즘 (2023 추계학술발표논문집)]] 참조.

### 4. ESS-BMS 연동 기반 데이터 종류

목표 7개(비중 20%). 세계 최고 10개 이상(미국, Tesla), 국내 8개 이상(대한민국, LG). 다섯 지표 중 유일하게 목표가 국내 수준보다 낮다. "내부적 요인"으로 분류되어 있다.

평가는 공인인증기관. 각 항목별 데이터 신호 7개를 10회(메모상 20회) 반복 발생시켜 전송 로그를 기록하고, SOC·SOH·전압·전류·충방전시간·온도·순간 방전전류가 정상 수신되는지 확인한다. [[ESS-BMS 연동 데이터]] 참조.

### 5. ESS 이상 징후 데이터 전송 지속시간

목표 0.3초 이하(비중 20%). 세계 최고 0.20 sec(미국, Tesla), 국내 0.65 sec(대한민국, 한국전력공사). 근거는 이상 징후(온도 상승, 과전류, 과전압, 충·방전 이상 등) 발생 시 센서·BMS의 전압·전류·온도· SOC·SOH 등 주요 상태 데이터와 촬영 이미지를 실시간 전송한다는 것이다.

평가는 공인인증기관. 열폭주 모의·과전류 발생·고온 환경 세 이상 상황을 각각 10회 인위적으로 발생시키고, BMS 센서가 이상 신호를 검출한 시점부터 관제 시스템이 데이터를 수신하는 시점까지의 지연시간(latency)을 반복 측정해 평균을 낸다. [[열폭주]] 모의 조건과 맞물린다.
