SunoopDogg/airo-tips/wiki/topics/VOC Index.md

---
title: VOC Index
type: topic
tags: [지표, 가스센서, 오프가스, 알고리즘]
created: 2026-09-07
updated: 2026-09-07
status: developing
sources: ["[[Sensirion SEN5x Datasheet]]", "[[ESS 화재감지 알고리즘 (2023 추계학술발표논문집)]]"]
---

센시리온 가스센서가 출력하는 1–500 범위의 지표. 휘발성유기화합물 농도를 절대값으로 주는 것이 아니라, 알고리즘이 최근 이력에서 학습한 기준선에 대한 **상대적 편차**를 숫자로 준다. [[SEN55]]가 [[벤팅 가스]]를 검출하는 채널이며 (사용자 확인 2026-09-07), 이 지표의 성격이 지표 3 알고리즘 설계를 직접 제약한다.

## 무엇을 재는 값인가

[[Sensirion SEN5x Datasheet]]의 VOC 알고리즘 튜닝 파라미터가 이 지표의 성격을 드러낸다.

| 파라미터 | 기본값 | 데이터시트의 설명 |
|---|---|---|
| Index Offset | 100 | **평상시(전형적·평균) 조건을 나타내는 VOC 인덱스 값.** 허용 범위 1..250 |
| Learning Time Offset Hours | 12시간 | 이력으로부터 알고리즘 오프셋을 추정하는 시정수. **과거 이벤트는 학습시간의 약 2배가 지나면 잊힌다** |
| Learning Time Gain Hours | 12시간 | 이력으로부터 알고리즘 게인을 추정하는 시정수. 망각 규칙은 위와 같다 |
| Gating Max Duration Minutes | 180분 | **VOC 인덱스가 높은 동안 추정기를 얼어붙게 하는(gating) 최대 시간.** 0이면 게이팅 비활성 |
| Std Initial | 50 | 표준편차 초기 추정값. 낮추면 초기 학습기에 이벤트가 강조되지만 소자간 편차가 커진다 |
| Gain Factor | 230 | VOC 인덱스 출력을 증폭·감쇠하는 게인 |

즉 100 근처가 "지금 이 장소의 평상시"이고, 그 평상시가 무엇인지는 지난 12시간에서 알고리즘이 스스로 정한다. 오래 지속되는 냄새는 새로운 평상시가 되어 인덱스가 100으로 돌아온다 — 게이팅은 바로 그 흡수를 최대 180분까지 미뤄 주는 장치다.

Read Measured Values(0x03C4)가 돌려주는 가스 채널 값은 VOC Index와 NOx Index 두 개이고, 명령 목록(Table 12)에 이보다 앞단의 가스 신호를 읽는 명령은 없다 (같은 문헌).

## 사양이 붙어 있는 조건

가스 사양표의 값은 25 °C, 50 %RH, zero air 기준이며 **모든 농도는 시험가스인 에탄올 기준**이다 ([[Sensirion SEN5x Datasheet]]).

- 응답시간 — 에탄올 5 ppm에서 10 ppm으로 바꿀 때 1초 샘플링 기준 63% 도달 <10초, 90% 도달 <30초.
- 소자간 편차 <±15 points 또는 <±15 % m.v.(큰 쪽), 반복도 <±5 points 또는 <±5 %.
- 켠 뒤 이벤트를 신뢰성 있게 검출하기까지 <60초, 위 사양을 만족하기까지 <1시간.
- 데이터시트가 정의하는 "이벤트 검출"의 기준은 **60초짜리 이벤트(에탄올 5000→10000 ppb 또는 NO2 100→300 ppb) 동안의 신호 변화가 같은 시간 동안의 원신호 드리프트보다 3배 크다**는 것이다.

이 값들은 전부 에탄올에 대한 것이고, 데이터시트는 전해질 증기나 배터리 오프가스에 대한 감도를 말하지 않는다.

## 측정을 시작할 때마다 기준선이 리셋된다

기본 동작에서 VOC 알고리즘은 **측정을 시작할 때마다 상태를 초기값으로 되돌린다.** 아주 짧게 멈췄던 경우에도 그렇고, 그래서 VOC Index 출력이 다시 안정되기까지 오래 걸린다. Read/Write VOC Algorithm State(0x6181)로 상태를 백업해 두었다가 측정 모드에 들어가기 전에 복원하면 초기 학습 단계를 건너뛸 수 있다 ([[Sensirion SEN5x Datasheet]]).

[[모의장치]]는 다섯 조건을 차례로 조성하는 시험이므로, 조건 사이에 센서를 껐다 켜는지 계속 켜 두는지에 따라 같은 자극이 다른 인덱스 값을 낸다. 그래서 알고리즘 상태를 저장해 두고 **조건마다 복원해 항상 같은 출발점에서 시작**하기로 했다 (사용자 확인 2026-09-07). 기준선이 같아야 하나의 임계값을 다섯 조건에 그대로 쓸 수 있다. 저장·복원 명령은 PC가 내리고 [[ESP32-S3-WROOM-1]]은 I2C로 중계만 한다 (사용자 확인 2026-09-07).

## 논문의 진리표가 전제한 것과 다르다

[[ESS 화재감지 알고리즘 (2023 추계학술발표논문집)]]의 판정 논리는 오프가스·연기·열 세 알람의 불린 조합이다 ([[배터리 화재감지 5단계]]). 오프가스 칸은 ○ 아니면 ✕, 즉 **트리거형 알람**을 전제한다. 논문은 전용 오프가스 검출센서를 알람 소자로 쓰고, 별도의 VOC 센서 값 변화는 그와 나란한 관측으로 기록했다 (같은 문헌).

VOC Index는 알람이 아니라 적응형 기준선 위의 연속 숫자다. 진리표의 ○/✕는 **임계값으로** 만든다 — 같은 출발점에서 복원한 기준선 위에서 인덱스가 정해 둔 값을 넘으면 ○다 (사용자 확인 2026-09-07). 임계값 자체는 아직 정하지 않았고 나중에 설정한다. 이 값이 지표 3 알고리즘의 3·4·5단계 판정 전부를 지탱한다.

논문 실측에서 VOC 신호는 벤팅 시점에 값 변화를 보였고 열폭주 시점에 크게 치솟았다 ([[ESS 화재감지 알고리즘 (2023 추계학술발표논문집)]]). 다만 그 VOC 센서가 SEN55와 같은 방식으로 인덱스를 내는 소자였는지는 논문에 없다.
