SunoopDogg/airo-tips/wiki/topics/불꽃검출 알고리즘.md

---
title: 불꽃검출 알고리즘
type: topic
tags: [ai, 영상검출, kpi]
created: 2026-09-04
updated: 2026-09-07
status: developing
sources: ["[[개발용역 계약서]]", "[[정량적 성과지표 항목표]]", "[[ESS 화재감지 알고리즘 (2023 추계학술발표논문집)]]"]
---

영상에서 불꽃과 연기를 검출하는 AI 모듈. [[정량적 성과지표]] 다섯 항목 중 두 개(인식속도, 인식 정확도)가 여기에 걸려 있어, 비중으로는 전체의 30%를 차지한다.

## 계약이 정한 것

계약서 용역범위 1항은 "불꽃/연기 검출 AI 개발(SIFT·스케일 알고리즘 기반, 인식속도 0.8초 이내, 정확도 99% 이상)"이다 ([[개발용역 계약서]]). **알고리즘 계열이 SIFT·스케일 기반으로 계약서에 명시**되어 있다는 점이 특이하다 — 구현 방식이 성능 목표와 함께 계약 문언에 들어가 있다.

## 목표치

| 지표 | 목표 | 비중 | 세계 최고 | 국내 |
|---|---|---|---|---|
| 불꽃 구분 소요시간 (인식속도) | 0.8초 이하 | 10% | 1sec (미국 / Torch Sensors) | 2sec (한화테크윈) |
| 불꽃 구분 정확도 (인식성능) | 99% 이상 | 20% | 98% (미국 / Torch Sensors) | 95% (한화테크윈) |

두 지표 모두 항목표가 제시한 세계 최고 수준을 넘겨 잡았다 ([[정량적 성과지표 항목표]]). 근거란은 "불꽃 발생 시 인식 후 알림할 수 있는 속도/정확도를 통해 화재 사전 진압 가능성 평가"로 적혀 있고, 개발 예산과 요구사항에 따라 기능 편차가 커서 일률적 성능지표를 적용하기 어렵다는 단서가 붙어 있다 ([[정량적 성과지표 항목표]]).

## 평가 방법

공인인증기관이 평가한다. 두 항목 모두 시험 이미지 데이터셋(True : False = 50 : 50)과 실제 영상 이미지로 학습해 최적화한 검출 모델을 비교하는 방식이다 ([[정량적 성과지표 항목표]]).

- **소요시간**: 연속 입력되는 이미지 100장에 대해 불꽃 이미지 구분에 걸리는 시간을 측정하고 평균을 낸다. 즉 0.8초는 단건 지연이 아니라 100장 평균이다.
- **정확도**: 데이터베이스에 저장하고 이를 통해 학습된 모델에 시험 데이터를 투입해 이미지 구분 정확도(인식률)를 계산한다.

시험 이미지 데이터셋을 True : False 50 : 50으로 구성해야 하므로, 실제 불꽃 영상 확보가 평가의 전제가 된다.

## 연기 검출이 맡는 자리

이 프로젝트에서 연기와 불꽃은 센서가 아니라 **카메라와 영상 AI가 추론·검출한다.** 나머지 채널 (온도·습도·먼지·오프가스)만 [[모의장치]]에 센서로 구성된다 (사용자 확인 2026-09-04).

그래서 이 모듈은 검수 지표 1·2를 넘어 [[배터리 화재감지 5단계]]의 판정에도 들어간다. 근거 문헌의 알고리즘은 오프가스·연기·열 세 채널의 조합으로 단계를 가르는데 ([[ESS 화재감지 알고리즘 (2023 추계학술발표논문집)]]), 그중 연기 채널을 논문은 공기흡입형 연기감지기로 구현한 자리를 여기서는 영상 AI가 대신한다. 구체적으로 **2단계(비배터리 화재)를 여는 유일한 신호**이고, 4단계(열폭주)와 3단계(벤팅)를 가르는 판별자다.

논문 실측에서 케이블 점화 후 연기감지기 알람까지 7초, 열폭주 발생 후 알람까지 10초 이내였다 (같은 문헌). 지표 1의 0.8초는 영상 AI 단독 인식속도이므로 이 값들과 직접 비교되지 않지만, 단계 판정 전체의 지연은 가장 느린 채널이 정한다.

## 아직 정해지지 않은 것

계약서와 항목표 어디에도 카메라 사양, 프레임레이트, 해상도, 추론 하드웨어가 없다. 개발물의 상세 규격은 별도 협의 문서에서 정하기로 되어 있고 ([[개발용역 계약서]]), 하드웨어 구매·제작은 [[이스트오토]] 몫이다. "연기 검출"은 계약서 용역범위에는 있지만 [[정량적 성과지표]]에는 지표가 없다 — 지표 1·2의 검수 대상은 불꽃뿐이다. 다만 연기는 지표 3의 단계 판정에 쓰이므로 검수와 무관한 기능은 아니다.
