SunoopDogg/airo-tips/wiki/topics/에어로랩.md

---
title: 에어로랩
type: topic
tags: [org, 수급자]
created: 2026-09-04
updated: 2026-09-07
status: developing
sources: ["[[개발용역 계약서]]", "[[정량적 성과지표 항목표]]", "[[ESS 화재감지 알고리즘 (2023 추계학술발표논문집)]]"]
---

에어로랩(주식회사 에어로랩)은 ESS 열폭주 조기감지 시스템 개발 용역의 수급자다.

## 계약상 지위

[[이스트오토]]가 발주한 "AI 영상관제 기반 ESS 전력공급 차량 소프트웨어 개발 시스템" 용역에서 을, 즉 개발 수행 주체다 ([[개발용역 계약서]]). 대표이사는 강민성이다. 소재지와 사업자등록번호는 계약서 서명란에 명시되어 있다 ([[개발용역 계약서]]).

## 수행할 과업

계약서 제2조가 정한 용역 주요 업무는 다섯 가지다 ([[개발용역 계약서]]).

1. 불꽃·연기 검출 AI 개발 — SIFT·스케일 알고리즘 기반. [[불꽃검출 알고리즘]] 참조.
2. 배터리 화재감지 5단계 알고리즘 개발 — 출력 단계는 정상·비배터리화재·벤팅·열폭주·ESS화재이며, 계약서에 나열된 다습·먼지·고온은 시험 조건이다. [[배터리 화재감지 5단계]] 참조.
3. ESS-BMS 연동 데이터 수집 시스템 개발 — 7종. [[ESS-BMS 연동 데이터]] 참조.
4. 실시간 이상징후 데이터 전송 시스템(0.3초 이하) 및 AI 영상기반 ESS 관제 시스템 개발.
5. 시스템 설치 및 교육.

여기에 설계서·소스 설명서 등 개발 관련 문서 작성과, 개발 완료 후 교육·인수인계가 용역범위에 포함된다 ([[개발용역 계약서]]).

## 의무와 경계

- **검수 기준은 [[정량적 성과지표]] 5개 전부 달성**이다 ([[개발용역 계약서]], [[정량적 성과지표 항목표]]).
- 하드웨어(장비·기자재)의 구매와 제작은 에어로랩이 아니라 [[이스트오토]]가 진행한다. 필요하면 양 당사자가 협의한다 ([[개발용역 계약서]]).
- 인증 비용은 용역에 포함되지 않는다. 에어로랩은 인증에 필요한 기술적 지원만 제공하고, 경비는 [[이스트오토]]가 전액 부담한다 ([[개발용역 계약서]]). 다섯 지표 모두 공인인증기관 평가라는 점과 맞물려, 인증 일정·기관 선정의 주도권은 발주사 쪽에 있다.
- [[이스트오토]]의 동의 없이 업무를 제3자에게 위임하거나 도급할 수 없다 ([[개발용역 계약서]]).
- 개발품 인도일로부터 1년간 무상 하자보수 의무를 진다 ([[개발용역 계약서]]).
- 산출물의 저작권은 하드웨어·소프트웨어를 불문하고 [[이스트오토]]에 귀속된다. 협의로 귀속 주체와 지분을 달리 정할 여지만 남아 있다 ([[개발용역 계약서]]).
