SunoopDogg/airo-tips/wiki/topics/이스트오토.md

---
title: 이스트오토
type: topic
tags: [org, 발주사]
created: 2026-09-04
updated: 2026-09-07
status: developing
sources: ["[[개발용역 계약서]]", "[[정량적 성과지표 항목표]]"]
---

이스트오토(주식회사 이스트오토)는 ESS 열폭주 조기감지 시스템 개발 용역의 발주사다.

## 계약상 지위

"AI 영상관제 기반 ESS 전력공급 차량 소프트웨어 개발 시스템"을 [[에어로랩]]에 의뢰한 갑이다 ([[개발용역 계약서]]). 계약서 원문의 갑 서명란(주소·사업자등록번호·대표이사)은 공란으로 남아 있다.

## 발주사가 지는 몫

- 본 용역에 필요한 대부분의 하드웨어(장비 및 기자재) 구매와 제작을 직접 진행한다 ([[개발용역 계약서]]). 시험용 [[모의장치]] 구축의 물리적 부분이 여기에 걸린다.
- 인증에 필요한 경비를 일체 제공한다 ([[개발용역 계약서]]). [[정량적 성과지표]] 다섯 항목이 전부 공인인증기관 평가이므로 실제 검수 비용은 발주사 부담이다.
- 개발품의 상세 규격은 계약서가 아니라 양측이 협의한 별도 문서에서 정한다 ([[개발용역 계약서]]).
- 납품은 이스트오토가 지정한 장소에 설치해 정상 운용을 확인하고, 소스와 문서를 이스트오토가 정한 소스관리 저장소에 적재했음을 쌍방이 확인하는 방식이다 ([[개발용역 계약서]]).
- 모든 산출물의 저작권을 갖는다 ([[개발용역 계약서]]).
