SunoopDogg/airo-tips/wiki/topics/한국산업기술시험원.md

---
title: 한국산업기술시험원
type: topic
tags: [org, 시험기관, 인증]
created: 2026-09-04
updated: 2026-09-07
status: stub
sources: ["[[ESS 화재감지 알고리즘 (2023 추계학술발표논문집)]]", "[[정량적 성과지표 항목표]]"]
---

한국산업기술시험원은 지표 3 국내 성능수준의 출처이자, 근거 문헌 공저자의 소속 기관이다. 이 프로젝트에서는 이 두 자리로 등장한다.

## 이 위키에서의 등장

- [[정량적 성과지표 항목표]]는 지표 3(배터리 화재감지 단계 분류)의 **국내 성능수준 "5단계"의 출처를 대한민국 / 한국산업기술시험원**으로 적는다. 즉 이 프로젝트가 맞춰야 할 국내 기준선을 만든 기관이다.
- [[ESS 화재감지 알고리즘 (2023 추계학술발표논문집)]]의 공저자 김남현·김현재의 소속 기관이다. 다시 말해 국내 5단계 기준선과 그 근거 문헌이 같은 기관에서 나왔다.

## 검수 기관과의 관계

[[정량적 성과지표]] 다섯 항목은 전부 공인인증기관이 평가하고 인증 경비는 [[이스트오토]]가 부담하므로 ([[개발용역 계약서]]), 기관 선정은 발주사 쪽 결정이다.

한국산업기술시험원은 지표 3의 국내 기준선을 만든 기관이지, 이 프로젝트의 검수 기관으로 지정된 바는 없다.
