SunoopDogg/airo-tips/raw/records/_템플릿-회의.md

# YYYY-MM-DD {이스트오토 협의|내부 회의}

참석:

## 논의

## 결정

<!-- 결론만 적지 말고 이유를 같이 적을 것. 나중에 근거로 쓰이는 것은 이유다. -->

## 액션

- [ ] 담당 / 기한

## 지표 영향

<!-- 예) 지표 4: 반복 횟수 10회 -> 20회. 지표 폴더에는 옮겨 적지 않는다. -->
