SunoopDogg/airo-tips/cad/parts.md

# 지표 3 모의장치 구성 부품

정량적 성과지표 지표 3의 검수 시연용 모의장치를 이루는 부품과, 부품마다 만들 CAD 파일을 정리한다. 장치가 무엇이고 왜 이렇게 구성되는지는 `wiki/topics/모의장치.md`가, 파일 배치와 이름 규칙은 `cad/CLAUDE.md`가, 치수의 상태와 근거는 `cad/chamber.md`가 담는다.

장치 밖에서 쓰는 것은 여기 넣지 않는다. 조건을 만드는 가습기·청소기·송풍기·DEC 분사 장비·열풍기, 별도 장비인 카메라, PC, 계측기는 모의장치의 구성 부품이 아니다.

## 형상 출처와 상태

형상 출처는 둘이다. **모델링**은 `src/<이름>.py`로 직접 만들어 `step/<이름>.step`을 낸다. **벤더 STEP**은 제조사나 step.parts가 배포한 STEP을 `step/imported/`에 원본 파일명 그대로 둔다. 경첩·토글 클램프·손잡이·캐스터·글랜드는 step.parts 범용 모델이 결함이거나 없어서 대표 형상을 직접 그렸다. 실제 구매품이 정해지면 그 제조사 STEP으로 바꾼다.

| 상태 | 뜻 |
|---|---|
| 모델링 가능 | 형상을 정할 근거가 갖춰졌다 |
| 치수 미정 | 부품은 정해졌지만 형상을 정할 치수가 `cad/chamber.md`에서 `unknown` 또는 `dependent`다 |
| STEP 미확보 | 벤더 STEP을 쓸 부품인데 아직 받지 않았다 |
| 확보 | 벤더 STEP을 받아 `step/imported/`에 두었다 |

## 챔버 본체

더미 팩 외형과 팩 둘레 여유가 확정되어 내부 유효 치수 1380 × 970 × 660 mm가 나왔다. 패널을 골조 바깥면에 덧대므로 외형은 약 1446 × 1036 × 726 mm다(도어와 캐스터 제외) (`cad/chamber.md`). 도어 판 전체를 아크릴로 하므로 관찰창을 따로 두지 않고, 받침 프레임 없이 캐스터를 바닥 프로파일에 직접 단다 (사용자 결정 2026-10-06).

| 부품 | 수량 | CAD 파일 | 형상 출처 | 상태 | 근거 |
|---|---|---|---|---|---|
| 더미 팩 (배치 기준 형상) | 1 | `src/pack.py` | 모델링 | 모델링 가능 | ESS 배터리 모듈 하나의 외형만 본뜬 더미이고, 1130 × 810 × 260 mm로 눕혀 놓는다 (`wiki/topics/모의장치.md`, 사용자 결정 2026-10-06). 원점 기준 x 100–1230, y 80–890, z 100–360 mm에 놓인다 (`cad/chamber.md`) |
| 팩 받침 레일 | 2줄 | `src/pack_rail.py` | 모델링 | 모델링 가능 | 3030 프로파일로 더미 팩 밑면을 바닥에서 100 mm 띄운다 (`wiki/topics/모의장치.md`, 사용자 결정 2026-10-06). 깊이 방향 810 mm 레일 2줄, 중심 x 200·1130 mm, 줄마다 다리 2개를 레일 양 끝에 단다. 다리는 바닥 보강재 위에 선다 (사용자 결정 2026-10-07) |
| 외함 골조 | 1 | `src/chamber_frame.py` | 모델링 | 모델링 가능 | 밀폐 상태로 시험한다 (`wiki/topics/모의장치.md`, 사용자 확인 2026-09-07). 알루미늄 프로파일 3030 B형 슬롯 8로 짜고, 안쪽 면이 내부 유효 치수 1380 × 970 × 660 mm를 이룬다. 세로재 통짜, 수평재 사이, 안쪽 코너 브래킷 이음이고, 레일 밑 바닥 보강재 2개를 포함한다 (사용자 결정 2026-10-06, 2026-10-07) |
| 외함 패널 | 6장 | `src/chamber_panel.py` | 모델링 | 모델링 가능 | 3 mm 알루미늄 복합판을 바닥을 포함한 여섯 면의 골조 바깥면에 스프링 너트와 M6 볼트로 덧댄다. 앞면에는 도어 개구 1230 × 460 mm, 옆면에는 포트 구멍, 천장에는 글랜드 구멍을 낸다 (`wiki/topics/모의장치.md`, 사용자 결정 2026-10-07) |
| 도어 | 1 | `src/door.py` | 모델링 | 모델링 가능 | 도어로 열고 닫는다 (`wiki/topics/모의장치.md`, 사용자 확인 2026-09-04). 앞면 여닫이 8 mm 아크릴 판이고 관찰창을 겸한다 (사용자 결정 2026-10-06). 개구 둘레에 30 mm씩 겹쳐 1290 × 520 mm다 (사용자 결정 2026-10-07) |
| 도어 밀폐재 | 1 | `src/door_gasket.py` | 모델링 | 모델링 가능 | 앞면 패널의 개구 둘레에 붙이는 EPDM 스펀지 사각 링, 단면 15 × 10 mm (사용자 결정 2026-10-07) |
| 도어 경첩 | 3 | `src/door_hinge.py` | 모델링 | 모델링 가능 | 앞에서 보아 오른쪽 변의 위·가운데·아래에 단다 (사용자 결정 2026-10-06). 50 × 50 맞대기 경첩을 받침 블록과 함께 놓는다 (사용자 결정 2026-10-07). step.parts 모델은 날개 폭이 0.05 mm인 결함이 있어 대표 형상(날개 하나 25 × 50)을 직접 그리고, 날개 두께·너클 지름은 작업 가정이다 (`cad/chamber.md`) |
| 토글 클램프 | 2 | `src/toggle_clamp.py` | 모델링 | 모델링 가능 | 왼쪽 변 위·아래에서 도어를 밀폐재에 눌러 잠근다 (사용자 결정 2026-10-06). 누름형이고, step.parts에 없어 대표 형상을 직접 그린다. 형상 치수는 작업 가정이며 구매품이 정해지면 바꾼다 (사용자 결정 2026-10-07) |
| 도어 손잡이 | 1 | `src/door_handle.py` | 모델링 | 모델링 가능 | 왼쪽 변 가운데에 단다 (사용자 결정 2026-10-06). 장착 구멍 간격 128 mm 당김 손잡이를 세로로 놓는다 (사용자 결정 2026-10-07). step.parts 모델이 결함이라 대표 형상을 직접 그리고, 형상 치수는 작업 가정이다 (`cad/chamber.md`) |
| 캐스터 | 4 | `src/caster.py` | 모델링 | 모델링 가능 | 바닥에 직접 달고, 넷 다 브레이크가 달린 것을 쓴다 (사용자 결정 2026-10-06). 바퀴 지름 100 mm 회전 캐스터 (사용자 결정 2026-10-07). step.parts 모델이 결함이라 대표 형상을 직접 그리고, 형상 치수는 작업 가정이다 (`cad/chamber.md`) |
| 공용 주입 포트 | 1 | `src/inlet_port.py` | 모델링 | 모델링 가능 | 다섯 조건의 자극을 넣는 자리이고 앞에서 보아 오른쪽 옆면에 둔다 (사용자 결정 2026-10-06). 중심 y 485, z 510 mm. 내경 50 mm 관, 플랜지, 끼움형 마개 (사용자 결정 2026-10-07) |
| 배기 포트 | 1 | `src/exhaust_port.py` | 모델링 | 모델링 가능 | 조건 사이 환기에 쓴다 (`wiki/topics/모의장치.md`, 사용자 확인 2026-09-07). 주입 포트와 마주 보는 왼쪽 옆면, 같은 위치·같은 형상이다 (사용자 결정 2026-10-06, 2026-10-07) |
| 케이블 글랜드 | 3 | `src/cable_gland.py` | 모델링 | 모델링 가능 | 밀폐를 유지하며 I2C 배선을 통과시킨다. 자리는 천장, 전장함 바로 아래다 (`wiki/topics/모의장치.md`, 사용자 결정 2026-10-06). M20 글랜드 3개를 간격 30 mm 한 줄로 두고, 몸체는 챔버 안쪽, 잠금 너트는 전장함 바닥 위다 (사용자 결정 2026-10-07). step.parts 범용 모델이 너무 커서 대표 형상을 직접 그리고, 형상 치수는 작업 가정이다 (`cad/chamber.md`) |

## 센서부 — 챔버 내부

| 부품 | 수량 | CAD 파일 | 형상 출처 | 상태 | 근거 |
|---|---|---|---|---|---|
| SEN55 환경센서 노드 (SEN55-SDN-T) | 3 | `step/imported/Sensirion_STEP_SEN5x.STEP` | 벤더 STEP | 확보 | 구매 완료, 챔버 내부에 직접 노출 (`wiki/topics/SEN55.md`, 사용자 확인 2026-09-07). Sensirion SEN55 제품 페이지의 "STEP file SEN5x"(2022-01)를 받았다. SEN5x 계열 공통 모델이고 원점이 외곽 중심이 아니므로 조립품에서 옮겨 쓴다. 데이터시트 외형은 52.3 × 43.3 mm, 두께 최대 22.3 mm다 (`wiki/topics/SEN55.md`). 브래킷 치수는 이 STEP이 아니라 데이터시트 값을 근거로 한다 |
| SEN55 케이블측 커넥터 (ACES 51452-006H0H0-001) | 3 | `step/imported/` | 벤더 STEP | STEP 미확보 | SEN55 6핀 커넥터의 케이블 쪽 짝이며 JST GHR-06V-S 호환이다 (`wiki/sources/Sensirion SEN5x Datasheet.md`). step.parts에 없다. 형상에 영향을 주지 않으므로 조립품에서 빠져도 된다 |
| SEN55 브래킷 | 3 | `src/sen55_bracket.py` | 모델링 | 모델링 가능 | 천장 중심에서 242.5 mm, 120° 간격, 한 대는 앞쪽 (사용자 결정 2026-10-06, 2026-10-07). 천장 패널 안쪽 면에 M4 볼트 2개로 달고 그 면에서 20 mm 띄운다. 모듈은 수평, 평평한 면이 위, 커넥터가 천장 중심 쪽이고 긴 변 클립으로 잡는다. PETG 3D 프린트, 벽 2.5 mm (사용자 결정 2026-10-07) |
| P82B715 센서측 기판 | 3 | `src/extender_board.py` | 모델링 | 모델링 가능 | P82B715 버스 익스텐더를 쓴다 (사용자 결정 2026-10-06). 채널마다 한 쌍 중 SEN55 옆 3개가 챔버 내부에 들어가고, 외부 3개는 전장 기판에 싣는다 (`wiki/topics/P82B715.md`). 30 × 20 × 1.6 mm 판에 M3 구멍 2개, SEN55 브래킷 옆면에 단다 (사용자 결정 2026-10-07) |

## 전장부 — 챔버 상단 외부

| 부품 | 수량 | CAD 파일 | 형상 출처 | 상태 | 근거 |
|---|---|---|---|---|---|
| ESP32-S3-WROOM-1-N16R8 모듈 | 1 | `step/imported/ESP32-S3-WROOM-1.step` | 벤더 STEP | 확보 | 컨트롤러 (`wiki/topics/ESP32-S3-WROOM-1.md`, 사용자 확인 2026-09-07). KiCad 3D 라이브러리의 풋프린트 모델을 step.parts(`esp32_s3_wroom_1`)에서 받았다. N16R8 같은 변형을 구분하지 않는 모델이며 외곽은 18 × 25.5 × 3.1 mm다 |
| 전장 기판 | 1 | `src/control_board.py` | 모델링 | 모델링 가능 | ESP32 모듈과 PCA9548A를 싣는다 (`wiki/topics/PCA9548A.md`, 사용자 확인 2026-09-07). 자체 PCB로 만들고, 외부측 P82B715 3개도 싣는다 (사용자 결정 2026-10-06). 80 × 60 × 1.6 mm, USB-C (사용자 결정 2026-10-07) |
| 전장함 | 1 | `src/electronics_box.py` | 모델링 | 모델링 가능 | 전원과 통신을 USB 하나로 통합하므로 (`wiki/topics/모의장치.md`, 사용자 확인 2026-09-07) USB 케이블이 나갈 구멍을 낸다. 천장 중심에 두는 PETG 3D 프린트 상자, 바깥 94 × 74 × 29 mm (사용자 결정 2026-10-07) |

PCA9548A, 외부측 P82B715, 풀업 저항, 3.3 V 공급 소자, 케이블 커넥터는 전장 기판 위의 소자이고 그리지 않는다 (사용자 결정 2026-10-07).

차폐 케이블을 쓸지는 아직 정해지지 않았다 (`wiki/topics/P82B715.md`, 사용자 확인 2026-09-07). 형상 부품이 아니므로 글랜드의 조임 범위에만 영향을 준다.

## 조립품

`src/assembly.py`가 위의 모델을 모두 불러 조립 위치에 놓고, SEN55 벤더 STEP 3대를 브래킷의 자세 함수로 함께 놓는다. ESP32 벤더 STEP은 전장 기판 모델이 이미 갖고 있다.

`src/assembly_door_open.py`는 같은 조립품을 도어를 90° 연 자세로 `step/assembly_door_open.step`에 쓴다. 토글 클램프는 풀린 자세이고, 그 회전축과 각도는 `src/assembly.py`의 작업 가정이다.

## 가공 도면

판재 부품은 모델의 면을 펼친 가공용 DXF를 `dxf/`에 낸다. 챔버 바깥에서 본 면, 판의 왼쪽 아래가 원점, `CUT` 레이어 하나, kerf 0이고, 철물 장착 구멍은 넣지 않는다 (사용자 결정 2026-10-07). 규칙은 `cad/CLAUDE.md`의 "가공 도면 (DXF)" 절이 정한다.

| 부품 | 도면 스크립트 | DXF | 근거 |
|---|---|---|---|
| 외함 패널 | `src/chamber_panel_dxf.py` | `dxf/panel_front.dxf` · `panel_back.dxf` · `panel_left.dxf` · `panel_right.dxf` · `panel_top.dxf` · `panel_bottom.dxf` | `src/chamber_panel.py`의 패널 6장마다 바깥면 하나. 외곽, 골조 볼트 구멍 Ø6.5, 앞면 도어 개구, 옆면 포트 구멍 Ø56, 천장 글랜드 구멍 Ø20이 들어간다 |
| 도어 | `src/door_dxf.py` | `dxf/door.dxf` | `src/door.py`의 아크릴 판 앞면. 1290 × 520 외곽뿐이고 구멍이 없다 |
| 도어 밀폐재 | `src/door_gasket_dxf.py` | `dxf/door_gasket.dxf` | `src/door_gasket.py`의 사각 링 앞면. 바깥 1275 × 505, 안쪽 1245 × 475, 폭 15. 두께 10은 재료 두께라 도면에 없다 |
| 전장 기판 | `src/control_board_dxf.py` | `dxf/control_board.dxf` | `src/control_board.py`의 `pcb` 개체 윗면(소자면). 80 × 60 외곽과 M3 구멍 Ø3.2 4개. KiCad Edge.Cuts로 가져갈 외곽이다 |
| P82B715 센서측 기판 | `src/extender_board_dxf.py` | `dxf/extender_board.dxf` | `src/extender_board.py`의 `extender_1`에서 브래킷에서 먼 큰 면. 30 × 20 외곽과 M3 구멍 Ø3.2 2개. 3장이 같은 형상이라 도면은 하나다 |

## 치수 도면

가공 도면과 짝을 이루어 사람이 읽는 치수 도면 PDF를 `pdf/`에 낸다. 주 뷰는 같은 판의 DXF와 같은 면·방향·원점이고, 위치 치수는 그 원점(판의 왼쪽 아래)에서 잰다. 일반 공차 ISO 2768-m, 영문 표기, 도면 번호·작성자는 비우고, 도어와 패널에는 철물 장착 구멍이 없다는 노트를 넣는다 (사용자 결정 2026-10-07). 규칙은 `cad/CLAUDE.md`의 "치수 도면 (PDF)" 절이 정한다.

| 부품 | 도면 스크립트 | PDF | 근거 |
|---|---|---|---|
| 외함 패널 | `src/chamber_panel_drawing.py` | `pdf/chamber_panel.pdf` (6쪽) | 패널마다 바깥면 뷰 한 쪽. 앞·뒤·옆은 A3, 천장·바닥은 치수가 A3 틀에 닿아 A2이고 모두 1:5다. 바닥은 DXF와 방향을 맞추려 형상을 180° 돌려 그린다 |
| 도어 | `src/door_drawing.py` | `pdf/door.pdf` | 앞면 뷰 한 쪽, A3 1:5. 외곽 1290 × 520뿐이다 |
| 도어 밀폐재 | `src/door_gasket_drawing.py` | `pdf/door_gasket.pdf` | 도어 쪽 앞면 뷰 한 쪽, A3 1:5. 바깥 1275 × 505, 안쪽 1245 × 475, 들어온 거리 15 |
| 전장 기판 | `src/control_board_drawing.py` | `pdf/control_board.pdf` | `pcb` 개체의 소자면 뷰 한 쪽, A4 1:1. 80 × 60 외곽과 M3 구멍 Ø3.2 4개의 위치 |
| P82B715 센서측 기판 | `src/extender_board_drawing.py` | `pdf/extender_board.pdf` | `extender_1`의 브래킷에서 먼 면 뷰 한 쪽, A4 2:1. 30 × 20 외곽과 M3 구멍 Ø3.2 2개의 위치, 수량 3 노트 |

## 남은 것

- 밀폐 등급(IP)은 정해지지 않았다. 형상은 밀폐재 단면으로 이미 정해졌다.
- 케이블 외경은 정해지지 않았다. M20 글랜드의 조임 범위 안에 들어야 한다.
- 철물·캐스터·글랜드의 실제 구매품을 정하면 그 STEP으로 바꾼다. 그때 도어와 패널 모델에 장착 구멍을 더하고 가공 도면을 다시 낸다.
- SEN55 케이블측 커넥터(ACES 51452-006H0H0-001) STEP은 제조사에서 받아야 한다.
