SunoopDogg/airo-tips/cad/dxf/panel_front.dxf

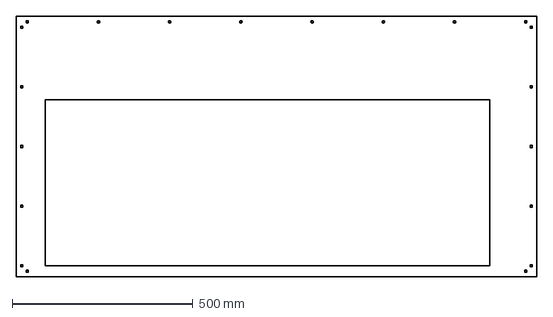
[picture p1: CAD file, 2026-09-27]
cad/dxf/panel_front.dxf
1440.0 x 720.0 mm
