SunoopDogg/airo-tips/cad/step/door.step

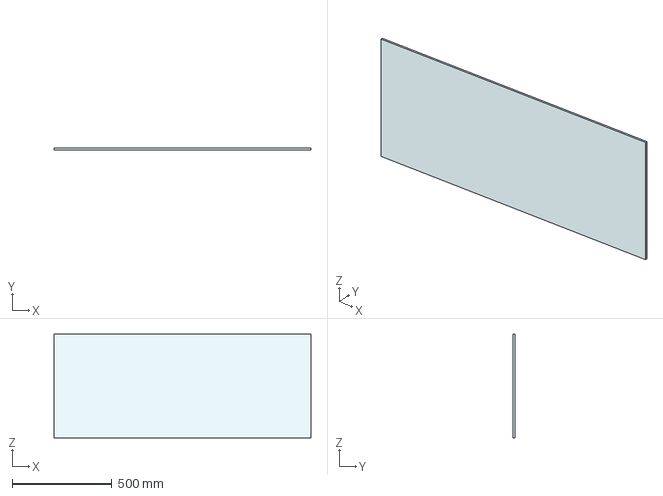
[picture p2: CAD file, 2026-09-24]
cad/step/door.step
1290.0 x 8.00 x 520.0 mm
