SunoopDogg/airo-tips/cad/step/imported/cable_gland_panel_hole_cutter_m20.step

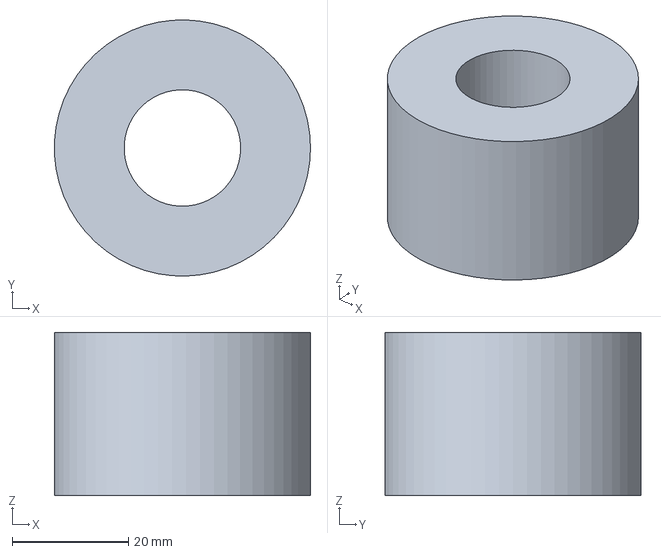
[picture p3: CAD file, 2026-09-20]
cad/step/imported/cable_gland_panel_hole_cutter_m20.step
44.0 x 44.0 x 28.0 mm
