SunoopDogg/airo-tips/cad/dxf/panel_bottom.dxf

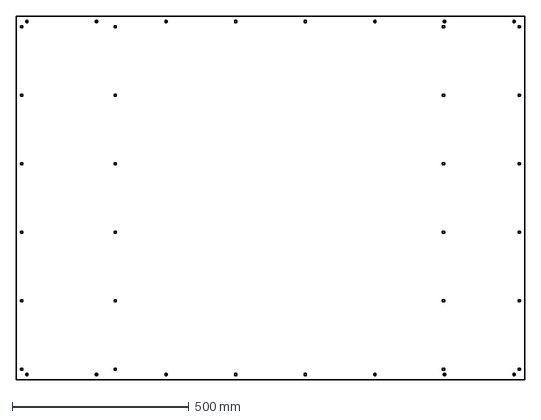
[picture p4: CAD file, 2026-09-27]
cad/dxf/panel_bottom.dxf
1440.0 x 1030.0 mm
