SunoopDogg/airo-tips/cad/step/extender_board.step

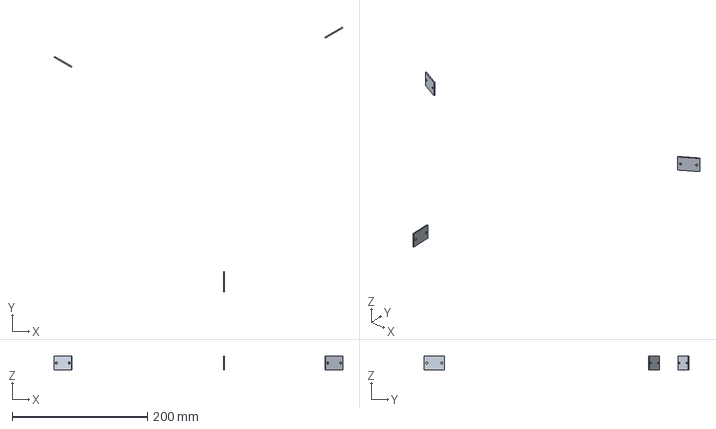
[picture p5: CAD file, 2026-09-24]
cad/step/extender_board.step
427.1 x 391.6 x 20.0 mm
extender_3 x 3
