SunoopDogg/airo-tips/cad/step/imported/corner_bracket_3030_single_simple.step

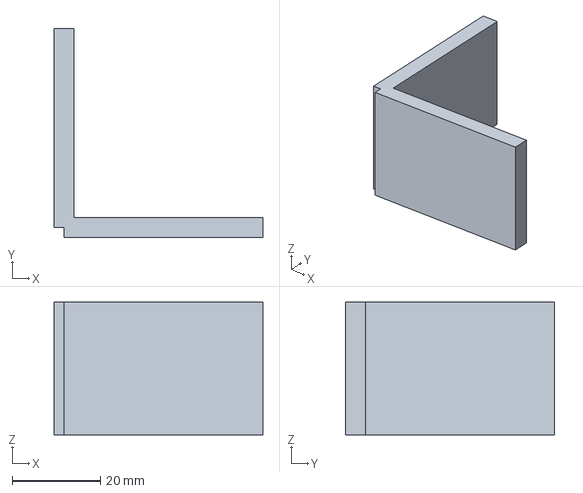
[picture p6: CAD file, 2026-09-20]
cad/step/imported/corner_bracket_3030_single_simple.step
47.2 x 47.2 x 30.0 mm
