SunoopDogg/airo-tips/cad/dxf/panel_top.dxf

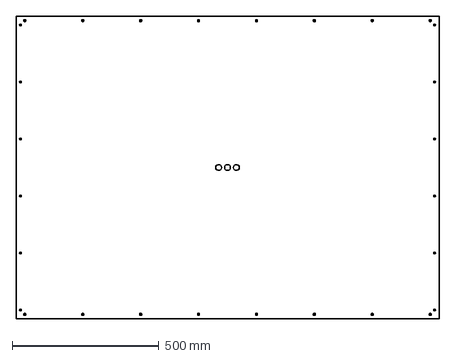
[picture p7: CAD file, 2026-09-27]
cad/dxf/panel_top.dxf
1440.0 x 1030.0 mm
