SunoopDogg/airo-tips/cad/step/caster.step

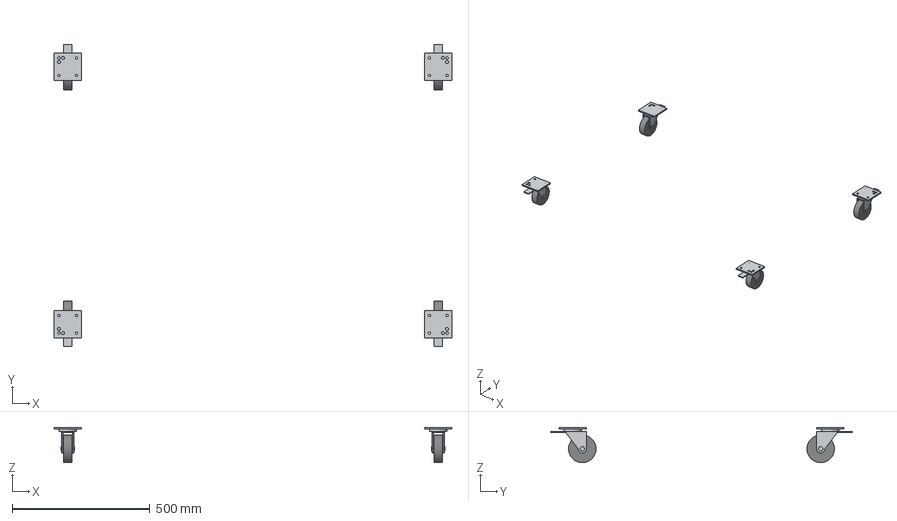
[picture p8: CAD file, 2026-09-24]
cad/step/caster.step
1446.0 x 1096.0 x 127.9 mm
caster_FL_plate
caster_FL_swivel
caster_FL_fork
caster_FL_wheel
caster_BR_brake x 4
caster_FR_plate
caster_FR_swivel
caster_FR_fork
caster_FR_wheel
caster_BL_plate
caster_BL_swivel
caster_BL_fork
caster_BL_wheel
caster_BR_plate
caster_BR_swivel
caster_BR_fork
caster_BR_wheel
