SunoopDogg/airo-tips/cad/step/imported/profile_3030_b_slot8.step

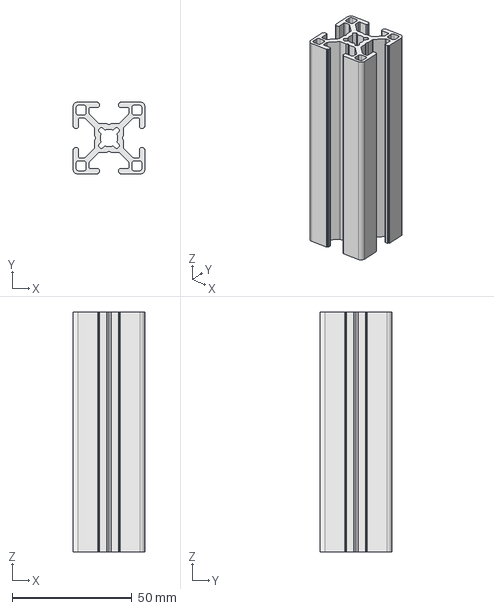
[picture p9: CAD file, 2026-09-20]
cad/step/imported/profile_3030_b_slot8.step
30.0 x 30.0 x 100.0 mm
