SunoopDogg/airo-tips/cad/dxf/panel_back.dxf

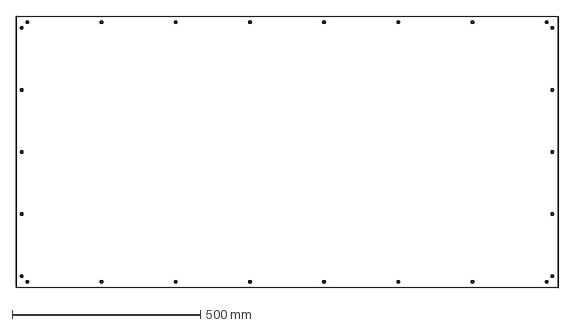
[picture p10: CAD file, 2026-09-27]
cad/dxf/panel_back.dxf
1440.0 x 720.0 mm
