SunoopDogg/airo-tips/cad/step/cable_gland.step

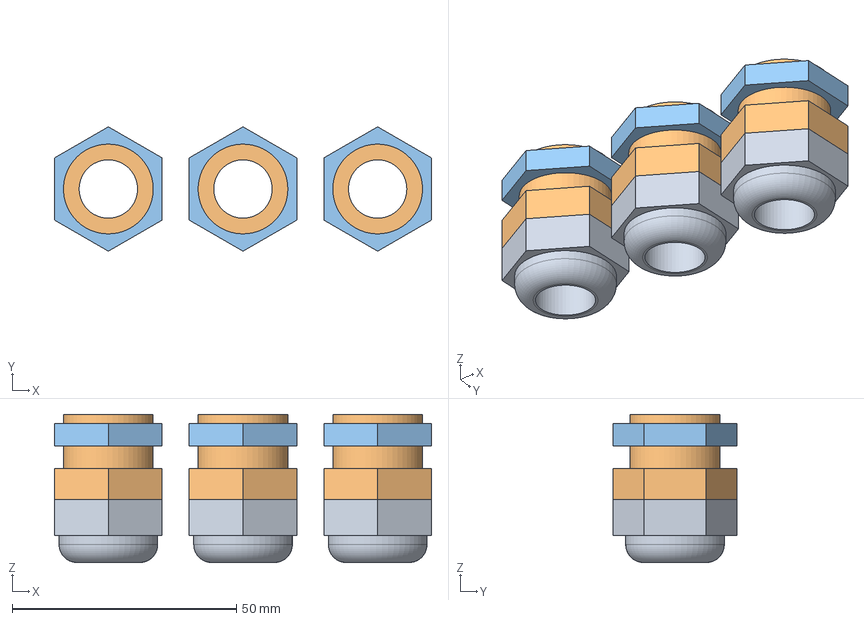
[picture p11: CAD file, 2026-09-24]
cad/step/cable_gland.step
84.0 x 27.7 x 33.0 mm
gland_1_dome
gland_1_body
gland_1_locknut
gland_2_dome
gland_2_body
gland_2_locknut
gland_3_dome
gland_3_body
gland_3_locknut
