SunoopDogg/airo-tips/cad/step/imported/Sensirion_STEP_SEN5x.STEP

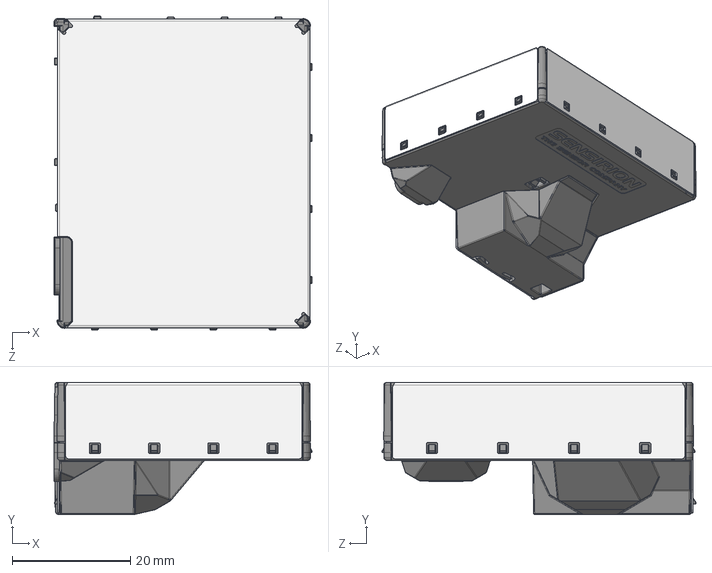
[picture p12: CAD file, 2026-09-19]
cad/step/imported/Sensirion_STEP_SEN5x.STEP
43.6 x 22.3 x 52.9 mm
