SunoopDogg/airo-tips/cad/dxf/panel_left.dxf

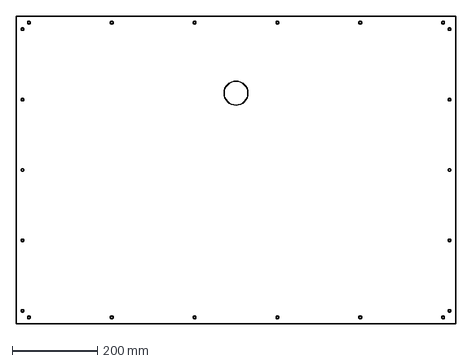
[picture p13: CAD file, 2026-09-27]
cad/dxf/panel_left.dxf
1030.0 x 720.0 mm
