SunoopDogg/airo-tips/cad/step/electronics_box.step

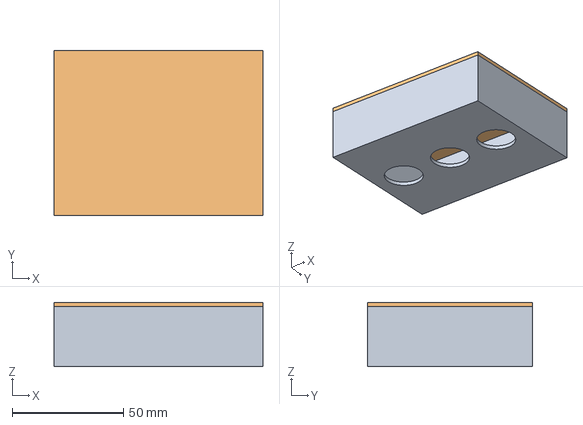
[picture p14: CAD file, 2026-09-24]
cad/step/electronics_box.step
94.0 x 74.0 x 29.0 mm
box_body
box_lid
