SunoopDogg/airo-tips/cad/step/imported/ESP32-S3-WROOM-1.step

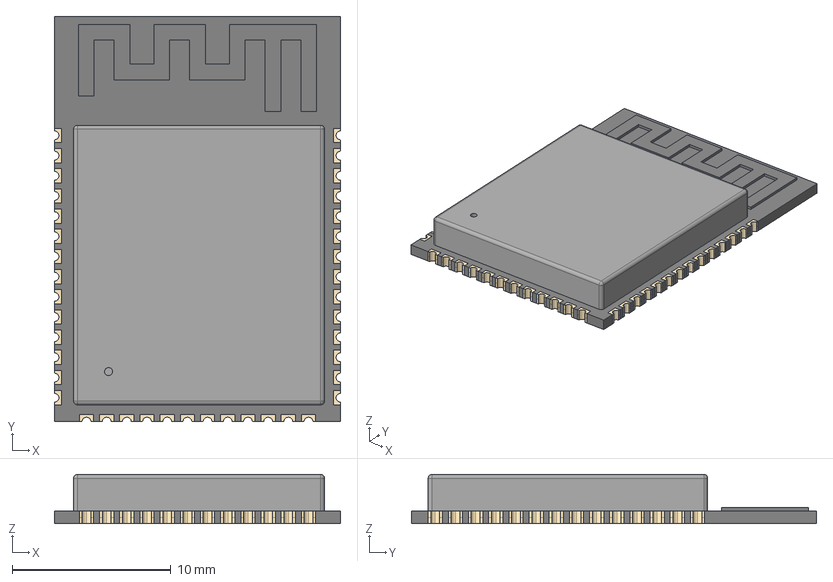
[picture p15: CAD file, 2026-09-18]
cad/step/imported/ESP32-S3-WROOM-1.step
18.0 x 25.5 x 3.10 mm
