SunoopDogg/airo-tips/cad/dxf/panel_right.dxf

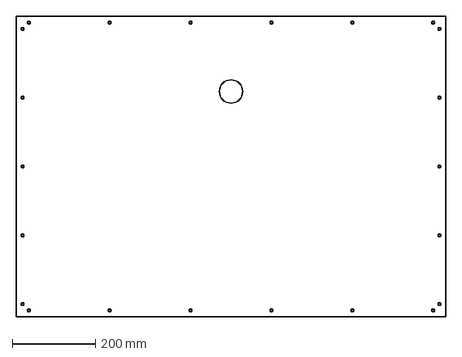
[picture p16: CAD file, 2026-09-27]
cad/dxf/panel_right.dxf
1030.0 x 720.0 mm
