SunoopDogg/airo-tips/cad/step/inlet_port.step

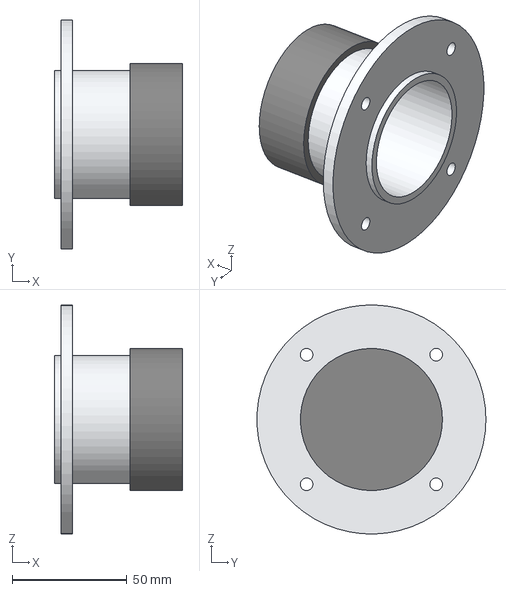
[picture p17: CAD file, 2026-09-24]
cad/step/inlet_port.step
56.0 x 99.9 x 100.0 mm
inlet_pipe
inlet_cap
