SunoopDogg/airo-tips/cad/step/sen55_bracket.step

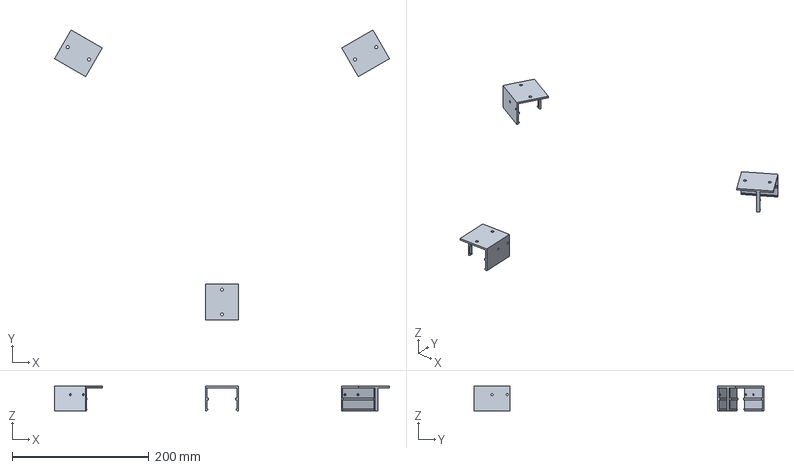
[picture p18: CAD file, 2026-09-24]
cad/step/sen55_bracket.step
489.9 x 424.3 x 36.1 mm
bracket_3 x 3
