SunoopDogg/airo-tips/cad/step/door_gasket.step

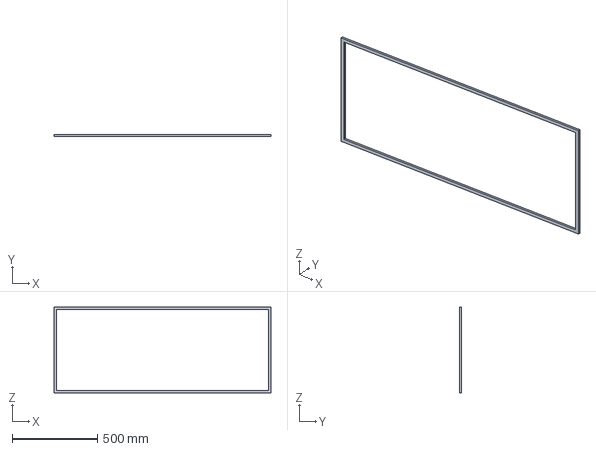
[picture p19: CAD file, 2026-09-24]
cad/step/door_gasket.step
1275.0 x 10.0 x 505.0 mm
