SunoopDogg/airo-tips/cad/step/toggle_clamp.step

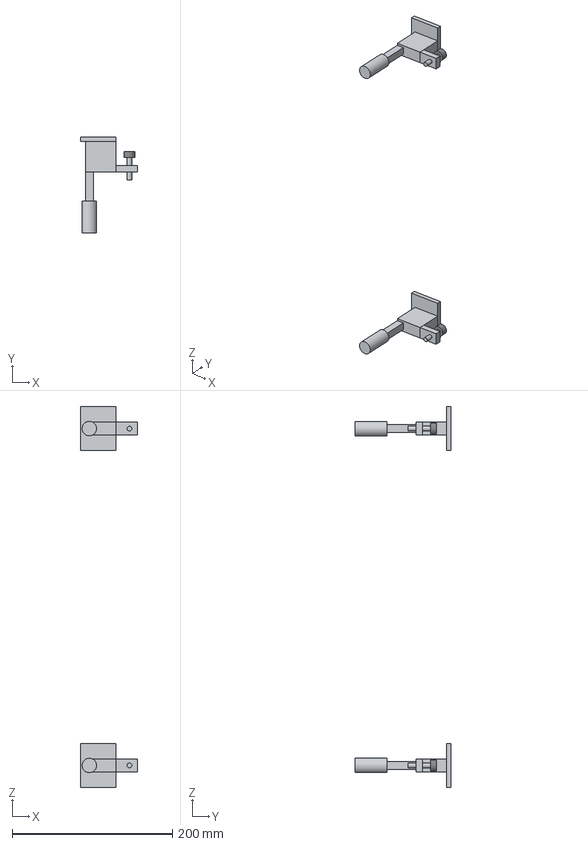
[picture p20: CAD file, 2026-09-24]
cad/step/toggle_clamp.step
71.0 x 120.0 x 475.0 mm
clamp_1_base
clamp_2_body x 2
clamp_1_arm
clamp_1_lever
clamp_1_spindle
clamp_1_pad
clamp_2_base
clamp_2_arm
clamp_2_lever
clamp_2_spindle
clamp_2_pad
