SunoopDogg/airo-tips/cad/step/pack.step

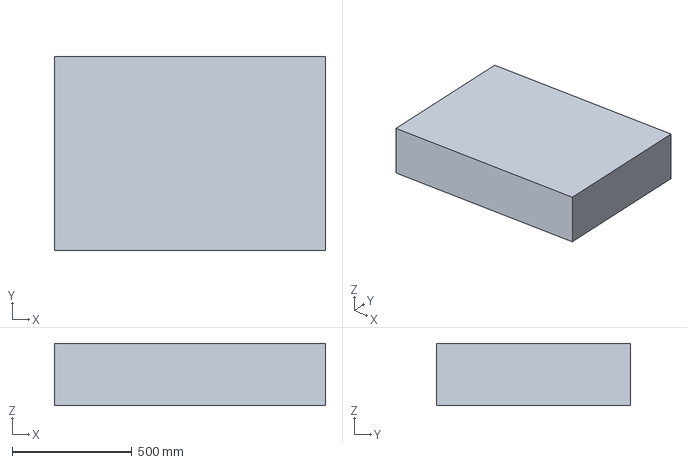
[picture p21: CAD file, 2026-09-24]
cad/step/pack.step
1130.0 x 810.0 x 260.0 mm
