SunoopDogg/airo-tips/cad/step/door_hinge.step

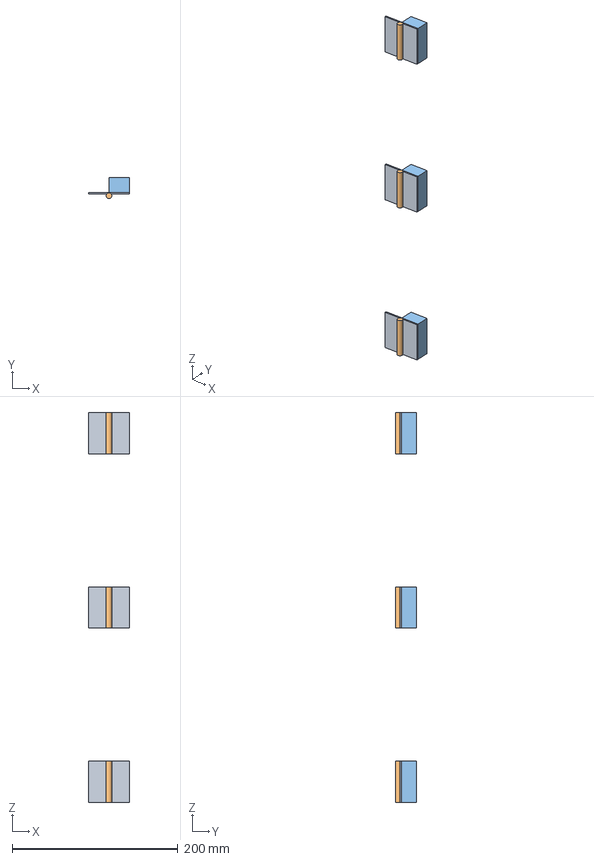
[picture p22: CAD file, 2026-09-24]
cad/step/door_hinge.step
50.0 x 25.5 x 470.0 mm
hinge_1_leaf_door
hinge_1_leaf_frame
hinge_1_knuckle
hinge_2_leaf_door
hinge_2_leaf_frame
hinge_2_knuckle
hinge_3_leaf_door
hinge_3_leaf_frame
hinge_3_knuckle
hinge_spacer_3 x 3
