SunoopDogg/airo-tips/cad/step/door_handle.step

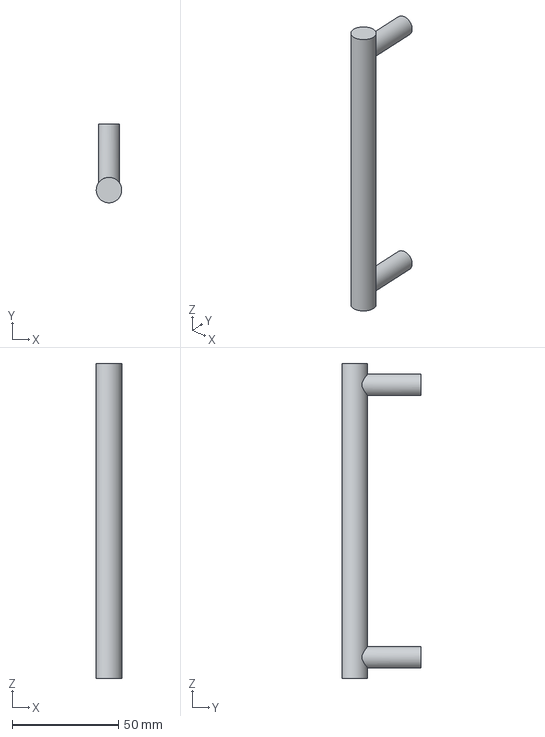
[picture p23: CAD file, 2026-09-24]
cad/step/door_handle.step
12.0 x 37.0 x 148.0 mm
