SunoopDogg/airo-tips/cad/step/control_board.step

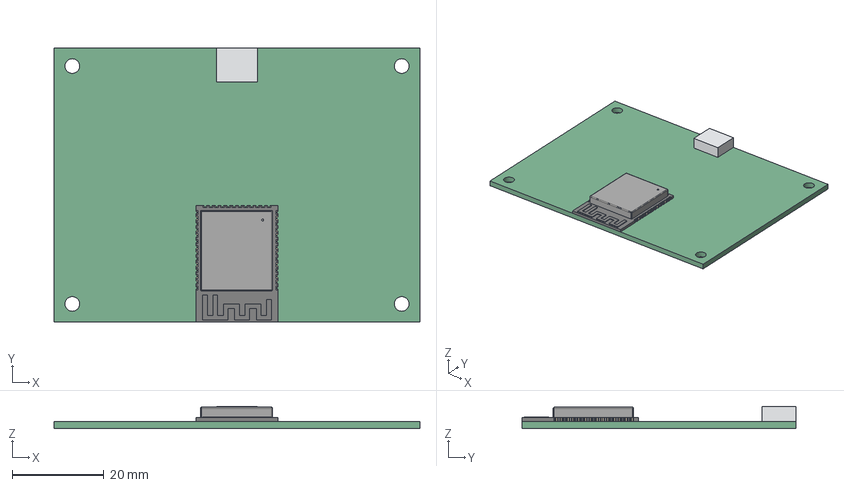
[picture p24: CAD file, 2026-09-24]
cad/step/control_board.step
80.0 x 60.0 x 4.90 mm
pcb
esp32_module
usb_c
