SunoopDogg/airo-tips/cad/step/pack_rail.step

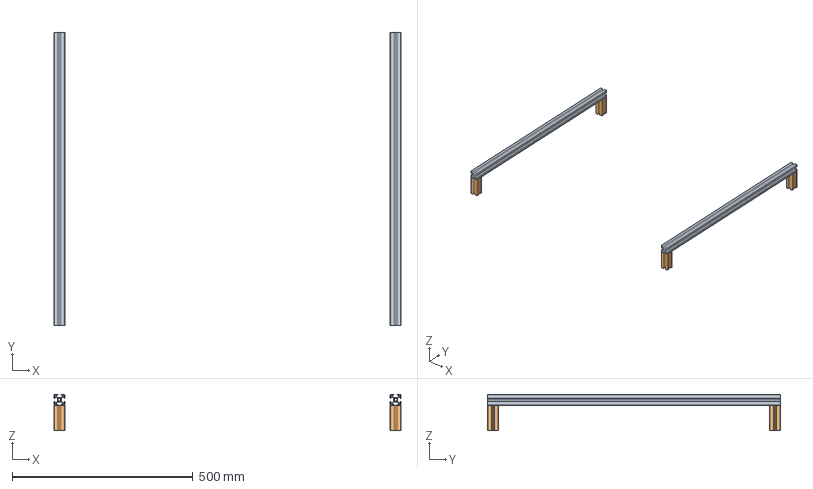
[picture p25: CAD file, 2026-09-24]
cad/step/pack_rail.step
960.0 x 810.0 x 100.0 mm
rail_L
leg_LF
leg_LB
rail_R
leg_RF
leg_RB
