SunoopDogg/airo-tips/cad/step/chamber_frame.step

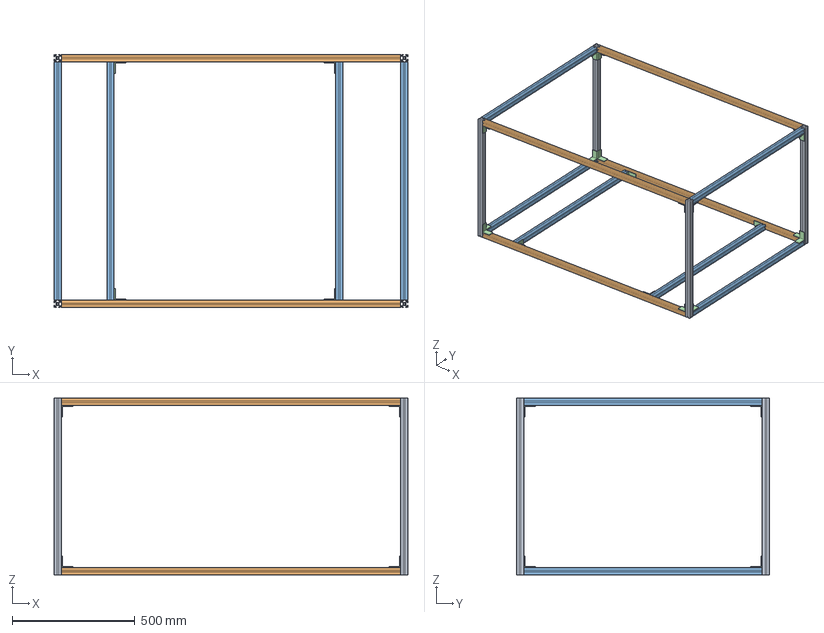
[picture p26: CAD file, 2026-09-24]
cad/step/chamber_frame.step
1440.0 x 1030.0 x 720.0 mm
post_FL
post_FR
post_BL
post_BR
beam_x_FB
beam_x_FT
beam_x_BB
beam_x_BT
beam_y_LB
beam_y_LT
beam_y_RB
beam_y_RT
floor_rib_L
floor_rib_R
bracket_20 x 20
