SunoopDogg/airo-tips/cad/step/chamber_panel.step

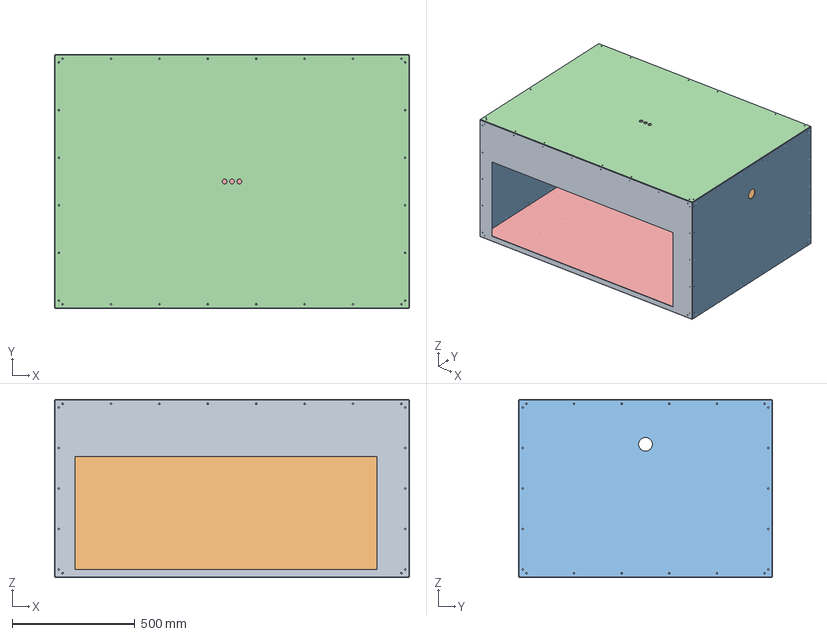
[picture p27: CAD file, 2026-09-24]
cad/step/chamber_panel.step
1446.0 x 1036.0 x 726.0 mm
panel_front
panel_back
panel_right x 2
panel_top
panel_bottom
