SunoopDogg/airo-tips/(list of files, cad)

Other CAD files:
cad/step/exhaust_port.step
cad/dxf/control_board.dxf
cad/dxf/door.dxf
cad/dxf/door_gasket.dxf
cad/dxf/extender_board.dxf
