SunoopDogg/airo-tips/cad/pdf/control_board.pdf

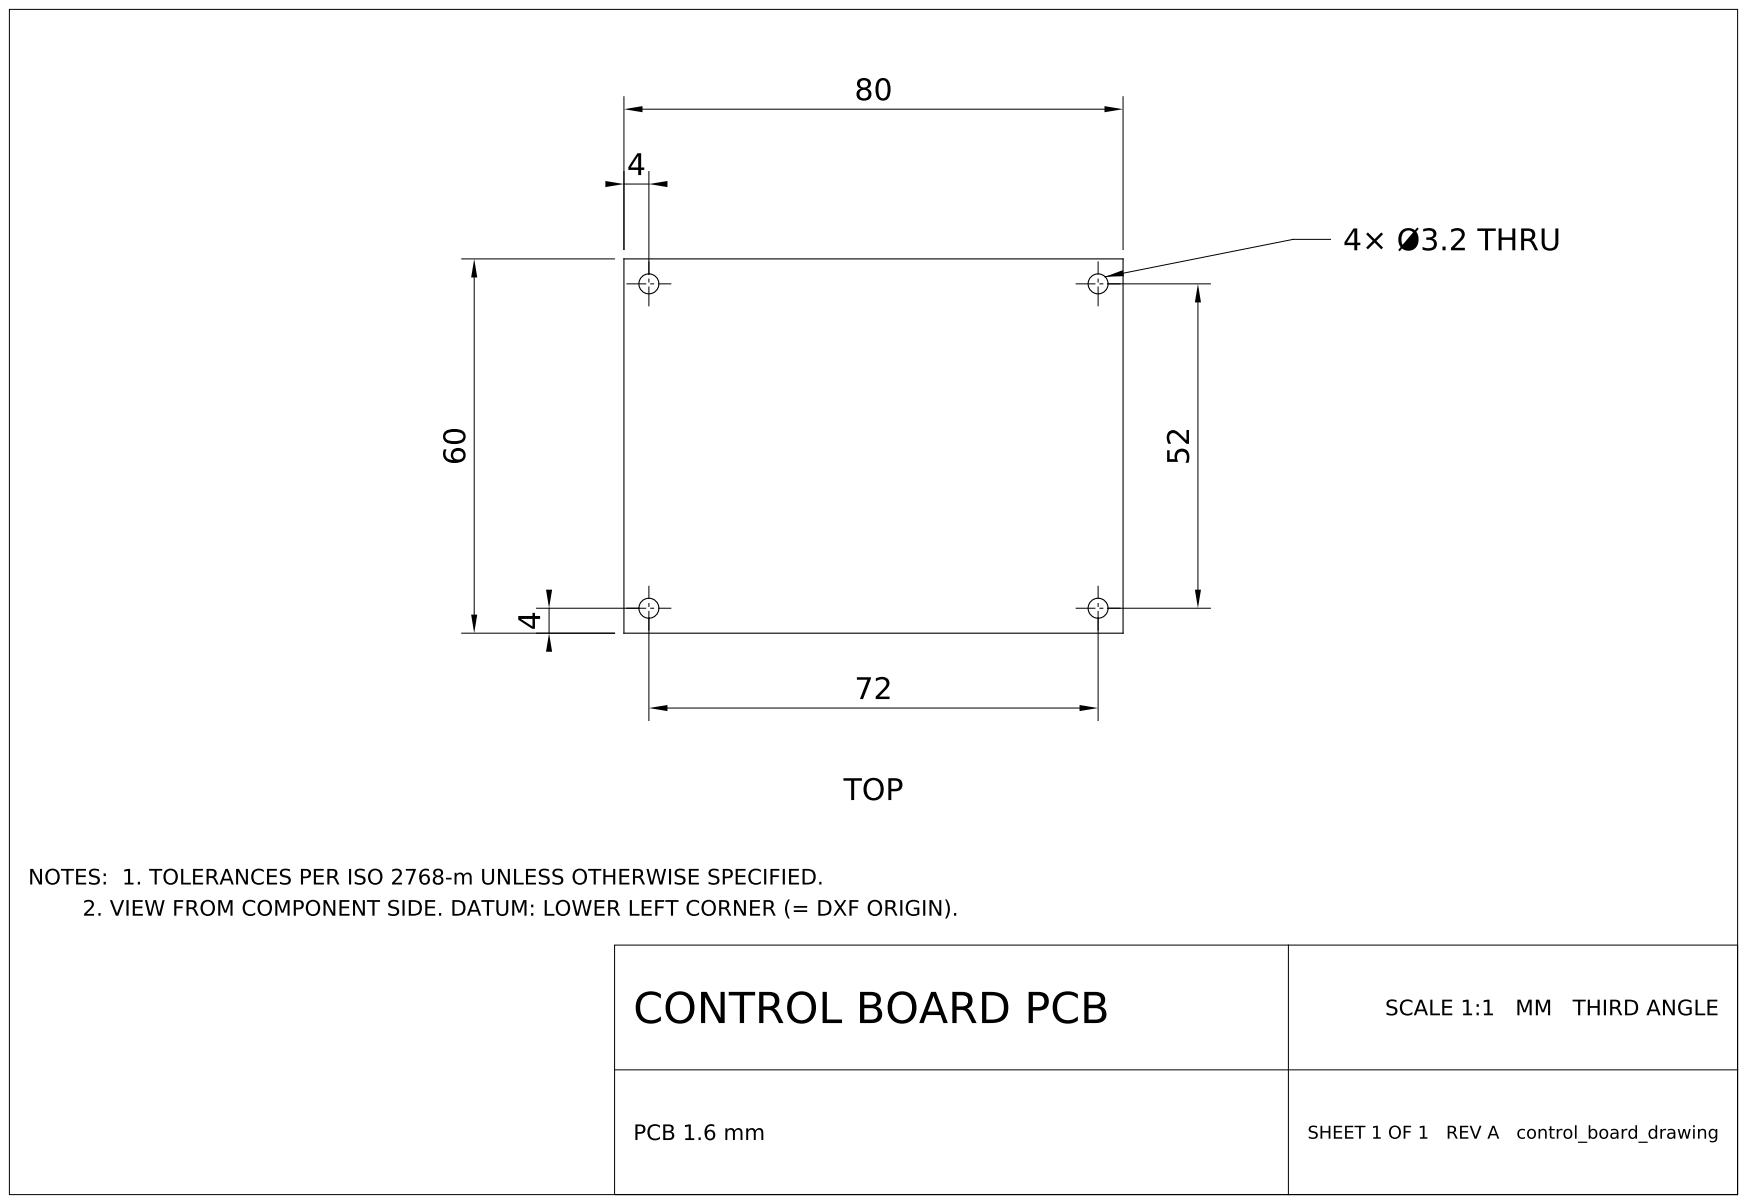
[picture p34: page 1]
