SunoopDogg/airo-tips/cad/pdf/door.pdf

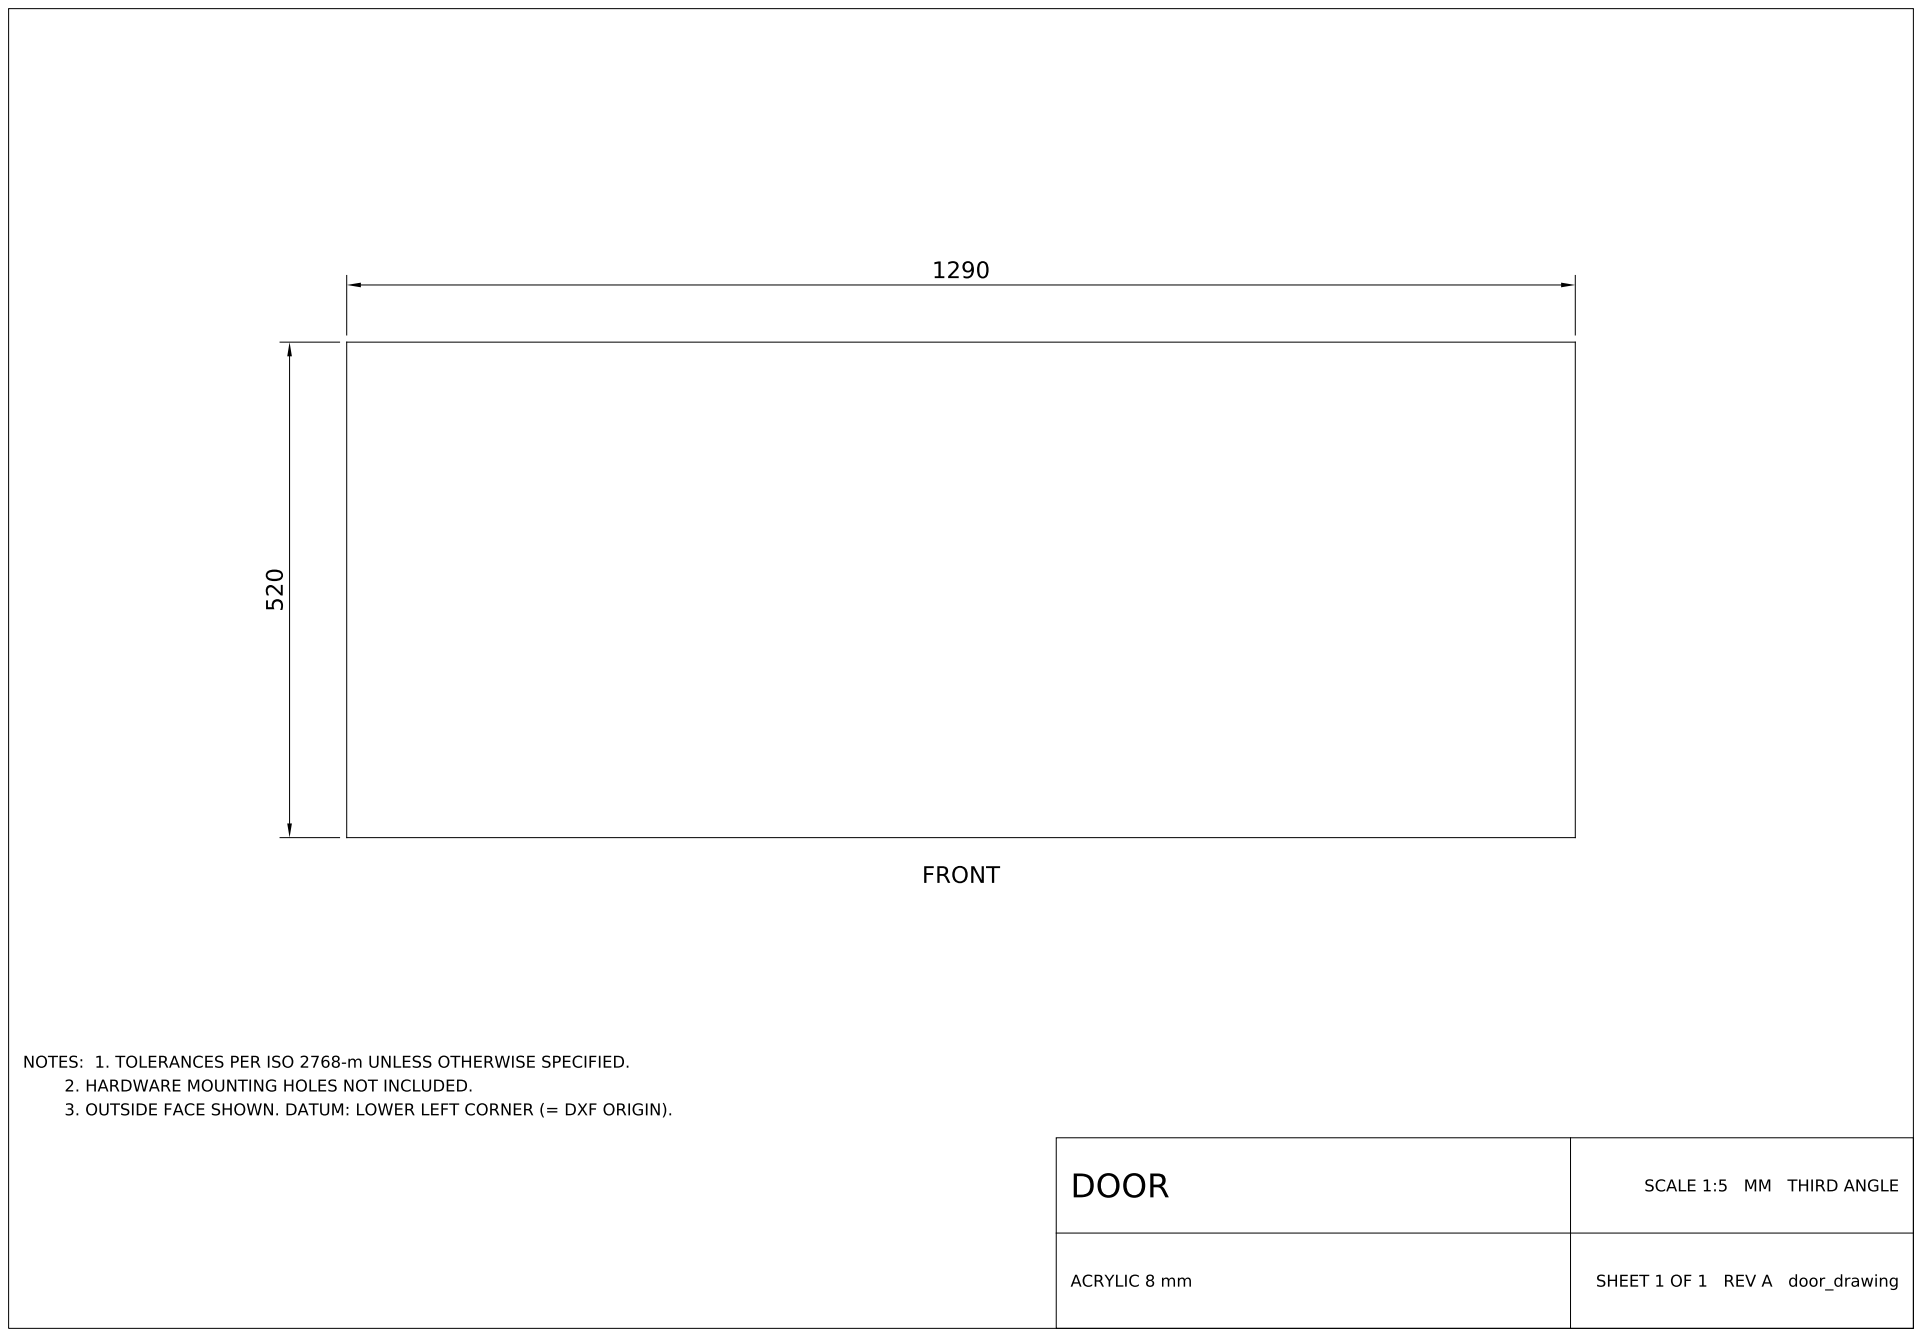
[picture p35: page 1]
