SunoopDogg/airo-tips/cad/pdf/door_gasket.pdf

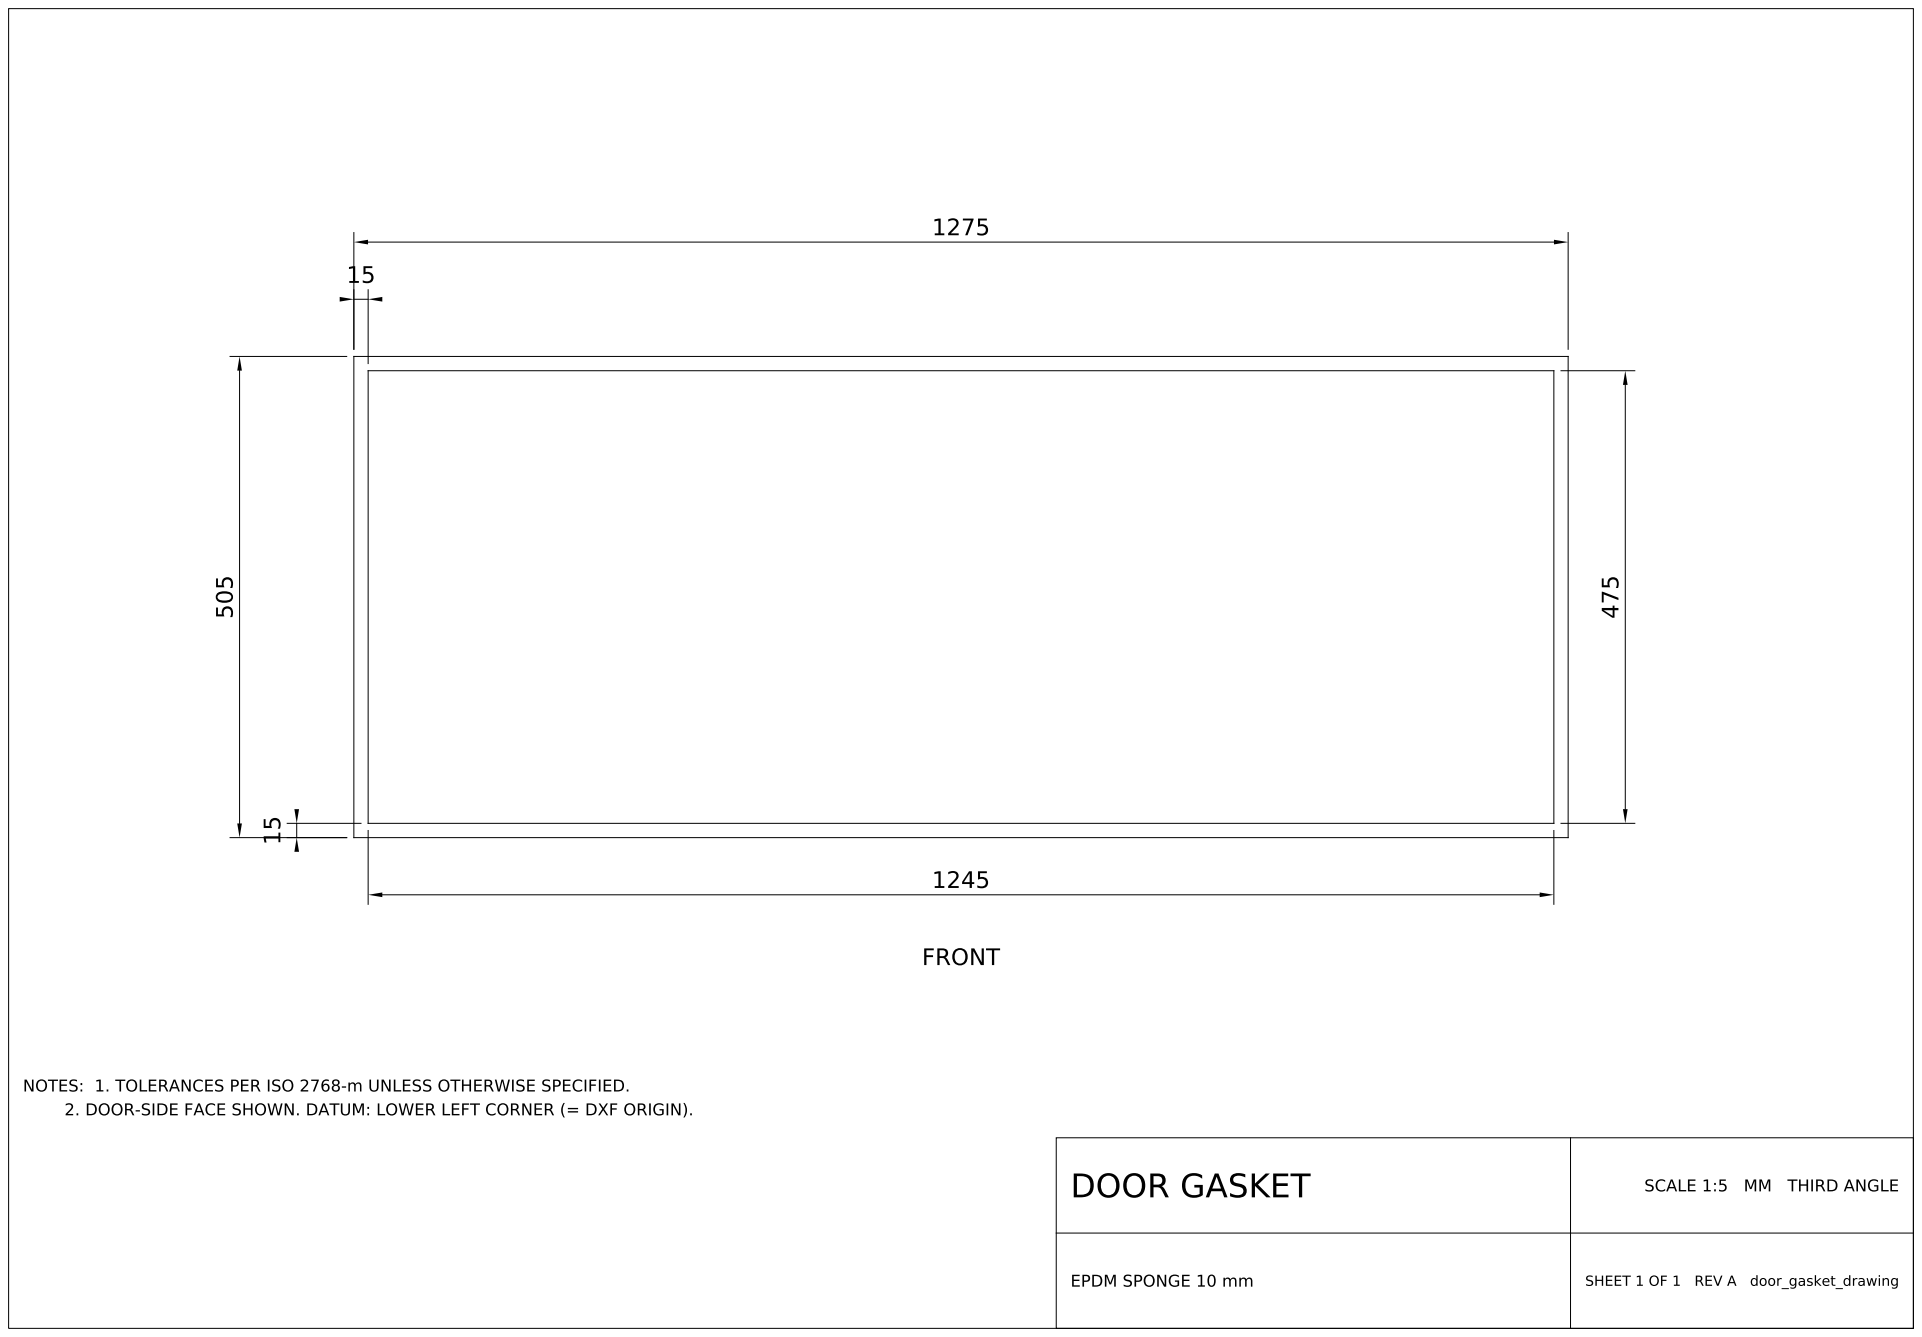
[picture p36: page 1]
