SunoopDogg/airo-tips/cad/pdf/extender_board.pdf

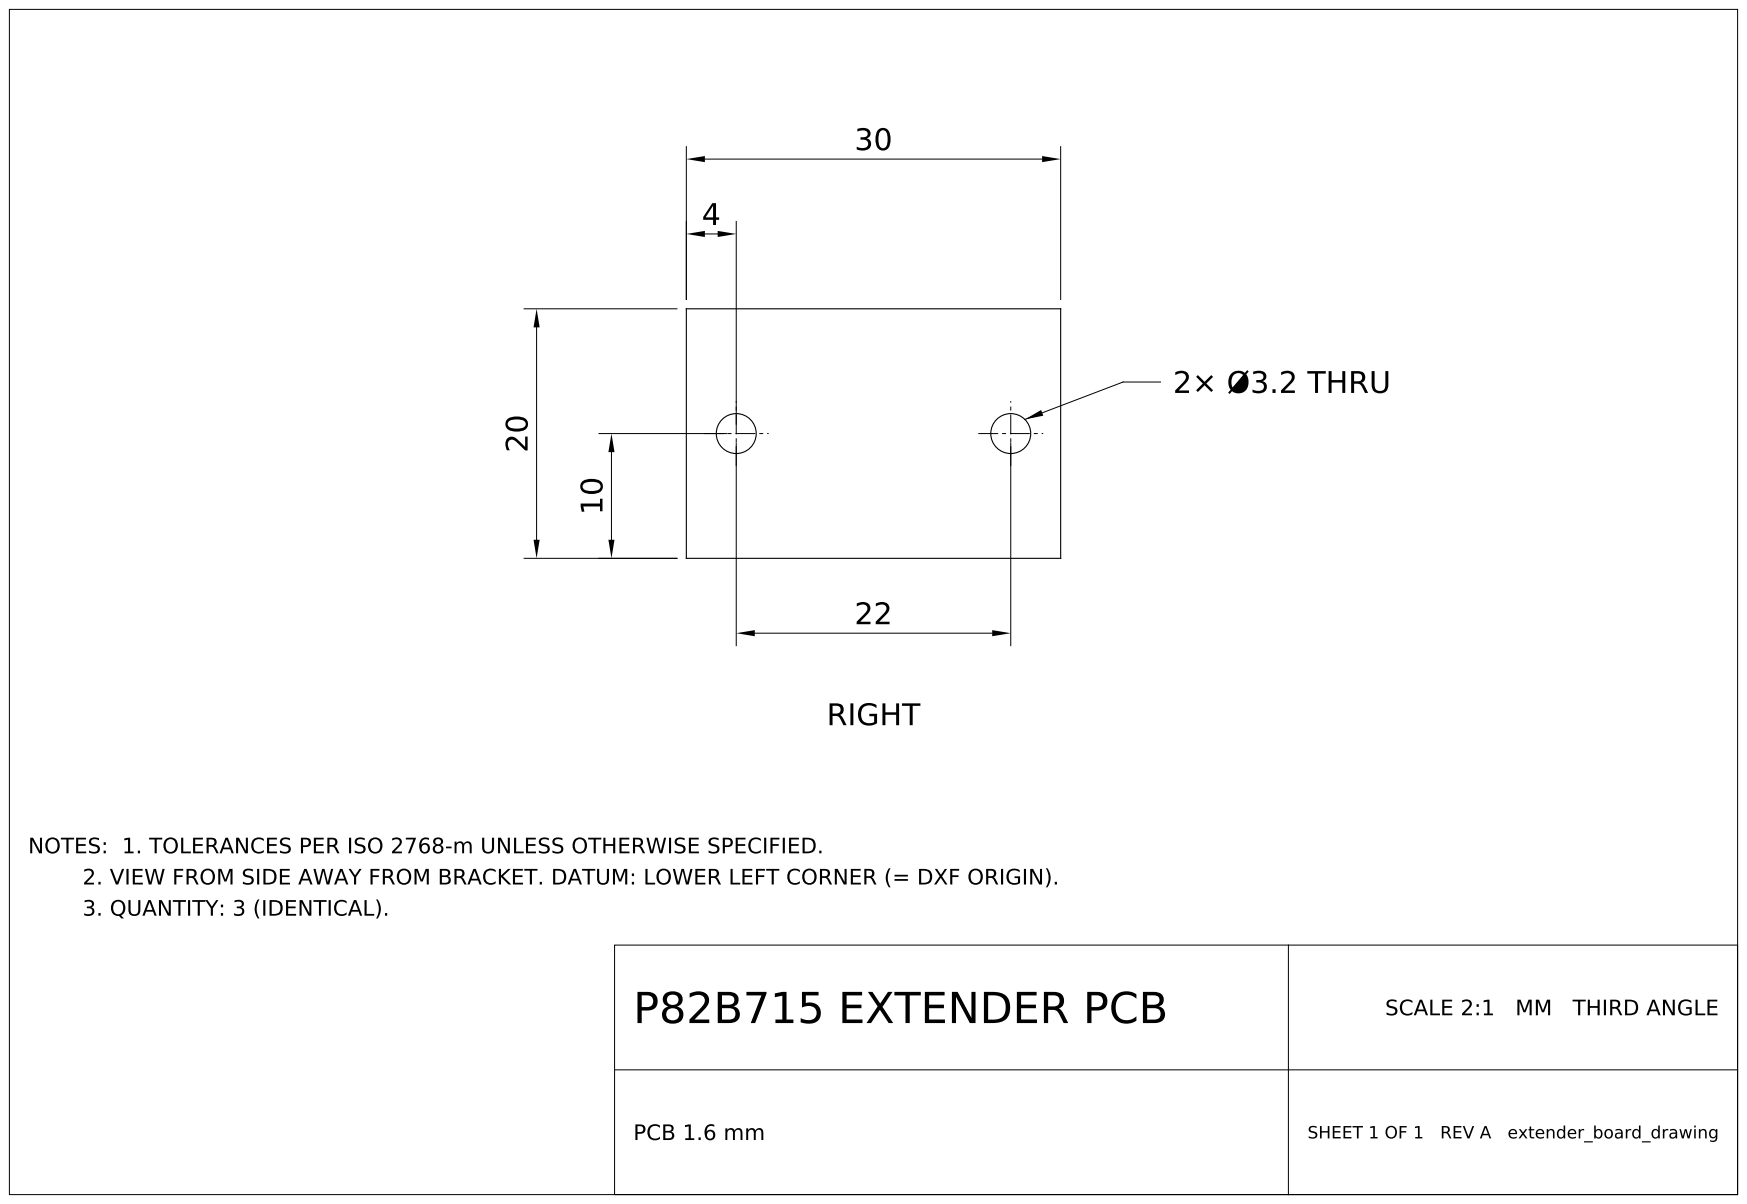
[picture p37: page 1]
