SunoopDogg/airo-tips/(commit log)

2026-08-10 Initial commit: airo-tips 위키
    ESS 열폭주 조기감지 프로젝트 지식 베이스. raw/ 원문, wiki/ 페이지,
    index.md, log.md, 스킬 정의, 모의장치 도면 스크립트.
    [chamber.dxf, chamber.obj, chamber.stl, sen55.dxf, 이스트오토_정량적항목_최종.xlsx]
2026-08-10 센서·컨트롤러 계통 인제스트와 스키마 보강
    초기 커밋 이후의 위키 작업 8건을 담는다 (log.md 항목 기준).
    - Sensirion SEN5x, ESP32-S3-WROOM-1, PCA9548A, P82B715 데이터시트를 인제스트하고
    source 페이지 4개와 SEN55·ESP32-S3-WROOM-1·PCA9548A·P82B715·VOC Index 페이지를 만듦.
    - 사용자 확인으로 모의장치의 센서 운용, 컨트롤러 연결, 멀티플렉서 채널 배정, 전장 배치
    (센서만 챔버 내부), 배선 연장 검토를 정리. 배선 10 cm 권고와 챔버 벽 통과의 충돌을
    모의장치 Contradictions에 남김.
    - 2023 논문 그림 4에서 벤팅 약 170–180℃, 열폭주 피크 약 550℃를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
2026-08-10 위키 타입을 topic + source 둘로 합침
    entity·concept·note 세 타입을 topic 하나로 합치고 wiki/topics/로 모은다.
    남는 타입은 topic, source, overview 셋이다.
    source는 유지한다. 프론트매터가 다르고(sources: [] + source_path + ingested),
    원문에 충실해야 한다는 쓰기 규칙이 다르며, 인용 그래프의 뿌리다.
    entity와 concept는 프론트매터도 쓰기 규칙도 읽기 경로도 같았다. 실제로 가르는 것은
    파일이 어느 폴더에 떨어지느냐뿐인데, 그 대가로 스키마가 "경계가 애매한 것들의 판정"
    절을 유지해야 했고 인제스트는 새 페이지마다 그 표를 찾아봐야 했다.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
2026-08-10 source 페이지에서 원문 밖 서술을 걷어냄
    source 페이지가 답하는 질문은 "이 원문은 무엇을 말하는가" 하나인데, 다섯 페이지가
    위키의 판정과 프로젝트 사실을 함께 싣고 있었다. wiki-ingest §5의 4부 구성에 없는
    "이 위키에서의 위치"·"이 위키 관점에서의 한계" 절, 다른 원문과의 교차 판정,
    `(사용자 확인 …)`, 인용 지침이 대상이다.
    삭제 전에 전부 topic 페이지에서 대조했다. 판정은 이미 배터리 화재감지 5단계의
    ## Contradictions, 정량적 성과지표, 열폭주, 모의장치에 인용과 함께 있다. 중복이 없던
    유일한 항목 — 논문 표6 마지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
2026-08-10 저장소의 모든 .md에 소프트랩 적용
    CLAUDE.md와 세 스킬 문서가 100자 안팎에서 하드랩돼 있었다. 한 문단이 여러 줄로
    쪼개져 있으면 문장 하나를 고칠 때마다 문단 전체를 다시 접어야 하고, diff가 내용이
    아니라 줄바꿈 위치를 보여 준다.
    한 문단을 한 줄로 폈다. 줄바꿈은 문단·목록 항목·표 행처럼 구조가 바뀌는 자리에만
    두고 줄 길이는 편집기의 소프트랩에 맡긴다. 코드펜스·표·헤딩·목록 경계는 건드리지
    않았고, 파일마다 공백 정규화 후 텍스트가 원본과 같은지 확인한 뒤에 썼다.
    wiki/ 22페이지와 index.md는 이미 규칙을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
2026-08-10 ingest와 lint가 끝날 때 커밋하도록 규약 변경
    "커밋은 사용자가 요청할 때만 한다"를 세 작업에 한해 뒤집는다. ingest와 lint는
    log.md 항목 하나를 남기고 끝나는데, 그 항목이 가리키는 변경이 커밋되지 않은 채
    다음 작업의 변경과 섞이면 로그와 이력이 어긋난다. 한 작업 = 한 커밋 = log.md 항목
    하나로 묶는다.
    check.py 오류 0을 커밋의 선행 조건으로 둔다. 그 작업이 바꾼 것을 전부 한 커밋에
    담게 한 것도 같은 이유다 — 페이지와 index.md를 갈라 담으면 어느 커밋도 단독으로
    lint를 통과하지 못한다.
    query는 답을 페이지에 파일링했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
2026-08-10 스킬 문서의 마지막 단계를 커밋으로 옮김
    세 스킬 모두 마지막 단계가 "check.py 오류 0이어야 끝이다"였다. CLAUDE.md가
    ingest·lint의 끝을 커밋으로 정한 뒤로는 이 문장이 정면으로 어긋나므로, 오류 0을
    선행 조건으로 낮추고 커밋을 마지막 단계로 놓는다.
    규약 자체는 옮겨 적지 않고 CLAUDE.md의 "커밋"을 가리킨다. 스킬 문서는 순서만
    정하고 결과물의 모양은 스키마가 정한다는 기존 분담 그대로다.
2026-08-10 챔버 도면을 REV J로 올려 전장을 챔버 밖으로 뺌
    위키가 topics/sources 2계층으로 재구성되면서 도면이 근거로 삼던 페이지와
    결정이 바뀌었는데 design/은 그대로였다.
    전장 배치가 가장 크게 바뀐다. REV I는 ESP32-S3와 PCA9548A를 챔버 내부
    후방 좌측 상단 모서리에 300x150x120으로 제안했으나 사람 미승인이었고,
    지금 확정된 것은 챔버 내부에 SEN55 3대만 두고 나머지 전장은 챔버 상단
    외부에 둔다는 것이다. 제안을 폐기하면서 3면도의 전장 사각형과 지시선,
    전용 레이어, 그리고 그 도형만 보던 검사 18을 함께 지웠다. 확정 여유
    clearance.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
    [chamber.dxf]
2026-08-12 CATL EnerX-0.5P O&M 매뉴얼을 인제스트해 상용 ESS의 화재 판정 사례를 위키에 더함
    지표 3 모의장치의 참고자료로, 상용 컨테이너가 H2·CO·열·연기 검출기의 조합으로 등급을 나누고 가스 경보를 최우선 트리거로 환기·PCS 차단에 묶는다는 점을 화재감지 5단계·벤팅 가스·열폭주 페이지에 붙였다. 상용 BMS가 실제로 내는 데이터와 Modbus/CAN 인터페이스, CAT 1~7 고장등급은 ESS-BMS 연동 데이터에서 이 프로젝트의 7종과 대조했다. 매뉴얼이 Rev 1.0 초안이라 절마다 셀 구성·랙당 모듈 수 같은 수치가 어긋나는 곳은 source 페이지에 원문 상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
2026-08-12 모의장치 본체 BOM을 도면 파라미터에서 생성하고 확인된 구매 링크를 붙임
    지표 3 모의장치를 실제로 만들려면 도면이 확정한 치수와 설계서 13장의 구매·제작
    요구사항이 한 장에 모여 있어야 한다. 둘을 손으로 옮겨 적으면 REV가 오를 때마다
    어긋나므로, chamber_params.json·sen55_params.json을 그대로 읽어 bom.xlsx를 만드는
    생성기를 도면 생성기 옆에 둔다. xlsx는 zipfile과 inlineStr로 직접 쓴다. 도면
    생성기 둘이 지키는 표준 라이브러리 전용 규칙을 셋째 생성기가 깨지 않기 위해서다.
    담는 범위는 모의장치 본체 — 챔버 구조물, 챔버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
    [bom.xlsx]
2026-08-12 설계서의 죽은 위키링크를 풀어 평문으로 되돌림
    위키 재구성으로 사라진 페이지를 가리키는 링크가 64곳 남아 있었다.
    열 개 이름 중 다섯(RPM-5120V314AS1, ESS 시스템 구성, 블로커 현황,
    ESS 화재 감지·소화 계통, KCL)은 후신이 아예 없고, 나머지도 어느
    현행 페이지로 옮길지가 문맥마다 갈린다. 특히 "지표 3 배터리 화재감지
    단계 분류"는 지표 이름 그대로여서 정량적 성과지표와 배터리 화재감지
    5단계 어느 쪽으로도 읽힌다. 확인할 수 없는 것을 추측해 다시 걸기보다
    대괄호만 걷어내 평문으로 두었다. 살아 있는 SEN55 링크 두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
2026-08-12 챔버 상판 외부의 전장 공간을 REV K로 도면에 표시
    REV J는 전장이 챔버 밖이라는 확정만 남기고 도형을 지웠다. 그릴 치수가
    없어서였다. 치수는 REV I가 챔버 내부에 제안했던 300x150x120을 그대로
    쓰고 위치는 상판 중앙으로 한다는 지시가 나와, 다시 그릴 수 있게 됐다.
    치수 세 개는 proposed로 둔다. 실제 전장함이 선정되지 않았고 이 값은
    폐기된 내부 제안에서 옮겨온 것이라 아직 대상물을 주장하지 않는다.
    위치만 fixed다. 좌우·전후 오프셋은 파라미터에 두지 않았다. 상판 중앙은
    외형 치수에서 나오는 종속값이라 저장해 두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
    [chamber.dxf]
2026-08-12 전장 치수를 확정하고 SEN55 3대를 천장면 정삼각형으로 옮김
    전장 공간 300x150x120은 승인을 받아 proposed에서 fixed로 올린다.
    도면 라벨의 "(제안)" 표기도 함께 뗀다. 파라미터가 미승인인데 도면은
    확정처럼 보이는 상태를 만들지 않기 위해 둘을 같이 옮겼다. 공간이
    확정된 것이지 부품이 정해진 것은 아니므로 전장함 미선정은 그대로 남긴다.
    센서 3점은 지금까지 정면도에만, 좌·중·우 비율과 어긋난 높이로 그려져
    있었다. 시트 배치용 표기였을 뿐 실제 위치가 아니었다. 이제 천장면
    z=750에서 내부 평면 중심을 중심으로 하는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
    [chamber.dxf]
2026-08-12 챔버 도면에서 주기 블록을 걷어내 REV M으로 올림
    도면에 인쇄되던 주기 10개 항목을 지운다. 표제란은 남는다.
    주기가 담고 있던 것 — 재질과 밀폐 등급, 센서 배치, 포트 구경이
    종속값이라는 사실, 배수 포트가 없다는 것, 전장 배치, I2C 구성 — 은
    전부 README와 chamber_params.json이 이미 담고 있다. 같은 내용을 두
    곳에서 관리하면 한쪽만 고쳐진 판본이 나오므로 도면 쪽을 접었다.
    어디를 봐야 하는지는 README 머리말에 적었다.
    주기·표제란의 비중첩을 보던 검사는 대상이 사라져 함께 지웠고 검사는
    18개가 되었다. 코드 docstring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
    [chamber.dxf]
2026-08-12 3D 모델을 2D 도면 REV M에 맞추고 SEN55를 실제 형상으로 세움
    3D 생성기는 REV I 상태에 멈춰 있어 실행조차 되지 않았다. 두 생성기가
    chamber_params.json 하나를 공유하는데 그 파일이 REV J-M을 거치며 바뀌었기
    때문이다.
    전장 설치 공간을 챔버 내부 (0, 940, 630) 에서 외부 상판 중앙 (225, 470, 753)
    으로 옮긴다. 좌우·전후 오프셋은 파라미터에 두지 않고 외형 치수에서 중앙
    계산으로 구한다 — 2D 와 같은 결정이다. 챔버 밖이므로 내부 자유 체적에서
    차감하지 않아 0.518850 이 0.524250 m3 로 돌아간다.
    센서 3점을 상부 일렬에서 천장면 정삼각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
    [chamber.obj, chamber.stl]
2026-08-13 design 디렉터리를 이 워크트리에서 제거
    도면·3D 모델·설계서 생성물을 이 워크트리에서 걷어낸다. 이력에 남아 있으므로
    필요하면 이전 커밋에서 되살린다.
    [bom.xlsx, chamber.dxf, chamber.obj, chamber.stl, sen55.dxf]
2026-08-13 SolidWorks 도면 계층 cad/ 를 세움
    지표 3 모의장치를 실제로 만들려면 제작 도면이 있어야 하는데, 이전 파이썬 생성기
    계층은 92e0391 에서 제거됐다. 같은 자리를 GUI CAD 로 다시 세우되 그 계층이 지켰던
    규율 하나는 가져온다 — 치수를 스케치에 박아 넣지 않고 params/chamber.txt 한 곳에
    두고 방정식으로 링크한다. 부품·조립품·도면이 같은 파일을 봐야 값 하나가 바뀔 때
    셋이 함께 따라온다.
    export/ 를 필수로 둔 이유는 .SLDDRW 가 바이너리이기 때문이다. PDF 는 발주사·제작처
    가 보는 판이고, DXF 는 SolidWorks 가 없는 환경에서 도면 내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
2026-09-18 도커 이미지에 cadgen 실행 의존성을 넣음
    text-to-cad 플러그인의 cadgen은 이 PC에서 직접 돌지 않는다. Smart App Control이
    uv가 받은 Python의 python313.dll과 CAD 커널 OCP의 DLL을 서명 정책으로 막는다.
    리눅스 컨테이너에서는 막히지 않으므로 실행을 도커로 옮기고, 그때 비어 있던 두
    가지를 이미지에 넣는다.
    Node 22는 STL·3MF·DXF 빌더가 Node로 돌기 때문이다. nvm은 이미 있었지만 설치된
    버전이 없었고, nvm.sh를 읽지 않는 셸에서도 보이도록 /usr/local/bin에 링크한다.
    Chromium 시스템 라이브러리는 PNG 스냅샷 렌더러가 헤드리스 Chromium을 쓰기
    때문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
2026-09-18 cadgen을 임시 컨테이너에서 실행하는 cad/cadgen 스크립트를 둠
    상시 실행 중인 airo-tips 컨테이너는 메인 체크아웃 하나만 마운트하고, 실행 중인
    컨테이너에는 볼륨을 새로 붙일 수 없다. CAD 작업은 여러 워크트리에서 하므로 명령마다
    docker run --rm으로 임시 컨테이너를 띄우고 그때의 git 워크트리 루트를 /work에
    붙인다. 스크립트가 저장소 안에 있으니 새 워크트리에도 따라간다.
    임시 컨테이너는 매번 비어 있으므로 uv 캐시와 uv가 받은 Python을 cadgen-cache 볼륨에
    둔다. Python은 기본 위치가 캐시 밖이라 UV_PYTHON_INSTALL_DIR로 옮기지 않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
2026-09-18 cad/CLAUDE.md에 text-to-cad 실행 규칙을 적음
    플러그인 스킬 문서는 cadgen을 호스트에서 uvx로 실행하라고 안내한다. 이 PC에서는
    그 명령이 Smart App Control에 막히므로, 스킬을 읽은 에이전트가 그대로 따르지 않도록
    cad/ 아래에서 자동으로 읽히는 CLAUDE.md에 대체 규칙을 둔다. cad/README.md는 도면
    계층의 규약을 담는 문서라 실행 방법을 섞지 않았다.
    담은 것은 스킬 표기와 cad/cadgen 명령의 대응, 워크트리 밖 경로와 호스트 절대경로가
    컨테이너에서 보이지 않는다는 경로 규칙, 뷰어 대신 PNG 스냅샷으로 형상을 확인한다는
    것, 이미지와 DI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
2026-09-18 cad/cadgen의 줄바꿈을 LF로 고정함
    core.autocrlf가 켜진 체크아웃에서는 cad/cadgen이 CRLF로 풀린다. bash는 줄 끝의 \r을 명령의 일부로 읽어 셔뱅부터 실패하므로, 새 워크트리에서도 스크립트가 그대로 돌도록 이 파일만 LF로 고정한다.
2026-09-18 cad/를 SolidWorks 도면에서 text-to-cad 부품 형상으로 바꿈
    도면을 SolidWorks 대신 text-to-cad의 Python 모델과 STEP으로 만들기로 해서, 디렉터리를 src/와 step/ 둘로 줄이고 규약을 cad/CLAUDE.md 하나로 모았다. 치수의 단일 출처는 방정식 링크 파일 대신 src/params.py가 맡고, 근거 대장 chamber.md는 cad/ 바로 아래로 옮겼다. SolidWorks 임시 파일 규칙은 지우고 스냅샷을 두는 cad/tmp/를 git에서 뺐다.
2026-09-18 지표 3 모의장치 구성 부품과 CAD 파일 목록을 cad/parts.md에 정리함
    모의장치를 이루는 부품마다 직접 모델링할지 벤더 STEP을 받을지, 어느 파일이 될지, 무엇이 정해져야 형상이 나오는지를 한곳에서 보기 위해서다. 조건 조성 장비·카메라·PC처럼 장치 밖에서 쓰는 것은 구성 부품이 아니므로 넣지 않았다.
2026-09-18 ESP32-S3-WROOM-1 벤더 STEP을 받아 cad/step/imported/에 둠
    컨트롤러 모듈의 형상을 조립품에서 그대로 불러 쓰기 위해서다. step.parts에 등록된 KiCad 3D 라이브러리 모델을 체크섬을 맞춰 받았고, 폴더 규칙에 따라 원본 파일명을 유지했다. 이 모델은 N16R8 같은 메모리 변형을 구분하지 않는다. parts.md에 벤더 STEP을 받은 상태를 뜻하는 "확보"를 두고 ESP32 항목을 그 상태로 옮겼다.
    [ESP32-S3-WROOM-1.step]
2026-09-18 cad/parts.md를 위키와 대조해 빠진 부품을 더하고 근거 없는 주문 코드를 뺌
    부품마다 위키에 근거가 있는지 다시 확인했다. SEN55의 주문 코드는 위키 어디에도 없어 지웠다. 도어를 여닫으려면 경첩이 있어야 하고, SEN5x 데이터시트가 밝힌 케이블측 커넥터는 관통부 구경을 정하며, 전원과 통신을 USB 하나로 묶었으니 전장함에 USB가 나갈 구멍이 필요하다. 이 셋을 목록에 더했다.
2026-09-19 SEN55 벤더 STEP을 받아 cad/step/imported/에 둠
    센서 노드의 형상을 조립품과 브래킷 설계에서 불러 쓰기 위해서다. step.parts에는 없어 Sensirion SEN55 제품 페이지가 배포하는 SEN5x 계열 공통 STEP을 원본 파일명 그대로 받았다. 원점이 외곽 중심이 아니어서 조립품에서 옮겨 써야 한다. 외형 치수는 아직 위키에 없으므로 이 STEP에서 잰 값을 브래킷 치수의 근거로 쓰지 않는다고 parts.md에 적었다.
    [Sensirion_STEP_SEN5x.STEP]
2026-09-19 ingest | 사용자 확인 · 모의장치 챔버 구성과 P82B715 채택
    사용자가 확인한 챔버 형상 결정과 SEN55 천장 배치, 자체 PCB, P82B715 채택을 위키에 반영했다. 도면 계층이 이 결정을 쓰려면 근거가 위키에 먼저 있어야 한다. 차폐 케이블 사용 여부와 모든 치수는 아직 정해지지 않았으므로 미정으로 남겼다.
2026-09-19 챔버 형상 결정을 cad/chamber.md와 cad/parts.md에 반영함
    더미 팩, 3030 프로파일과 알루미늄 복합판, 오른쪽 경첩의 앞면 여닫이 아크릴 도어와 토글 클램프, 양 옆면의 주입·배기 포트, 캐스터, SEN55 천장 120° 배치, 자체 PCB, P82B715 채택을 사용자 결정으로 적었다. 관찰창과 받침 프레임은 도어와 캐스터로 대체되어 부품에서 빠졌고, P82B715 센서측 기판은 후보에서 확정 부품이 되었다. 확정된 치수는 프로파일 규격 하나이고 나머지는 미정 값으로 남겼다.
2026-09-19 ingest | 사용자 확인 · 모의장치 더미 팩과 챔버 세부
    더미가 본뜨는 ESS 모듈의 사양과 외형, 놓는 자세를 위키에 적었다. 챔버 내부 치수가 이 외형에서 출발하므로 도면이 쓰기 전에 근거가 위키에 있어야 한다. 외형은 사양서 없이 사용자가 기억으로 제시한 값이라 그 성질을 함께 남겼다. 패널·도어 두께, 경첩·클램프·손잡이, 포트 높이, 캐스터, SEN55 중심 거리 결정도 같은 절에 더했다.
2026-09-19 더미 팩 외형과 챔버 세부 결정을 cad/chamber.md와 cad/parts.md에 반영함
    더미 팩 외형 1130 × 810 × 260 mm(눕혀 놓음, 1개), 패널 3 mm, 아크릴 도어 8 mm를 확정 치수로 적었다. 사슬의 맨 위가 채워져 더미 팩은 모델링할 수 있게 되었고, 다음 단추는 팩 둘레 여유다. 경첩 3개, 토글 클램프 2개, 손잡이, 브레이크 캐스터, 옆면 가운데의 포트 높이, 천장 크기를 따르는 SEN55 반지름도 함께 적었다. 확정값이 들어오면서 미정 값 표를 치수 대장으로 바꿨다.
2026-09-19 ingest | 사용자 확인 · 모의장치 팩 받침과 SEN55 케이블 경로
    더미 팩 받침, SEN55 기준 방향, 케이블 관통 위치를 위키에 적었다. 내부 높이와 천장 구멍 위치가 이 결정에서 나오므로 도면보다 먼저 근거를 두었다.
2026-09-19 ingest | 사용자 확인 · 모의장치 내부 치수와 포트 높이
    팩 둘레 여유가 정해져 챔버 내부 치수가 나왔다. 옆면 가운데의 포트가 팩 옆면을 정면으로 향하게 되는 문제가 있어, 포트 높이를 팩 윗면과 천장의 가운데로 바꾼 결정도 함께 적었다.
2026-09-19 팩 받침과 둘레 여유, 내부 치수를 cad/chamber.md와 cad/parts.md에 반영함
    더미 팩을 3030 세로 다리 레일로 100 mm 띄우고, 둘레 여유를 앞·뒤 80, 왼쪽 100, 오른쪽 150, 위 300 mm로 정해 내부 유효 치수 1380 × 970 × 660 mm와 팩 위치가 나왔다. 옆면 가운데의 포트가 팩 옆면을 정면으로 향하는 문제가 있어 포트 높이를 팩 윗면과 천장의 가운데(510 mm)로 바꿨다. SEN55 기준 방향과 천장 케이블 관통 위치, 팩 받침 레일 부품도 함께 적었다.
2026-09-19 ingest | Sensirion SEN5x Datasheet · 외형 치수
    SEN55 브래킷 치수의 근거가 되도록 데이터시트 7.1절 외형도의 치수를 위키에 옮겼다. 외형도는 그림이라 처음 인제스트 때 텍스트로 잡히지 않았다.
2026-09-19 ingest | 사용자 확인 · 모의장치 패널 체결, 도어 개구, SEN55 배치, 받침 레일
    첫 조립 모델에 필요한 마지막 형상 결정을 위키에 적었다. 패널을 바깥면에 덧대므로 내부 치수가 골조 안쪽 면 기준으로 유지되고, 도어 개구와 SEN55 반지름·이격, 받침 레일 위치가 정해졌다.
2026-09-19 패널 체결, 도어 개구, SEN55 외형·배치, 받침 레일을 cad/chamber.md와 cad/parts.md에 반영함
    패널을 골조 바깥면에 덧대므로 외형 1446 × 1036 × 726 mm가 나왔고, 도어 개구 1230 × 460 mm, 받침 레일 위치, SEN55 외형(위키에 인제스트한 데이터시트 값)과 반지름·천장 이격·평면 위치를 적었다. 이로써 더미 팩, 외함 골조, 외함 패널을 모델링할 수 있다. 앞서 근거 없다고 지운 SEN55-SDN-T는 위키 SEN55 페이지에 정품명으로 있어 되돌렸다.
2026-09-19 ingest | 사용자 확인 · 모의장치 골조 이음, 바닥, 도어 철물, 포트 구경, 전장부
    부품을 모델링하기 전에 남아 있던 형상 결정을 받아 모의장치의 챔버 구성 절에 반영했다. 잠금 철물은 누름형 토글 클램프 대신 당겨 잠그는 토글 래치로 바뀌었다.
2026-09-19 골조 이음, 바닥, 도어 철물, 포트, 센서 브래킷, 전장부 결정을 cad/chamber.md와 cad/parts.md에 반영함
    부품 모델링 루프를 시작하기 전에 남아 있던 형상 결정과 제작 세부 치수를 받아, 모든 부품을 근거 있는 값만으로 모델링할 수 있게 했다. 철물·캐스터·글랜드는 step.parts의 범용 모델로 정했고 구매품이 정해지면 바꾼다.
2026-09-19 앞면 아래 변 패널 볼트와 받침 블록 머리 자리를 cad/chamber.md에 반영함
    밀폐재가 지나는 앞면 패널 아래 변과 패널 볼트 위에 놓이는 받침 블록이 서로 부딪혀, 사용자가 정한 처리 방식을 적었다.
2026-09-19 ingest | 사용자 확인 · 모의장치 도어 잠금 철물
    도어 앞면과 같은 평면에 단 토글 래치는 도어를 옆으로만 당겨 밀폐재를 누르지 못하므로, 사용자가 처음 정한 누름형 토글 클램프로 되돌렸다.
2026-09-19 도어 잠금을 누름형 토글 클램프로 cad/chamber.md와 cad/parts.md에 되돌림
    도어 앞면과 같은 평면에 단 토글 래치는 밀폐재를 누르지 못하므로, 누름형 클램프의 대표 형상을 직접 그리고 치수는 작업 가정으로 두기로 했다.
2026-09-20 cad/chamber.md의 SEN55 평면 위치를 정밀값으로 고치고 P82B715 기판 구멍 지름을 적음
    뒤쪽 두 대의 y는 485 + 242.5 · sin 30° = 606.25이고 x도 반올림 전 값이 479.99·900.01이라, 식과 표가 어긋나지 않게 했다. 센서측 기판의 M3 구멍은 전장 기판과 같은 Ø3.2로 적었다.
2026-09-20 더미 팩과 공유 치수 params.py를 모델링함
    cad/chamber.md 치수 대장의 수치를 모두 params.py 상수로 옮기고, dependent 값은 식으로 계산해 표의 수치와 같은지 대조했다. 더미 팩은 1130 × 810 × 260 mm 상자를 x 100–1230, y 80–890, z 100–360에 놓았다. 독립 리뷰 2라운드에서 통과했다.
    [pack.step]
2026-09-20 골조 코너 브래킷을 L자 부품으로 cad/chamber.md에 바꿈
    처음 정한 step.parts 부품이 L자가 아닌 평판이라 안쪽 모서리에 달 수 없어, 사용자가 corner_bracket_3030_single_simple로 바꾸기로 했다.
2026-09-20 외함 골조를 모델링함
    3030 B형 슬롯 8 단면(step.parts)으로 세로재 4개를 통짜로, 수평재 8개와 바닥 보강재 2개를 그 사이에 넣고, 수평재 끝마다 L자 코너 브래킷 20개를 챔버 안쪽 모서리에 놓았다. 독립 리뷰 1라운드에서 통과했다. 브래킷 날개 끝과 도어 개구 사이 여유는 2.75 mm라 실제 구매품을 고를 때 날개 길이를 확인해야 한다.
    [chamber_frame.step, corner_bracket_3030_single_simple.step, profile_3030_b_slot8.step]
2026-09-20 팩 받침 레일을 모델링함
    3030 B형 슬롯 8 레일 2줄(x 중심 200·1130, y 80–890, z 70–100)과 레일 양 끝의 세로 다리 4개(z 0–70)를 만들었다. 다리는 바닥 보강재 위에 서고 레일 윗면이 더미 팩 밑면에 닿는다. 독립 리뷰 1라운드에서 통과했다.
    [pack_rail.step]
2026-09-20 케이블 글랜드를 대표 형상 직접 모델링으로 cad/chamber.md와 cad/parts.md에 바꿈
    step.parts의 M20 글랜드는 외경 44 × 높이 28 관 하나로 된 외곽 모델이라 정해 둔 간격 30에도 전장함 안에도 들어가지 않는다. 간격·배치·전장함 크기를 지키려고 토글 클램프처럼 대표 형상을 직접 그리기로 했다. 루프 중 추천안 자동 선택이고 사용자 확인을 기다린다.
2026-09-20 외함 패널을 모델링함
    3 mm 패널 6장을 골조 바깥면 크기 그대로 덧대고, 앞면 도어 개구, 옆면 포트 구멍 Ø56, 천장 글랜드 구멍 Ø20 세 개(간격 30), 부재 중심선 위 M6 볼트 구멍(Ø6.5, 200 mm 이하 간격)을 냈다. 앞면 아래 변은 밀폐재를 피해 양 끝에만 구멍을 냈다. 독립 리뷰 1라운드에서 통과했다.
    [cable_gland_panel_hole_cutter_m20.step, chamber_panel.step]
2026-09-21 도어를 모델링함
    8 mm 아크릴 판 1290 × 520 mm를 개구 둘레에 30 mm씩 겹쳐 x 20–1310, z −30–490에 두고, 밀폐재에 닿은 압착 전 위치 y −51–−43에 놓았다. 독립 리뷰 1라운드에서 통과했다.
    [door.step]
2026-09-21 도어 밀폐재를 모델링함
    EPDM 스펀지 사각 링(단면 15 × 10 mm)을 앞면 패널 바깥면의 개구 둘레, 겹침 폭 가운데(개구에서 7.5–22.5 mm)에 압착 전 두께로 놓았다. 독립 리뷰 1라운드에서 통과했다.
    [door_gasket.step]
2026-09-21 도어 경첩을 대표 형상 직접 모델링으로 cad/chamber.md와 cad/parts.md에 바꿈
    step.parts의 50 × 50 맞대기 경첩은 날개 폭이 0.05 mm인 결함 모델이고 같은 생성기의 다른 경첩도 같아서, 펼친 전체 50 × 50(날개 하나 25 × 50)의 대표 형상을 직접 그리기로 했다. 루프 중 추천안 자동 선택이고 사용자 확인을 기다린다.
2026-09-21 손잡이와 캐스터를 대표 형상 직접 모델링으로 cad/chamber.md와 cad/parts.md에 바꿈
    step.parts의 당김 손잡이는 봉이 기둥에서 2 mm 떠 있고, 캐스터는 바퀴가 장착판을 뚫고 올라와 둘 다 그대로 쓸 수 없다. 사용자가 정한 간격 128 mm와 바퀴 지름 100 mm는 지키고 나머지 형상 치수는 작업 가정으로 둔다. 루프 중 추천안 자동 선택이고 사용자 확인을 기다린다.
2026-09-21 도어 경첩을 모델링함
    50 × 50 맞대기 경첩 대표 형상(날개 하나 25 × 50, 너클 원기둥) 3개를 도어 판 오른쪽 변 x 1310에 z 440·230·20으로 놓고, 프레임 쪽 날개 밑에 18 mm 받침 블록을 두어 두 날개가 도어 앞면 평면에 펼쳐지게 했다. 날개 두께 2, 너클 지름 7은 작업 가정이다. 독립 리뷰 1라운드에서 통과했다.
    [door_hinge.step]
2026-09-21 토글 클램프를 모델링함
    누름형 수직 토글 클램프 대표 형상 2개를 도어 왼쪽 앞면 패널에 z 440·20으로 달고, 잠긴 상태에서 스핀들 패드가 도어 판 앞면을 밀폐재 띠 위에서 누르게 했다. 아래 클램프 받침판은 패널 볼트 머리 자리를 품는다. 형상 치수는 작업 가정이다. 독립 리뷰 1라운드에서 통과했다.
    [toggle_clamp.step]
2026-09-21 도어 손잡이를 모델링함
    장착 간격 128 mm 당김 손잡이 대표 형상(기둥 2개와 봉이 한 몸)을 도어 판 앞면 x 60, 기둥 축 z 166·294에 세로로 달았다. 기둥·봉 지름과 손가락 틈은 작업 가정이다. 독립 리뷰 1라운드에서 통과했다.
    [door_handle.step]
2026-09-21 cad/chamber.md 손잡이 행에 기둥 축 높이를 적음
    손잡이 리뷰에서 params.py의 기둥 축 z 166·294가 표에 숫자로 없다는 참고가 나와, 경첩·클램프 행과 같은 형식으로 적었다.
2026-09-22 cad/chamber.md 포트 행에 플랜지 구멍 지름과 마개 끝판 두께를 적음
    명세가 준 M5 통과 구멍 Ø5.5와 마개 끝판 두께 3이 표에 숫자로 없어, 패널 볼트 구멍과 같은 틈새 규칙과 마개 벽 두께에서 맞춘 값임을 밝혀 적었다.
2026-09-22 주입·배기 포트를 모델링함
    내경 50 · 외경 56 알루미늄 관과 외경 100 × 5 플랜지(M5 구멍 4개 PCD 80)를 한 몸으로, 끼움형 마개를 따로 그려 오른쪽(주입)과 왼쪽(배기) 옆면 y 485 · z 510에 놓았다. 형상 함수는 inlet_port.py에 두고 exhaust_port.py가 쓴다. 독립 리뷰 1라운드에서 통과했고, 플랜지 구멍 지름을 params.py로 옮기라는 권장 지적이 남았다.
    [exhaust_port.step, inlet_port.step]
2026-09-22 cad/chamber.md SEN55 브래킷 행에 M4 통과 구멍 지름을 적음
    명세가 준 Ø4.5가 표에 숫자로 없어, 패널 볼트 구멍과 같은 틈새 규칙에서 맞춘 값임을 밝혀 적었다.
2026-09-22 SEN55 브래킷을 모델링함
    PETG 클립 브래킷 3개를 천장 패널 안쪽 면에 M4 볼트 2개로 달고, 모듈을 수평·평평한 면 위·커넥터가 천장 중심 쪽인 자세로 20 mm 아래에 잡게 했다. 흡입·배출구와 커넥터 쪽은 열어 두고, 뒤 벽에 P82B715 기판 자리를 냈다. 벤더 SEN55와 기판을 놓는 자세 함수도 같은 파일에 두었다. 클립 턱·걸림·팔 폭·볼트 간격은 작업 가정이다. 독립 리뷰 1라운드에서 통과했고, Ø4.5를 params.py로 옮기는 것과 주석 값 정정이 권장으로 남았다.
    [sen55_bracket.step]
2026-09-22 P82B715 센서측 기판을 모델링함
    30 × 20 × 1.6 mm 기판 3장에 M3 구멍(Ø3.2) 2개를 내고, SEN55 브래킷의 기판 자세 함수로 브래킷 뒤 벽에 구멍 축을 맞춰 놓았다. 소자는 그리지 않는다. 독립 리뷰 1라운드에서 통과했다.
    [extender_board.step]
2026-09-22 케이블 글랜드를 모델링함
    M20 플라스틱 케이블 글랜드 대표 형상 3개를 천장 중심 x 660·690·720에 두고, 몸체와 돔 너트는 챔버 안쪽, 나사부는 천장 패널과 전장함 바닥을 지나며 잠금 너트는 전장함 바닥 위(높이 5 mm)에 오게 했다. 형상 치수는 작업 가정이고 쓰지 않게 된 step.parts id 상수를 params.py에서 지웠다. 독립 리뷰 1라운드에서 통과했다.
    [cable_gland.step]
2026-09-22 cad/chamber.md와 cad/parts.md의 철물 출처 설명을 대표 형상으로 고침
    경첩·토글 클램프·손잡이·캐스터·글랜드를 대표 형상으로 직접 그리기로 바뀐 뒤에도 머리말이 step.parts 범용 모델이라고 적고 있었다.
2026-09-23 전장 기판을 모델링함
    80 × 60 × 1.6 mm 기판을 전장함 안 스탠드오프 위(밑면 z 705)에 놓고 M3 구멍 4개를 냈다. ESP32 모듈 벤더 STEP을 앞쪽 변에 안테나 끝이 앞을 향하게 두고, USB-C 외곽 블록을 뒤쪽 변 가운데에 두었다. 기판 위치는 params.py에 식으로 더했다. 안테나 끝을 앞쪽 변에 맞춘 것은 작업 가정이다. 독립 리뷰 1라운드에서 통과했다.
    [control_board.step]
2026-09-23 전장함을 모델링함
    PETG 3D 프린트 몸체(바깥 94 × 74, 바닥·벽 2, 안쪽 높이 25)와 2 mm 뚜껑을 천장 중심 위에 놓고, 스탠드오프 4개, 바닥 글랜드 구멍 Ø20 세 개, 뒤쪽 벽 USB 구멍 12 × 7을 냈다. 뚜껑 고정 방식은 정해지지 않아 판만 그렸고, 스탠드오프 나사 구멍 Ø2.5는 작업 가정이다. 독립 리뷰 1라운드에서 통과했다.
    [electronics_box.step]
2026-09-23 cad/parts.md 조립품 절을 지금 구성에 맞춤
    캐스터와 글랜드가 직접 모델링으로 바뀌었고 ESP32는 전장 기판 모델에 들어 있어, 조립품이 따로 놓는 벤더 STEP은 SEN55뿐이다.
2026-09-23 캐스터를 모델링함
    바퀴 지름 100 mm 브레이크 달린 회전 캐스터 대표 형상 4개를 바닥 패널 아래 네 모서리에 장착판 바깥 변을 외형 모서리에 맞춰 달았다. 브레이크 페달은 장착판 밖으로 30 mm 내밀어 밟을 수 있게 했다. 장착판·높이·오프셋 등 형상 치수는 작업 가정이고, 쓰지 않게 된 step.parts id 상수를 params.py에서 지웠다. 독립 리뷰 2라운드에서 통과했다.
    [caster.step]
2026-09-23 공유 치수를 params.py로 모으고 브래킷 주석을 바로잡음
    포트 플랜지 M5 구멍 Ø5.5와 SEN55 브래킷 M4 구멍 Ø4.5를 params.py 상수로 옮기고, 글랜드가 따로 계산하던 나사 지름·기판 밑면·스탠드오프 축을 params.py 값으로 바꿨다. 브래킷 앞 팔 끝 주석 값을 실제 값으로 고쳤다. 모든 모델을 다시 빌드한 STEP이 이전과 바이트까지 같아 형상은 바뀌지 않았다. 독립 리뷰 1라운드에서 통과했다.
2026-09-23 모의장치 조립품을 만듦
    부품 모델 17개를 불러 한 문서로 묶고, SEN55 벤더 STEP 3대를 브래킷의 자세 함수로 놓았다. 최상위 개체 20개의 190쌍 전부에서 부품 사이 겹침이 없다. 독립 리뷰 1라운드에서 통과했다.
2026-09-24 조립품에 도어 열림 각도 DOOR_ANGLE을 더함
    STEP은 메이트를 싣지 않아 솔리드웍스에서 열린 모습을 보려면 형상을 그 자세로 써야 한다. assembly.py에 DOOR_ANGLE(기본 0, 닫힘)을 두어 도어 판·손잡이·경첩 도어 쪽 날개를 경첩 너클 축으로 돌리고, 0보다 크면 토글 클램프 암을 젖힌 풀린 자세로 그린다. 기본값에서 조립품은 이전과 같다. 0–90°를 5° 간격으로 돌려 간섭이 없음을 확인했고 독립 리뷰 1라운드에서 통과했다. 클램프 젖힘 축과 각도는 작업 가정이다.
2026-09-24 부품마다 재질 기준 색을 입힘
    사용자가 STEP을 솔리드웍스로 열어 보므로, 솔리드웍스가 읽는 STEP 색(COLOUR_RGB)과 투명도(SURFACE_STYLE_TRANSPARENT)로 부품을 구분한다. 색 값은 src/style.py 한 곳에 재질별 상수로 두고 각 부품 소스가 leaf 개체마다 입힌다. 팔레트와 도어 불투명도 0.3은 사용자 결정이다. 재질이나 표면 색이 정해지지 않은 철물·고무·PETG·PCB·글랜드·더미 팩·패널 색은 표현용으로 고른 값이라 style.py 주석에 그렇게 적었다. SEN55와 ESP32 벤더 STEP은 자기 색을 그대로 둔다.
    형상은 바꾸지 않았다. 다시 빌드한 모든 STEP이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
    [cable_gland.step, caster.step, chamber_frame.step, chamber_panel.step, control_board.step, door.step, door_gasket.step, door_handle.step]
2026-09-25 STEP과 DXF를 git 줄바꿈 변환에서 뺌
    core.autocrlf=true인 Windows 체크아웃에서는 STEP이 CRLF로 풀린다. 그러면 cadgen이 자기가 쓴 출력과 읽는 벤더 입력이 바뀐 것으로 보고 부품을 다시 빌드하고, LF로 다시 쓴 STEP이 내용 변화 없이 git에 변경으로 뜬다. 벤더 STEP의 sha256도 배포 원본과 어긋난다. -text로 두면 저장소의 바이트가 그대로 체크아웃되어 빌드가 current로 남고 step.parts sha256과도 맞는다. 앞으로 커밋할 DXF도 같은 이유로 함께 뺀다.
2026-09-25 가공 도면 DXF의 폴더와 규약을 정함
    판재 부품(외함 패널, 도어, 도어 밀폐재, 기판 외곽)을 레이저·CNC로 자를 DXF를 text-to-cad의 dxf 스킬로 내기로 하면서, 결과물이 어떤 모양이어야 하는지를 먼저 고정한다. 도면이 모델을 불러 펼치기만 하고 새 치수를 만들지 않아야 근거 규칙이 도면까지 이어진다. 철물이 아직 대표 형상이라 장착 구멍은 모델에도 도면에도 내지 않는다. 바깥면·왼쪽 아래 원점·CUT 레이어·kerf 0은 가공업체가 받아 바로 쓰는 형태이고, 앞면 패널 개구와 바닥 보강재 줄처럼 비대칭인 판에서 뒤집힘을 가려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
2026-09-25 cad/CLAUDE.md 가공 도면 면 규칙에서 근거 없는 재질 서술을 뺌
    "알루미늄 복합판은 도장면이 이 면이다"는 원문이나 사용자 결정에 근거가 없는 일반지식이었다. 규칙이 정해야 하는 것은 바깥에서 본 면을 그린다는 것뿐이므로, 패널은 바깥면이 보이는 면이라고만 적는다.
2026-09-25 외함 패널 6장의 가공 도면을 냄
    chamber_panel()을 불러 패널마다 바깥면 하나를 펼치고, 도면 위쪽에 맞게 Z축으로만 돌린 뒤 외곽 왼쪽 아래를 원점으로 옮겼다. 거울 반전을 쓰지 않으므로 도면은 항상 챔버 바깥에서 본 면이고, 앞면 개구(왼쪽 80, 오른쪽 130)와 바닥 보강재 줄(u 280·1210)로 그것이 확인된다. 좌표와 이동량은 모델 형상과 bounding box에서만 나오고 새 치수는 없다. 독립 리뷰 1라운드에서 필수·권장 지적 없이 통과했다. parts.md에 가공 도면 표를 새로 두고, 철물 구매품이 정해지면 장착 구멍을 모델에 더해 도면을 다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
    [panel_back.dxf, panel_bottom.dxf, panel_front.dxf, panel_left.dxf, panel_right.dxf, panel_top.dxf]
2026-09-25 도어의 가공 도면을 냄
    door()를 불러 아크릴 판의 앞면을 펼치고, 챔버 +z가 도면 위쪽이 되도록 Z축으로만 돌린 뒤 외곽 왼쪽 아래를 원점으로 옮겼다. 모델에 구멍이 없으므로 도면은 1290 × 520 외곽 하나다. 회전각 계산은 패널 도면과 같은 코드를 이 파일에 두었다. 패널 도면을 import하면 패널 모델이 바뀔 때마다 도어 도면까지 stale이 되기 때문이다. 독립 리뷰 1라운드에서 필수·권장 지적 없이 통과했다.
    [door.dxf]
2026-09-25 도어 밀폐재의 가공 도면을 냄
    door_gasket()을 불러 EPDM 사각 링의 앞면(도어 판 쪽)을 펼치고, 도어와 같은 방법으로 Z축으로만 돌려 외곽 왼쪽 아래를 원점으로 옮겼다. 바깥과 안쪽의 닫힌 사각형 두 개가 폭 15의 링을 이루고, 두께 10은 재료 두께라 도면에 나오지 않는다. 독립 리뷰 1라운드에서 필수·권장 지적 없이 통과했다.
    [door_gasket.dxf]
2026-09-26 전장 기판 외곽의 가공 도면을 냄
    control_board()에서 pcb 개체만 꺼내 윗면(소자면)을 펼쳤다. ESP32 모듈과 USB-C 블록의 면이 섞이지 않도록 개체를 먼저 고르고, 챔버 +y가 이미 도면 위쪽이라 회전 없이 외곽 왼쪽 아래를 원점으로 옮겼다. 80 × 60 외곽과 M3 구멍 4개가 모두 CIRCLE로 남아 KiCad Edge.Cuts로 그대로 가져갈 수 있다. 독립 리뷰 1라운드에서 필수·권장 지적 없이 통과했다.
    [control_board.dxf]
2026-09-26 P82B715 센서측 기판 외곽의 가공 도면을 냄
    세 기판이 같은 형상이므로 extender_1 하나만 펼쳐 도면 하나로 낸다. 이 기판들은 브래킷 자세를 따라 놓여 면이 챔버 축에 나란하지 않을 수 있어서, 면 선택과 긴 변 방향을 챔버 축이 아니라 extender_board.py가 판을 놓는 변환(기판 자기 좌표)으로 정했다. 브래킷에서 먼 면을 골라 반전 없이 긴 변을 도면 x축에 맞췄고, 검증 스크립트가 같은 방법으로 펼친 extender_2·extender_3도 같은 외곽과 구멍이었다. 독립 리뷰 1라운드에서 필수·권장 지적 없이 통과했다.
    [extender_board.dxf]
2026-09-26 치수 도면 PDF의 폴더와 규약을 정함
    가공용 DXF는 자를 선만 담아 사람이 치수를 읽을 수 없으므로, 같은 판재 부품마다 text-to-cad의 engineering-drawing 스킬로 치수 도면 PDF를 함께 내기로 했다. 결과물의 모양을 먼저 고정한다. 주 뷰와 위치 치수의 기준점을 DXF와 같게 해야 업체가 두 파일을 그대로 맞대어 볼 수 있다. cadgen의 bottom 뷰만 DXF와 180° 달라 바닥 패널은 형상을 돌려 그린다. 컨테이너에 한글 글꼴이 없어 도면 글자는 영문이다. PDF는 같은 내용이면 같은 바이트로 나오므로, 복사본으로 다시 그려 sha256을 대조하는 것을 확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
2026-09-26 외함 패널 6장의 치수 도면을 냄
    chamber_panel()을 불러 패널마다 바깥면 뷰 한 쪽씩, 6쪽짜리 PDF 하나로 그렸다. 주 뷰와 위치 치수의 기준점을 같은 판의 DXF와 같게 해야 업체가 두 파일을 맞대어 볼 수 있으므로, bottom 뷰가 DXF와 180° 다른 바닥 패널은 형상을 외곽 가운데 기준으로 돌려 그렸다. 구멍 줄은 첫·끝 사이와 같은 간격 개수(n× EQ SP)만 적고, n은 bolt_holes()에서 센다. 천장·바닥은 A3에서 치수가 틀 밖으로 나가 A2를 썼다. 독립 리뷰 1라운드에서 필수 지적 없이 통과했고, 복사본으로 다시 그린 PDF가 같은 sha256이었다. 권장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
2026-09-26 도어의 치수 도면을 냄
    door()를 불러 아크릴 판의 앞면 뷰 한 쪽을 그렸다. 모델에 구멍이 없으므로 치수는 외곽 1290 × 520뿐이고, 철물 장착 구멍이 빠진 것이 오류가 아님을 노트로 밝힌다. 주 뷰는 같은 판의 DXF와 같은 면·방향·원점이다. 독립 리뷰 1라운드에서 필수·권장 지적 없이 통과했다.
2026-09-26 도어 밀폐재의 치수 도면을 냄
    door_gasket()을 불러 EPDM 사각 링의 도어 쪽 앞면 뷰 한 쪽을 그렸다. 1:5에서 링 폭 15는 3 mm라 띠를 가로질러 재면 값이 제 치수선에 겹치므로, 안쪽 개구의 크기와 바깥 변에서 들어온 거리 15로 같은 정보를 적었다. 두께 10은 재질 칸이 담는다. 독립 리뷰 1라운드에서 필수·권장 지적 없이 통과했다.
2026-09-26 전장 기판의 치수 도면을 냄
    control_board()에서 pcb 개체만 꺼내 소자면 뷰 한 쪽을 그렸다. 기판 외곽과 구멍의 도면이라 ESP32 모듈과 USB-C 블록은 그리지 않는다. 2:1에서는 치수 줄이 노트 칸에 닿아 명세의 첫 축척인 A4 1:1을 썼다. 외곽 80 × 60, 구멍 4개와 그 위치(모서리에서 4, 사이 72 · 52)를 DXF와 같은 원점에서 적었다. 독립 리뷰 1라운드에서 필수·권장 지적 없이 통과했다.
2026-09-26 P82B715 센서측 기판의 치수 도면을 냄
    세 기판이 같은 형상이므로 extender_1 하나를 브래킷에서 먼 면(+x) 쪽 right 뷰로 그리고, 수량 3을 노트로 밝혔다. 이 뷰가 같은 판의 DXF와 같은 면·방향이고, 기준점은 개체의 bounding box에서 얻어 숫자로 박지 않는다. 판이 작아 A4 2:1로 그렸다. 독립 리뷰 1라운드에서 필수·권장 지적 없이 통과했다.
2026-09-27 도어를 연 조립품을 src/와 step/으로 옮김
    도어를 90° 연 조립품은 cad/tmp/의 스크립트가 만들어 git이 무시하는 자리에 있었다. 그래서 커밋되지 않았고, cadgen이 없는 사람은 열린 모습을 볼 수 없었으며, 부품이 바뀌어도 함께 다시 빌드되지 않았다. src/assembly_door_open.py 모델로 만들고 그 출력을 커밋한다. 형상은 build_assembly(90) 그대로라 tmp/에 있던 STEP과 바이트까지 같다.
2026-09-27 상용 밀폐 챔버 조사를 원문으로 넣음
    모의장치 챔버와 크기가 비슷하거나 조금 큰 상용 챔버가 있는지 웹으로 조사한 기록이다. 나중에 인제스트할 수 있도록 원문 계층에 새 폴더 market-survey/를 만들어 두고, 스키마의 raw/ 트리에도 더했다.
    제조사 페이지는 바뀔 수 있어서 열람한 페이지와 데이터시트를 함께 보관하고 sha256을 적었다. 페이지에 적힌 문구와 조사자 판단은 문서 안에서 나눠 적었다.
    HTML 스냅샷도 -text로 둔다. 줄바꿈이 CRLF인 원본이라, 변환되면 체크아웃 환경에 따라 바이트가 달라져 적어 둔 sha256과 어긋난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
